drajnauth/Phoenix612/Phoenix612 Complete/Version 1.1/Phoenix612 Complete v1.1.jpg

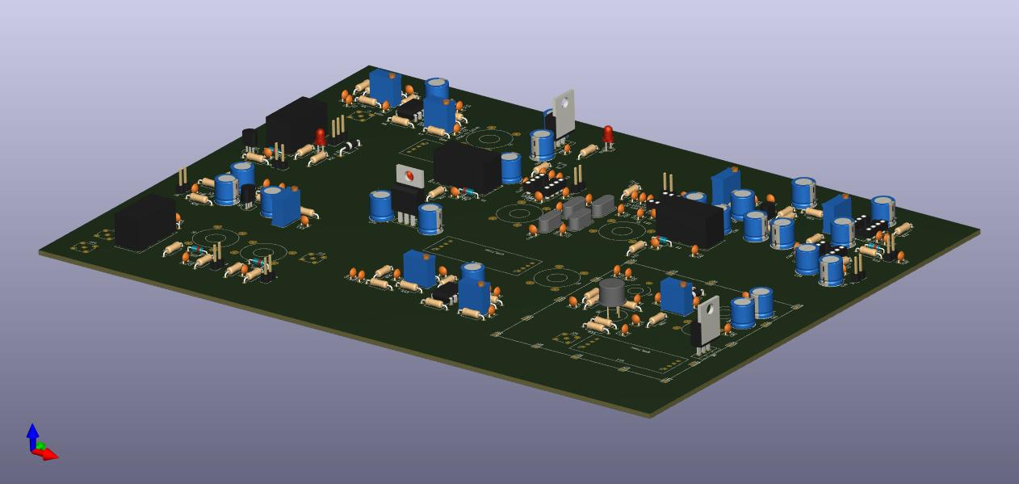
Phoenix612 Complete/Version 1.1/Phoenix612 Complete v1.1.jpg
