drajnauth/Phoenix612/README.md

# Phoenix612
Phoenix612 Transceiver Board

This is the updated `Dueling 612 Tranceiver`.  It contains the KiCad schematic and pcb files as well as other design artifacts.

The project has been renamed to `Phoenix612`
