drajnauth/Phoenix612/Custom KiCad for Phoenix612.docx

Custom Symbols for Phoenix612: Open “Manage Symbol Libraries” and add a library as below.

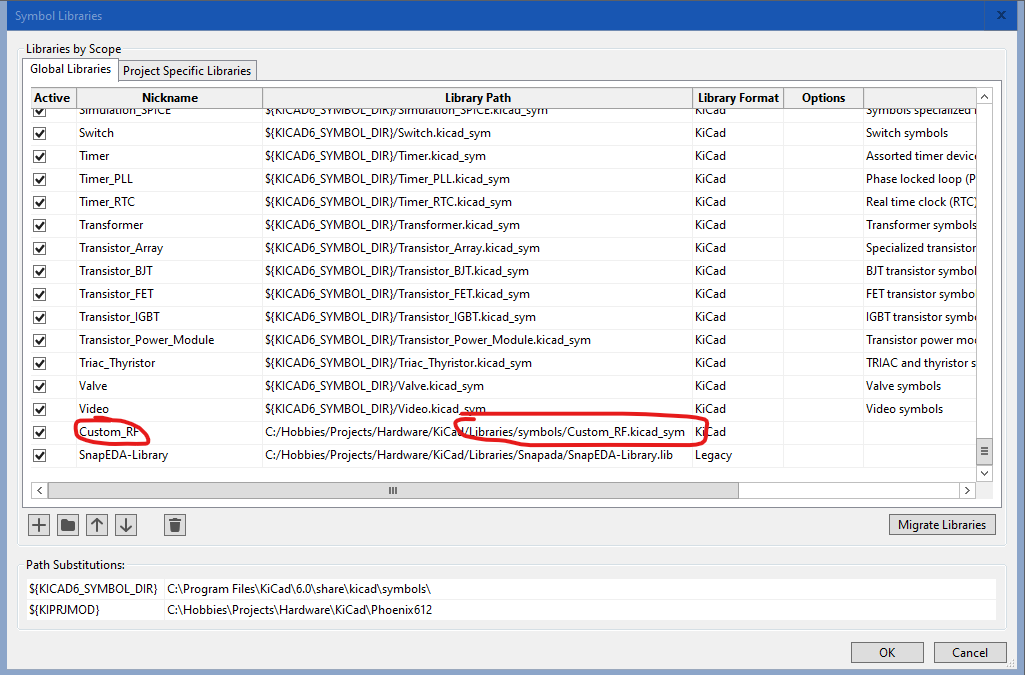
[picture p2: figure]

Custom Footprints for Phoenix 612: Open “Manage Footprint Libraries” and add a library as below.

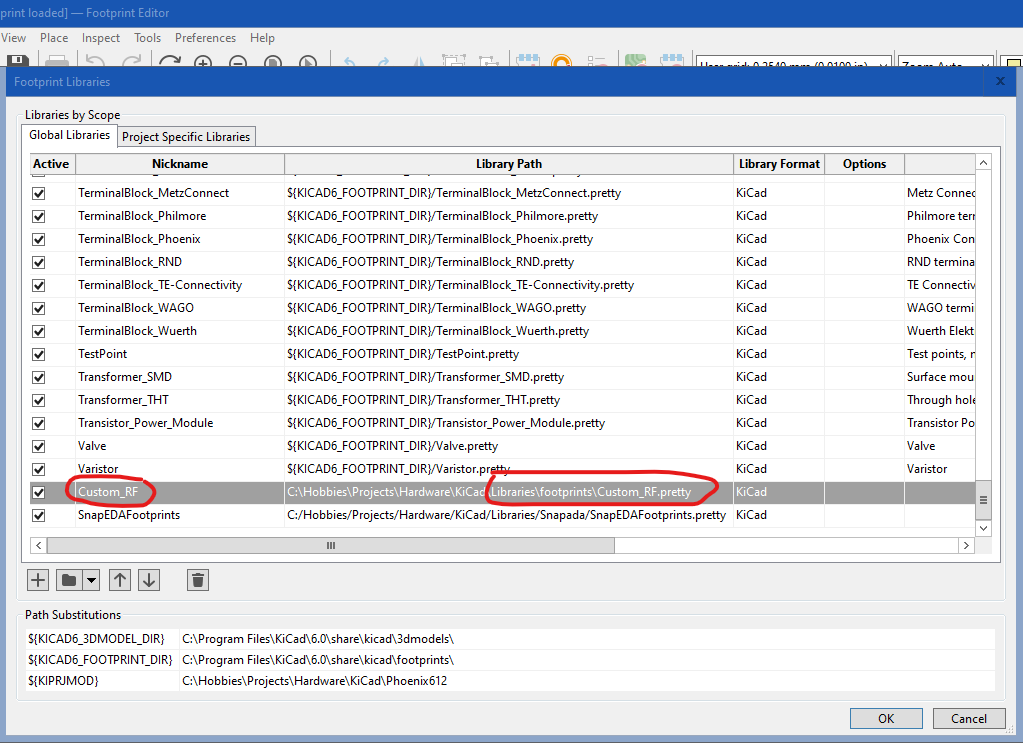
[picture p3: figure]

In symbol editor/browser you should have a new symbol library with custom symbols

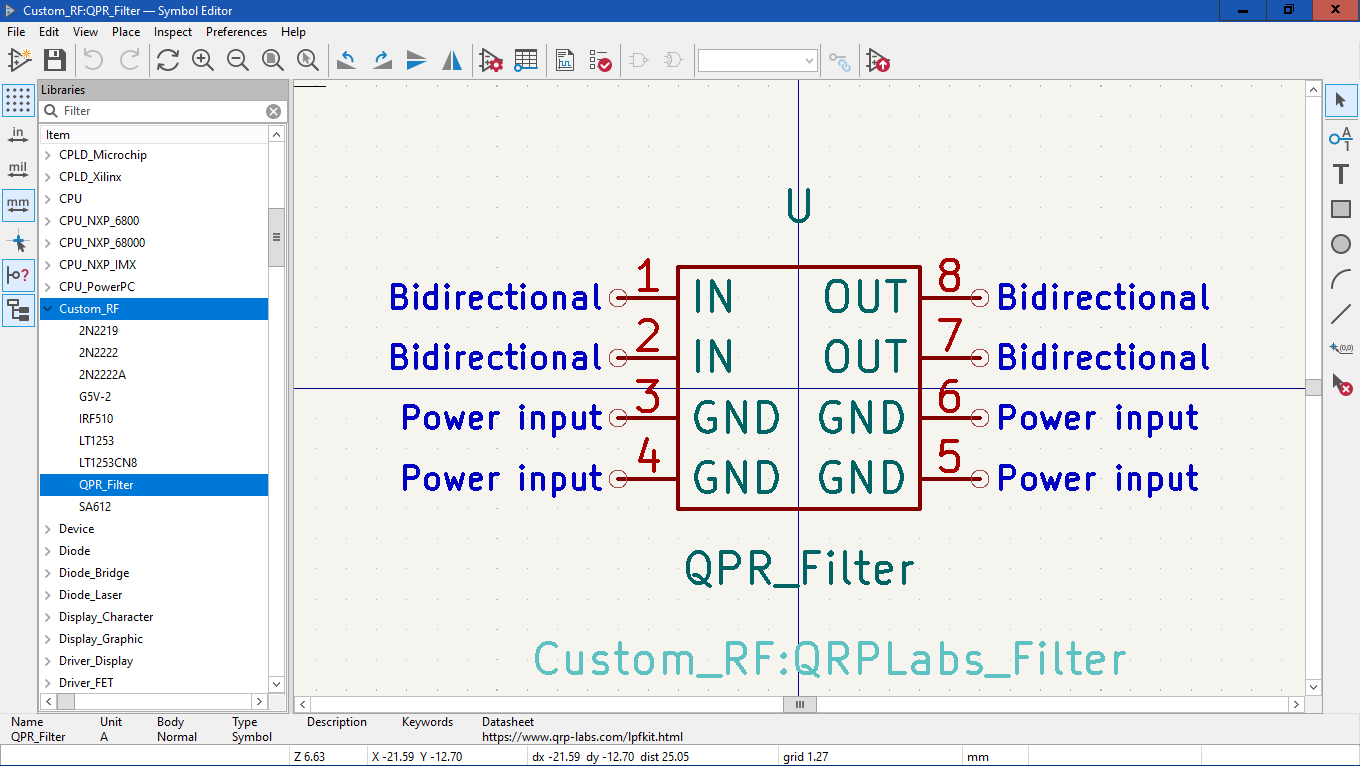
[picture p4: figure]

In footprints editor/browser you should have a new footprint library with custom footprints

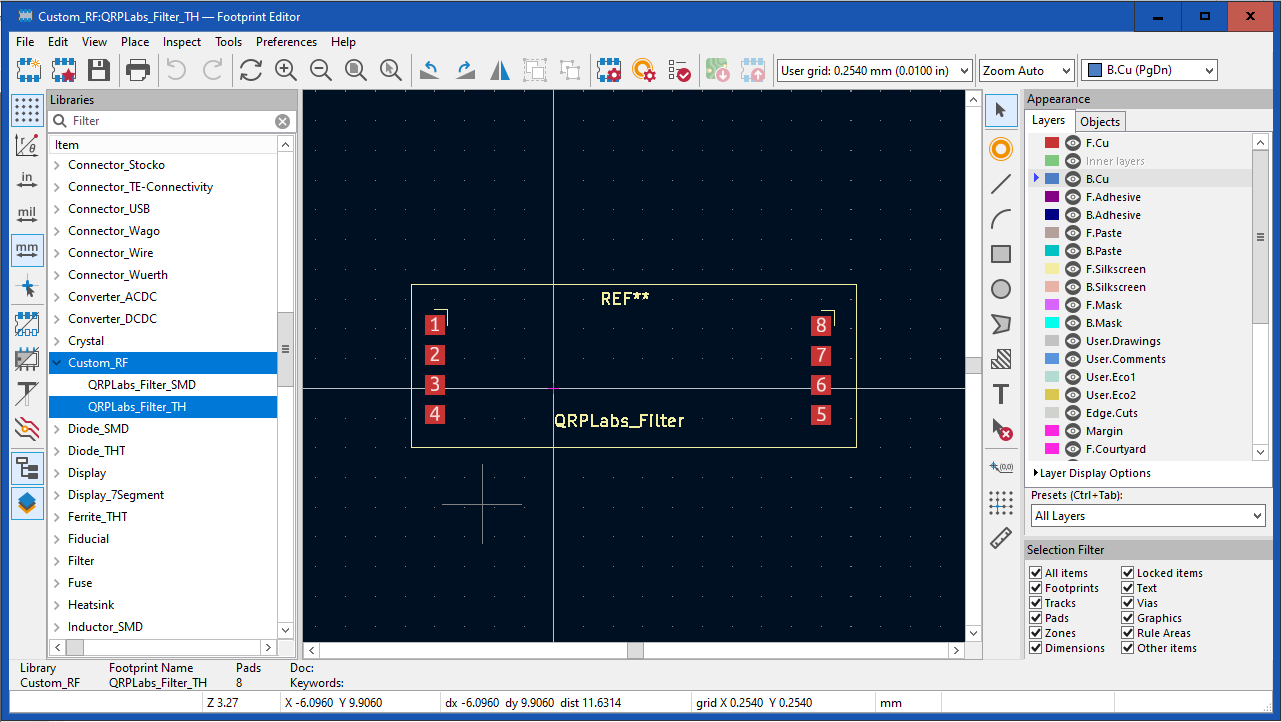
[picture p5: figure]
