drajnauth/Phoenix612/Analysis/Calculations/Power Amp Ideas.docx

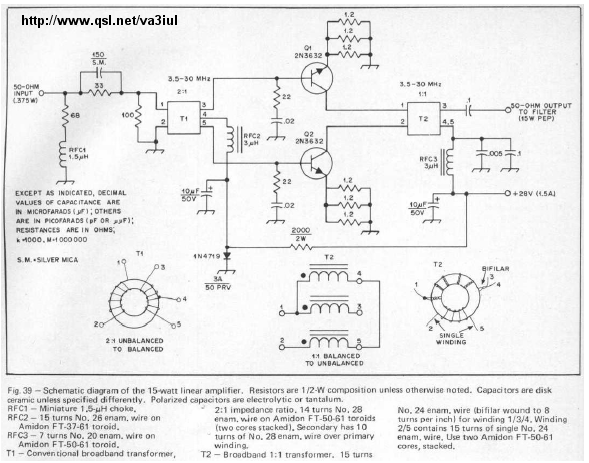
[picture p15: figure]
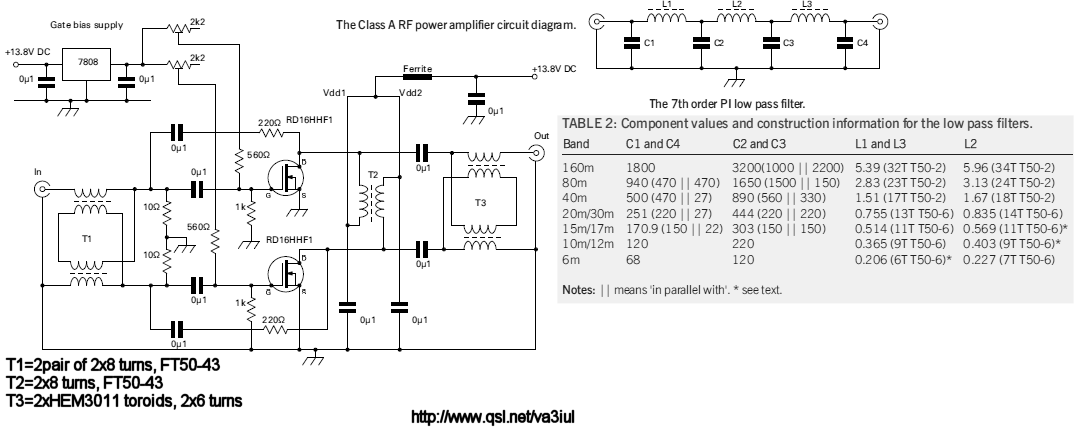
[picture p16: figure]
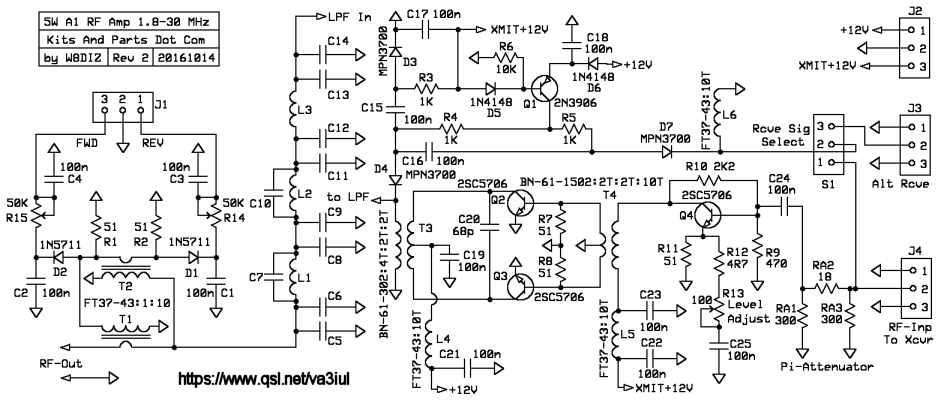
[picture p17: figure]
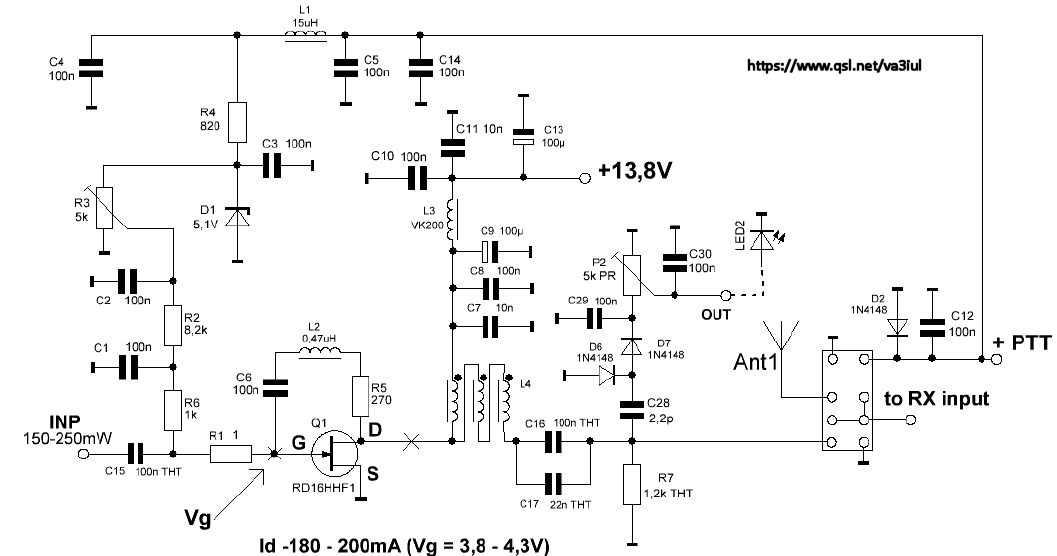
[picture p18: figure]
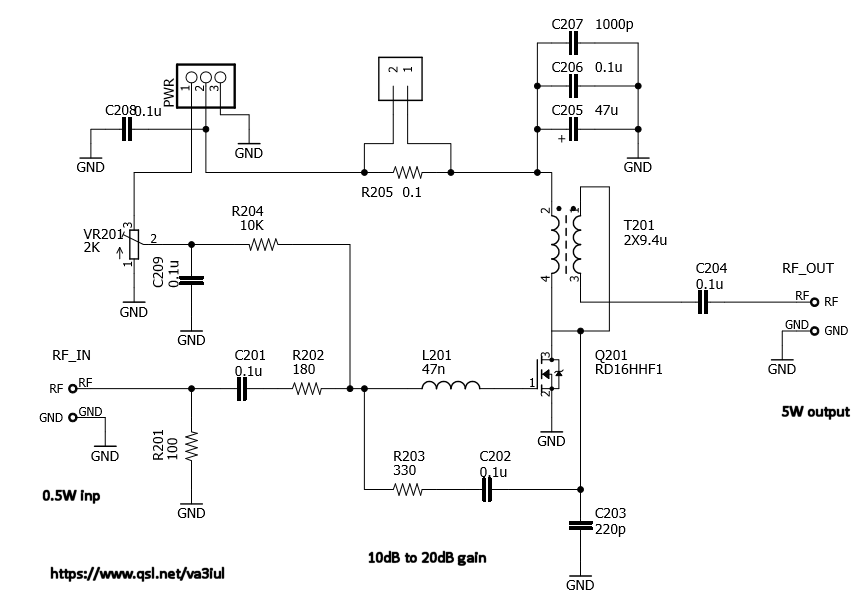
[picture p19: figure]
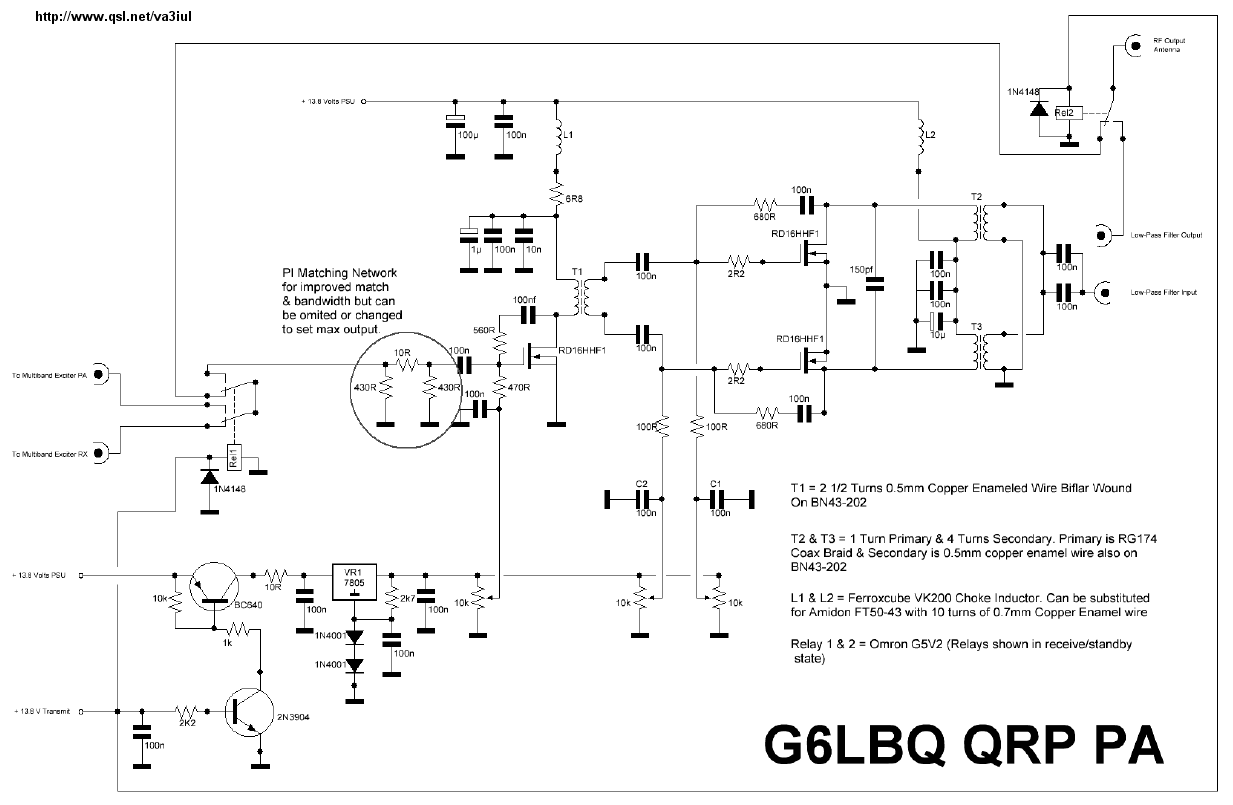
[picture p20: figure]

https://yo4hhp.wordpress.com/2012/10/22/20w-hf-amplifier-with-rd16hhf1-k5bcq-ki/

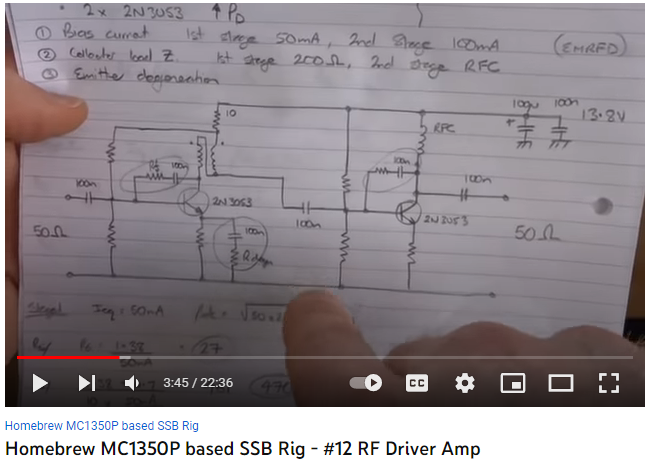
[picture p21: figure]
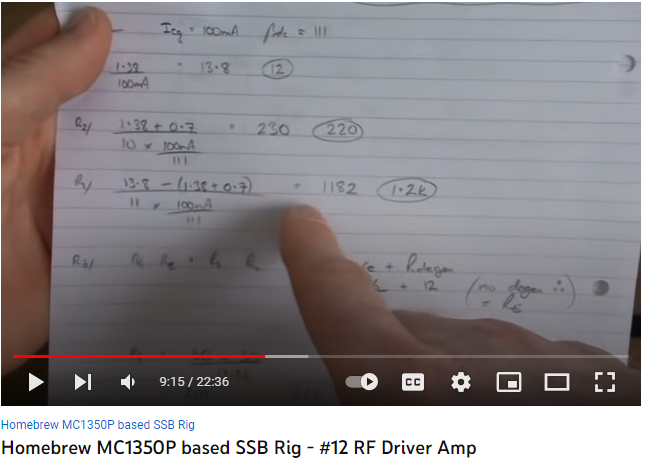
[picture p22: figure]

https://www.youtube.com/watch?v=yEmUkqqU_vA
