drajnauth/Phoenix612/Analysis/Calculations/PoC PA Measurements v2.xlsx

Sheet: Stage Characterization
BPFOutput |  |  |  |  |  |  |  |  | Input to SA612 |  |  |  |  | LT1253 Output |  |  |  | 2N3904 Output |  |  |  | 2N2219 Output
RF(Freq) | LO(Freq) | RF(in) (No Att) | LO(in) | Band | Freq | LO (No Att) | RF (No Att) | Out (No Att) | RF(Freq) | LO(Freq) | Freq | RF(in) (No Att) | LO(in) | LO (No Att) | RF (No Att) | Out (No Att) | Harmonic (No Att) | LO (No Att) | RF (No Att) | Out (No Att) | Harmonic (No Att) | LO (No Att) | RF (No Att) | Out (No Att) | Harmonic (No Att) |  |  | Observations 1) Output of 3904 is too hot for 2219 Stage. Harmonics result 2) 40m Output of LT1253 is marginal for 3904. At the brink of being too hot 3) Gain of 2219 drops off above 20m
12 | 15.75 | -60 | -10 | 80 | 3.75 |  |  | -64 | 12 | 15.75 | 3.75 | -60 | -10 |  |  | -28 |  |  |  | -8 |  |  |  | 6
12 | 15.75 | -40 | -10 | 80 | 3.75 |  |  | -44 | 12 | 15.75 | 3.75 | -40 | -10 | -63 | -55 | -8 |  |  |  | 12 | -27 |  |  | 23 | +2, +9 | Max Rfin is -56 dBm (No atten)
12 | 19.12 | -60 | -10 | 40 | 7.12 |  |  | -62 | 12 | 19.12 | 7.12 | -60 | -10 | -61 | -64 | -27 |  |  |  | -8 |  | 30 | 30 | 15 | -19, -26
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
