drajnauth/Phoenix612/Analysis/Calculations/PoC PA Measurements.xlsx

Sheet: Stage Characterization
SA612 Output |  |  |  |  |  |  |  |  | LT1253 Output |  |  |  | 2N3904 Output |  |  |  | 2N2219 Output
RF(Freq) | LO(Freq) | RF(in) (No Att) | LO(in) | Band | Freq | LO (No Att) | RF (No Att) | Out (No Att) | LO (No Att) | RF (No Att) | Out (No Att) | Harmonic (No Att) | LO (No Att) | RF (No Att) | Out (No Att) | Harmonic (No Att) | LO (No Att) | RF (No Att) | Out (No Att) | Harmonic (No Att)
12 | 15.75 | -60 | -10 | 80 | 3.75 | -55 | -77 | -61 |  |  | -26 |  |  |  | -8 |  |  |  | 8
12 | 15.75 | -40 | -10 | 80 | 3.75 | -33 | -63 | -58 |  |  | -6 | -53 |  |  | 12 | -27 |  |  | 24 | 12
12 | 19.12 | -60 | -10 | 40 | 7.12 | -55 | -74 | -62 |  |  | -26 |  |  |  | -8 |  | -32 | -35 | 16 | -27
12 | 19.12 | -40 | -10 | 40 | 7.12 | -33 | -64 | -59 |  | -48 | -6 | -49 |  | -30 | 12 | -27 |  | -30 | 25 | 12
12 | 26.12 | -60 | -10 | 20 | 14.12 | -55 | -76 | -64 |  |  | -28 |  |  |  | -11 |  | -36 | -27 | 0
12 | 26.12 | -40 | -10 | 20 | 14.12 | -33 | -64 | -61 | -51 | -39 | -8 |  |  | -22 | 9 |  | -26 | -9 | 20 | -4
12 | 33.2 | -60 | -10 | 10 | 21.2 | -56 | -76 | -67 |  |  | -34 |  |  |  | -17 |  |  |  | -10
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
