drajnauth/Phoenix612/Dueling 612 Diptrace/Dueling 612s - Complete.pdf

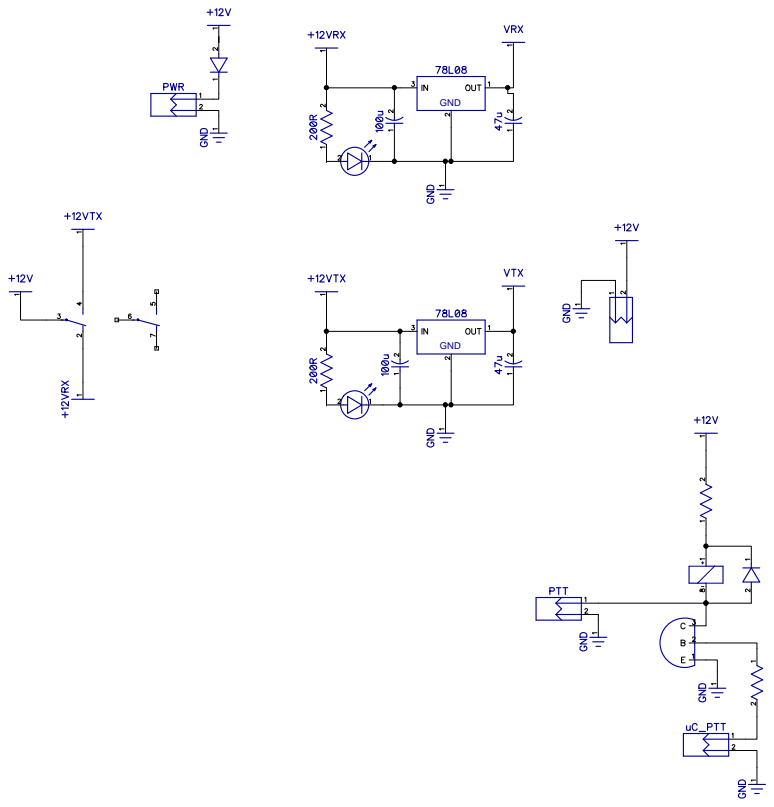
[picture p32: page 1]
GND
