drajnauth/Phoenix612/Dueling 612 Diptrace/Dueling 612s - Development Platform 5.pdf

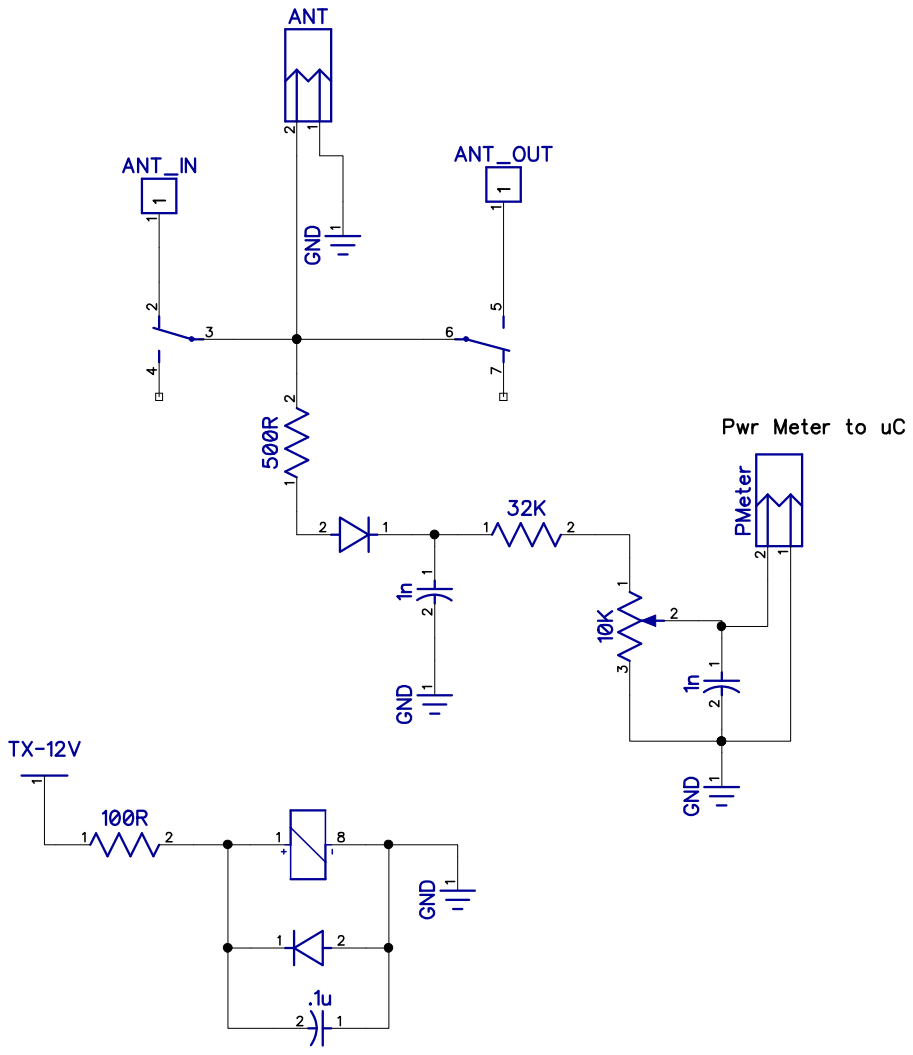
[picture p33: page 1]

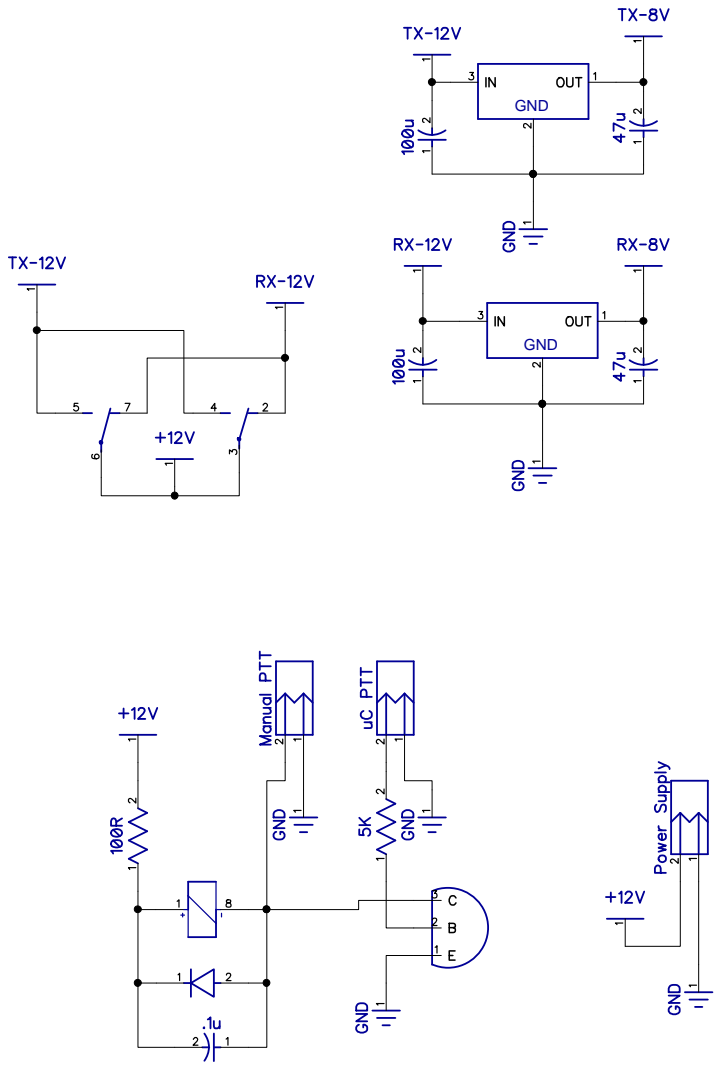
[picture p34: page 2]
GND
