drajnauth/Phoenix612/Dueling 612 Diptrace/Dueling 612s RxTx V2 Test - Silk.pdf

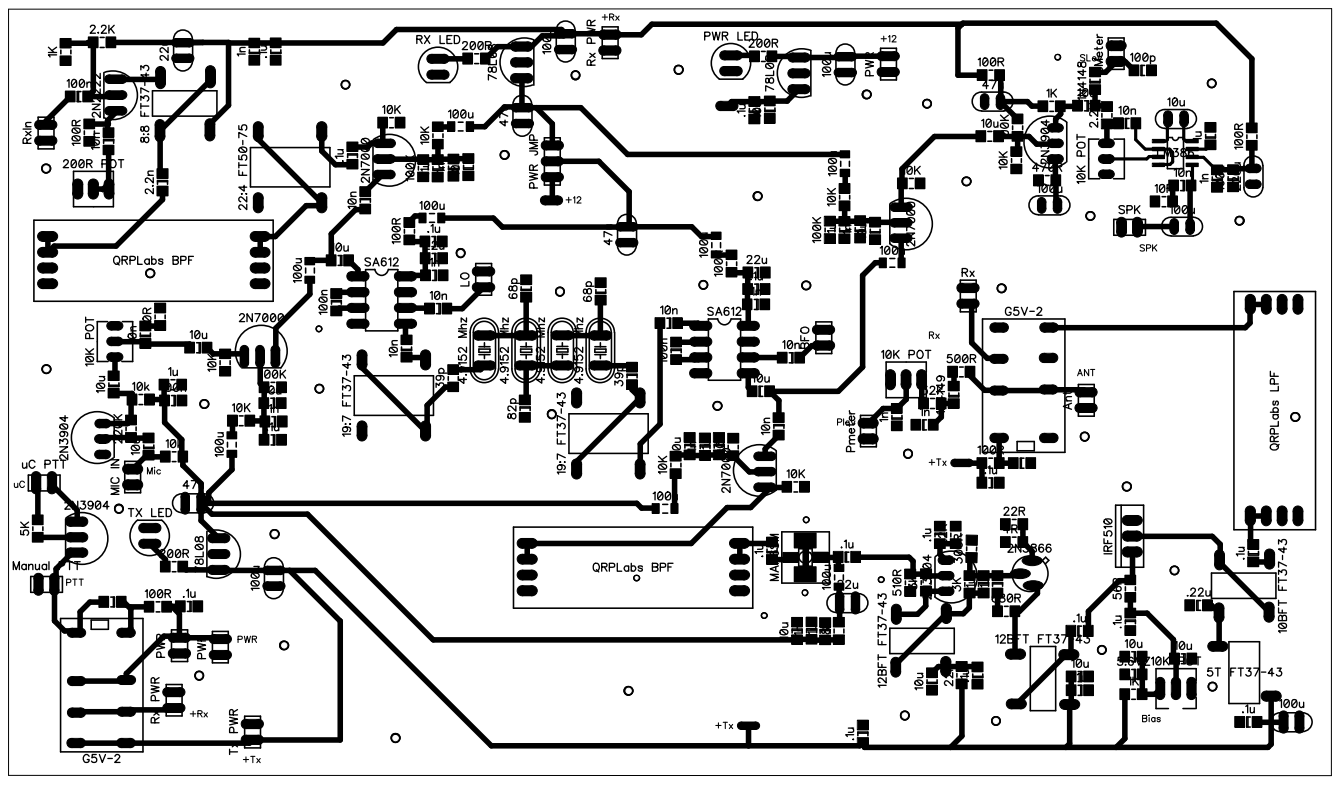
[picture p35: page 1]
