drajnauth/Phoenix612/Dueling 612 Diptrace/Dueling 612s RxTx V2 Test - Top.pdf

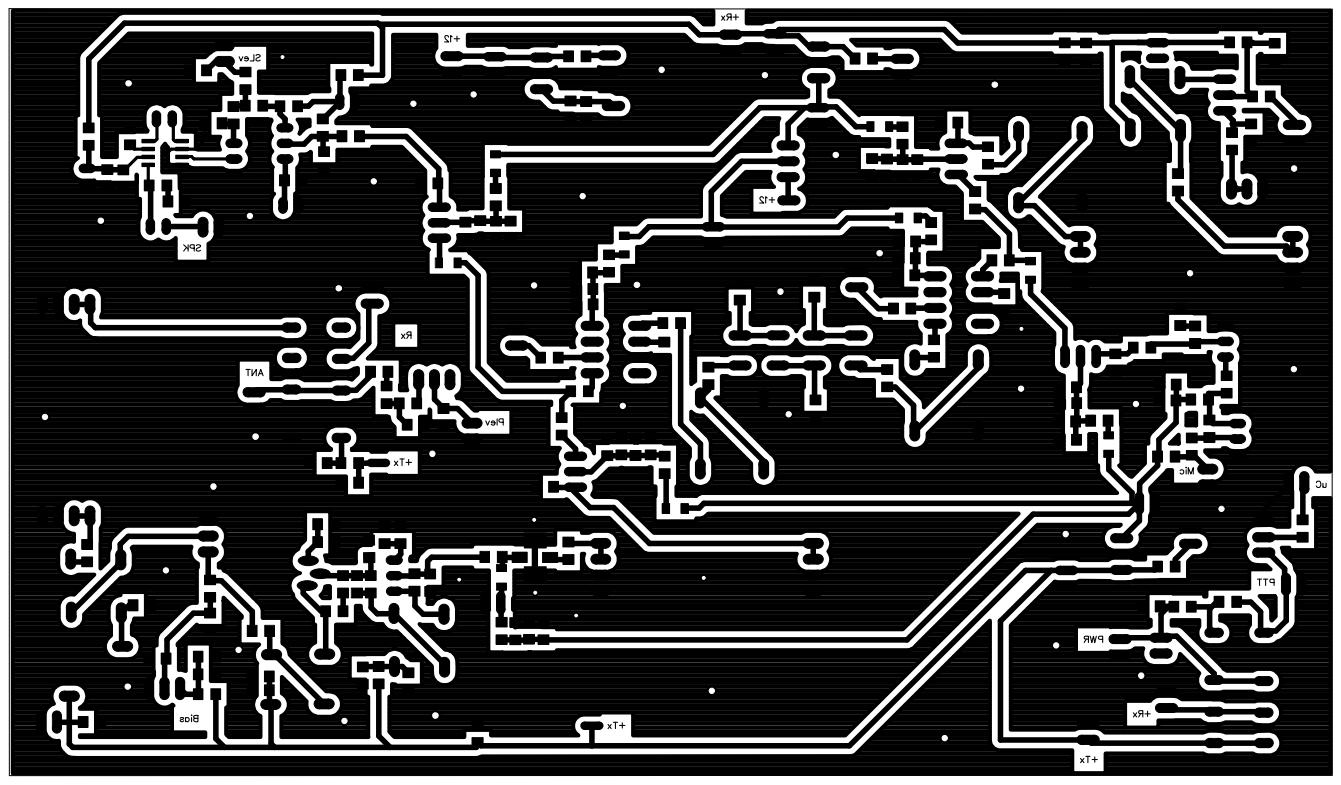
[picture p36: page 1]
