drajnauth/Phoenix612/sMeter Daughter Board v1/sMeter Daughter Board v1.kicad_sch.pdf

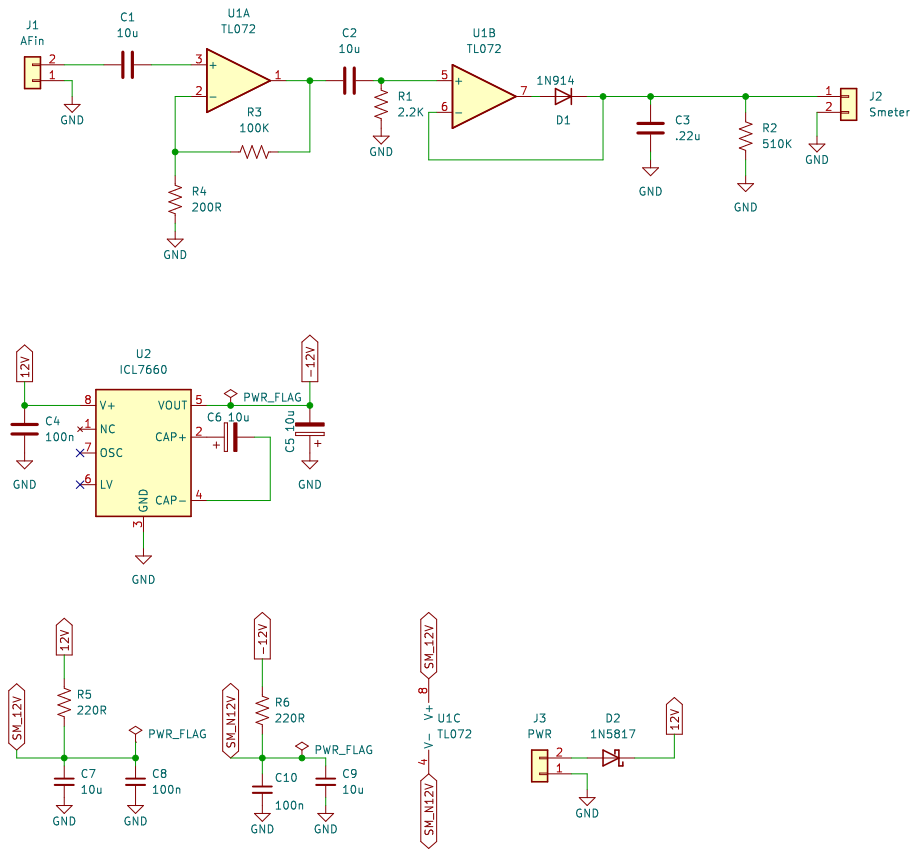
[picture p37: page 1]
