drajnauth/Phoenix612/Dueling 612 Diptrace/Dueling 612s - Complete 2.pdf

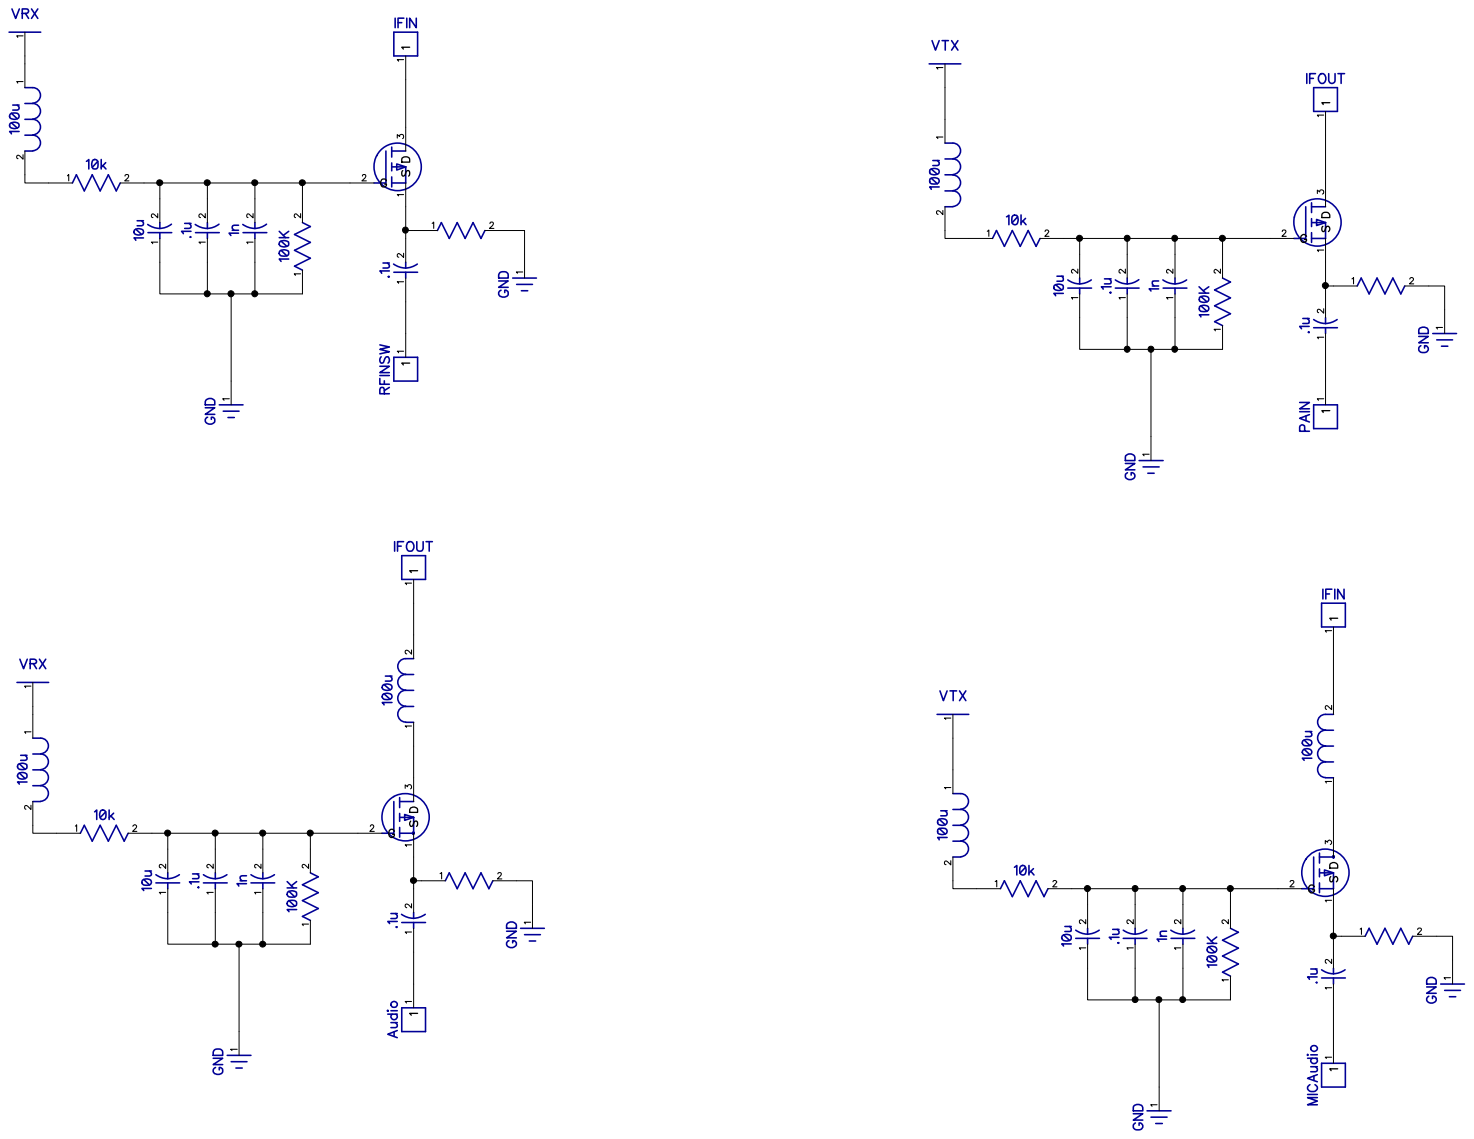
[picture p38: page 1]

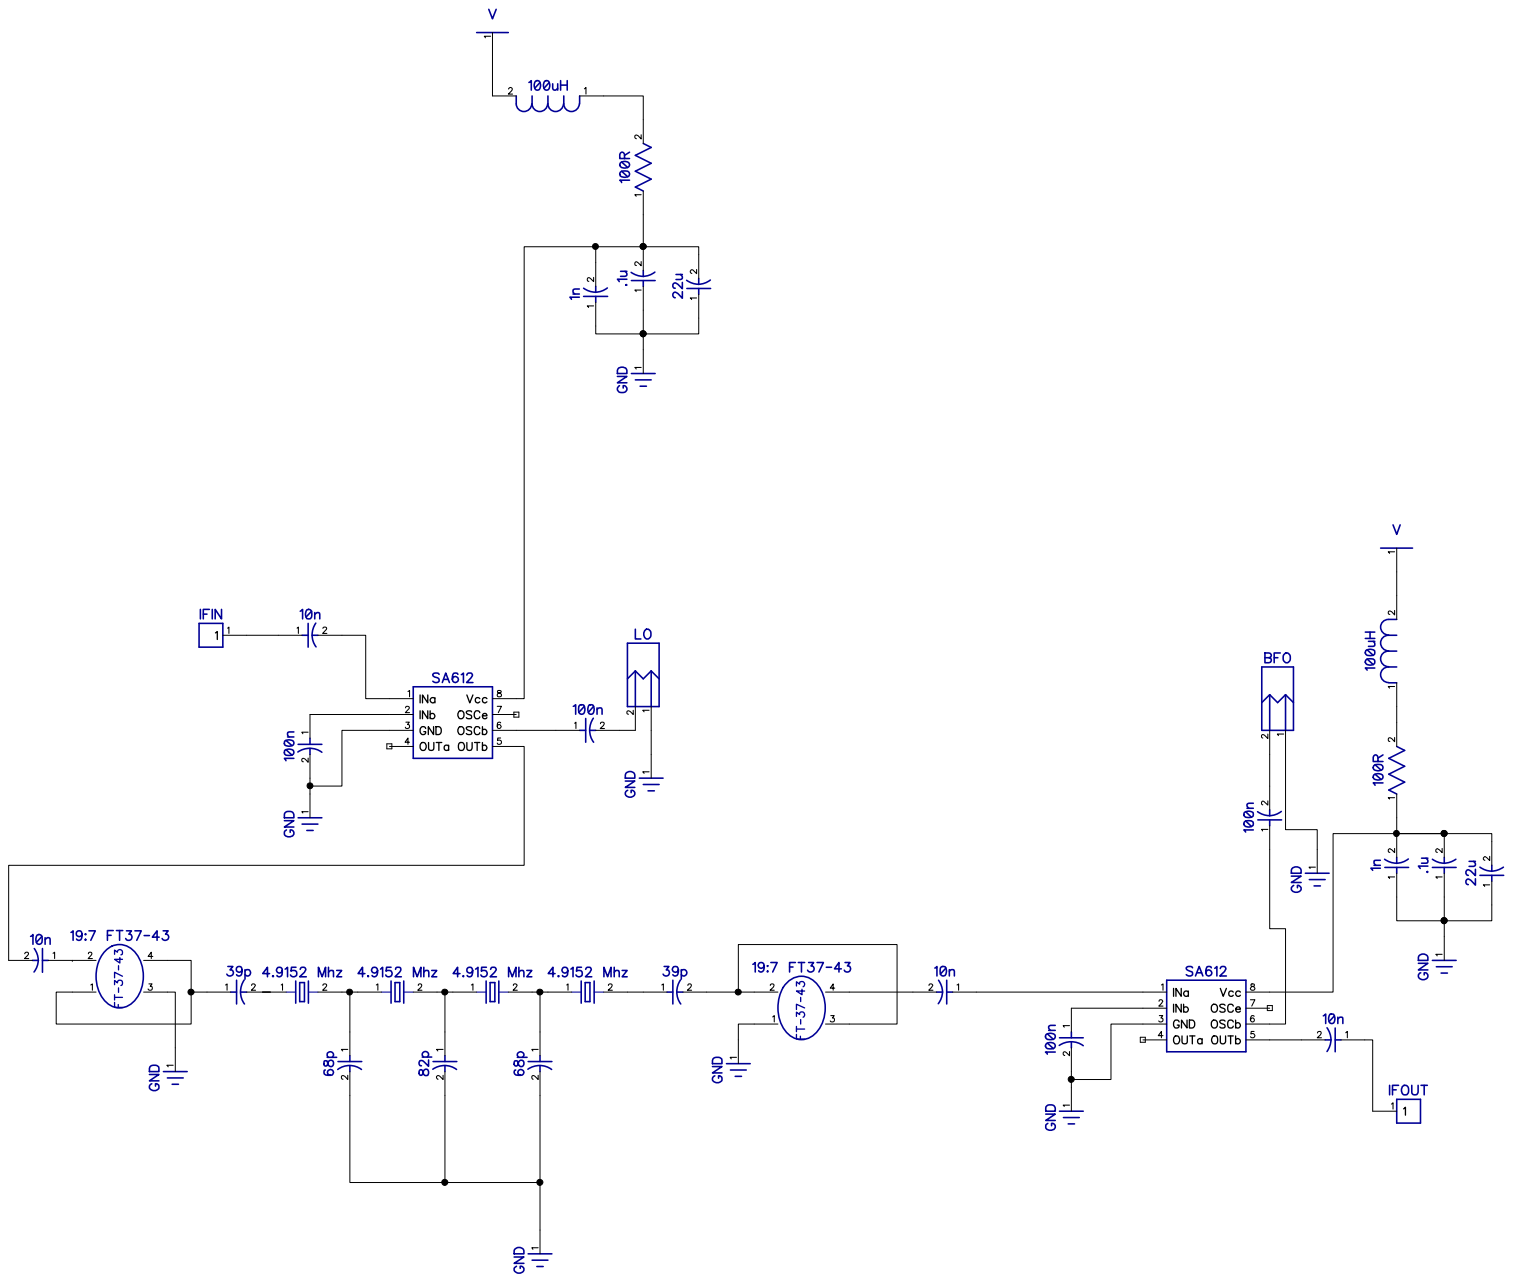
[picture p39: page 2]

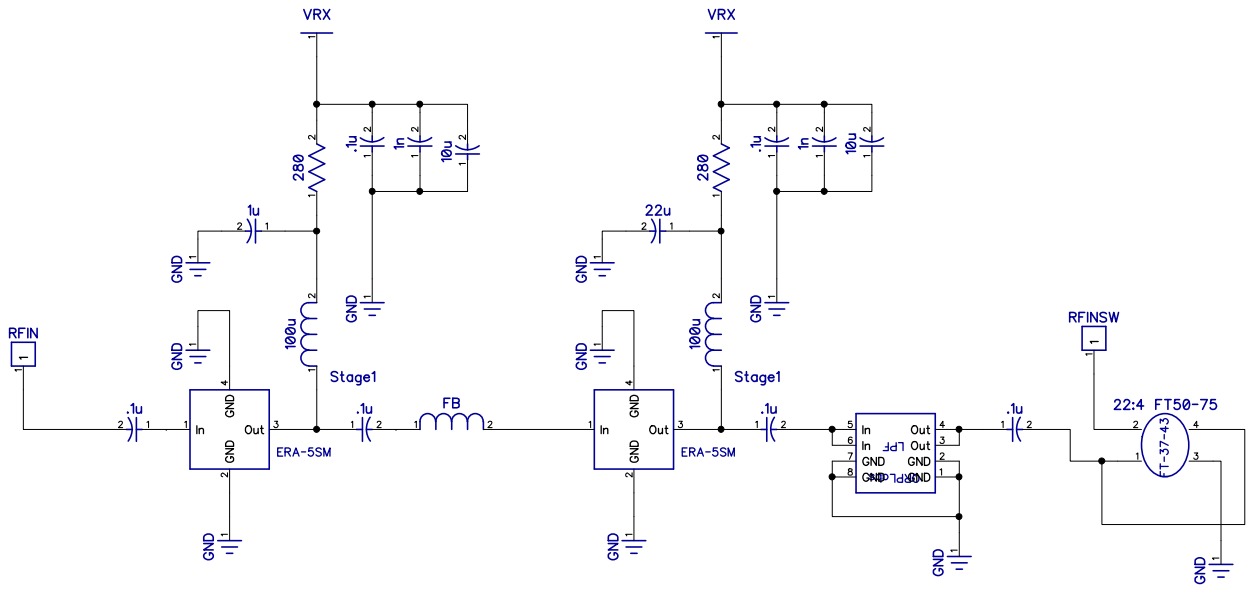
[picture p40: page 3]

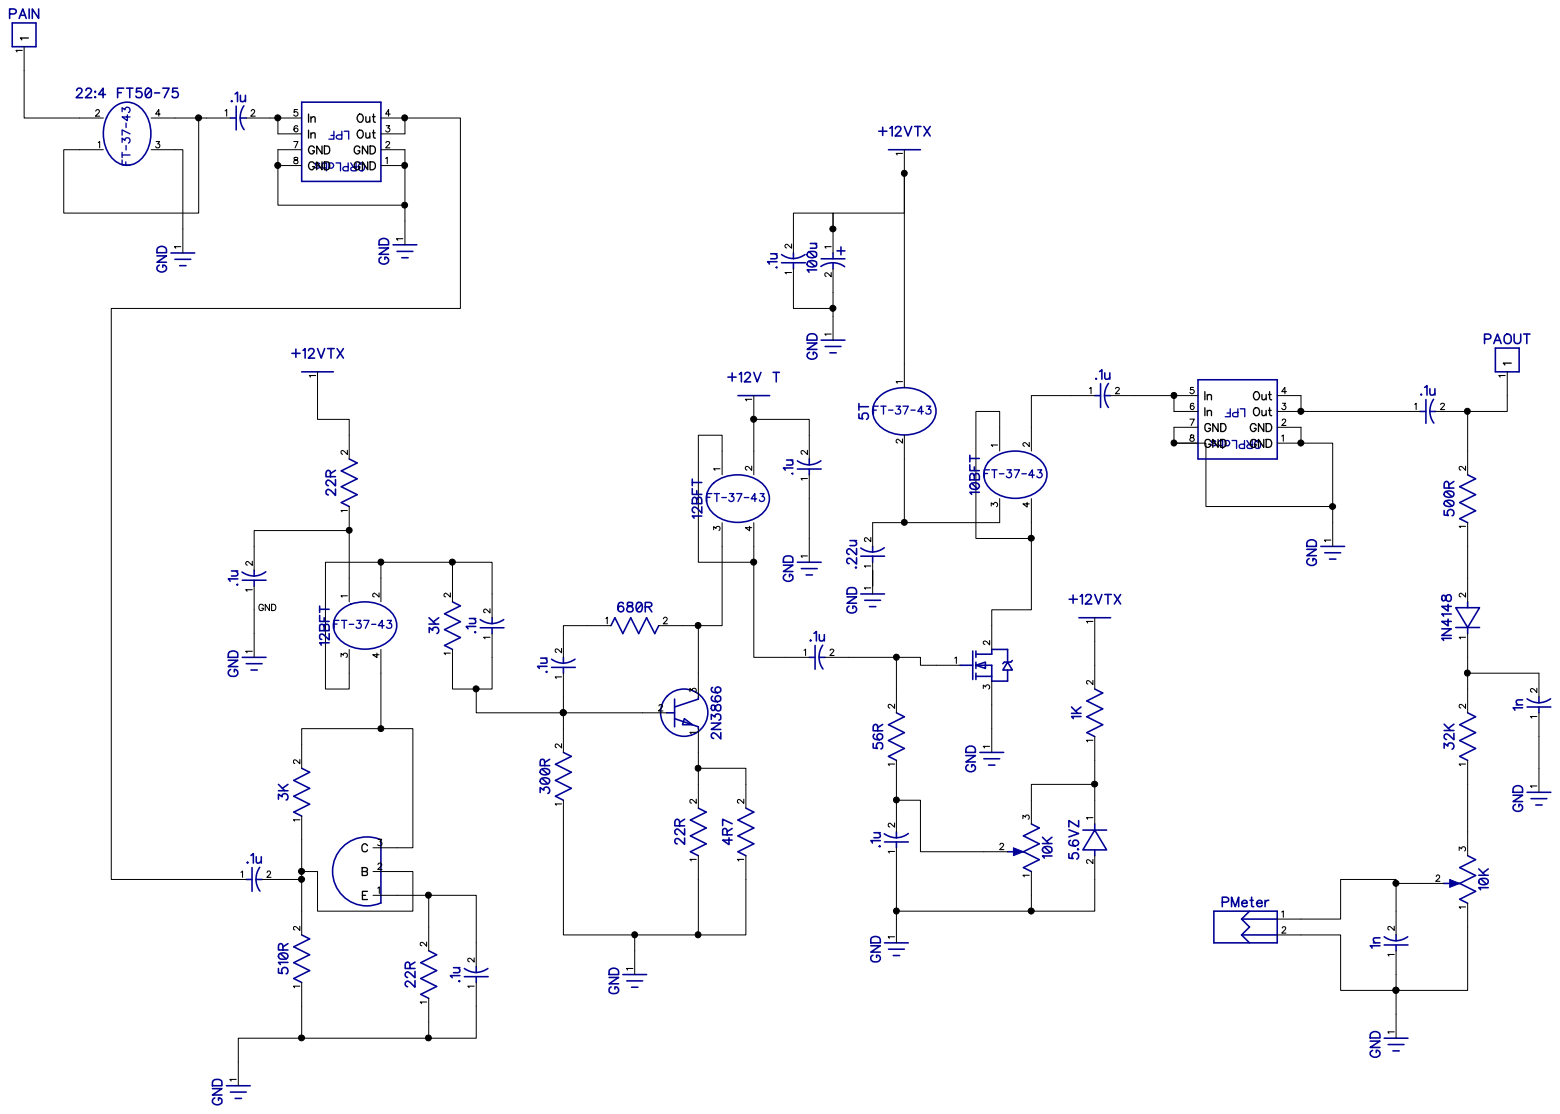
[picture p41: page 4]

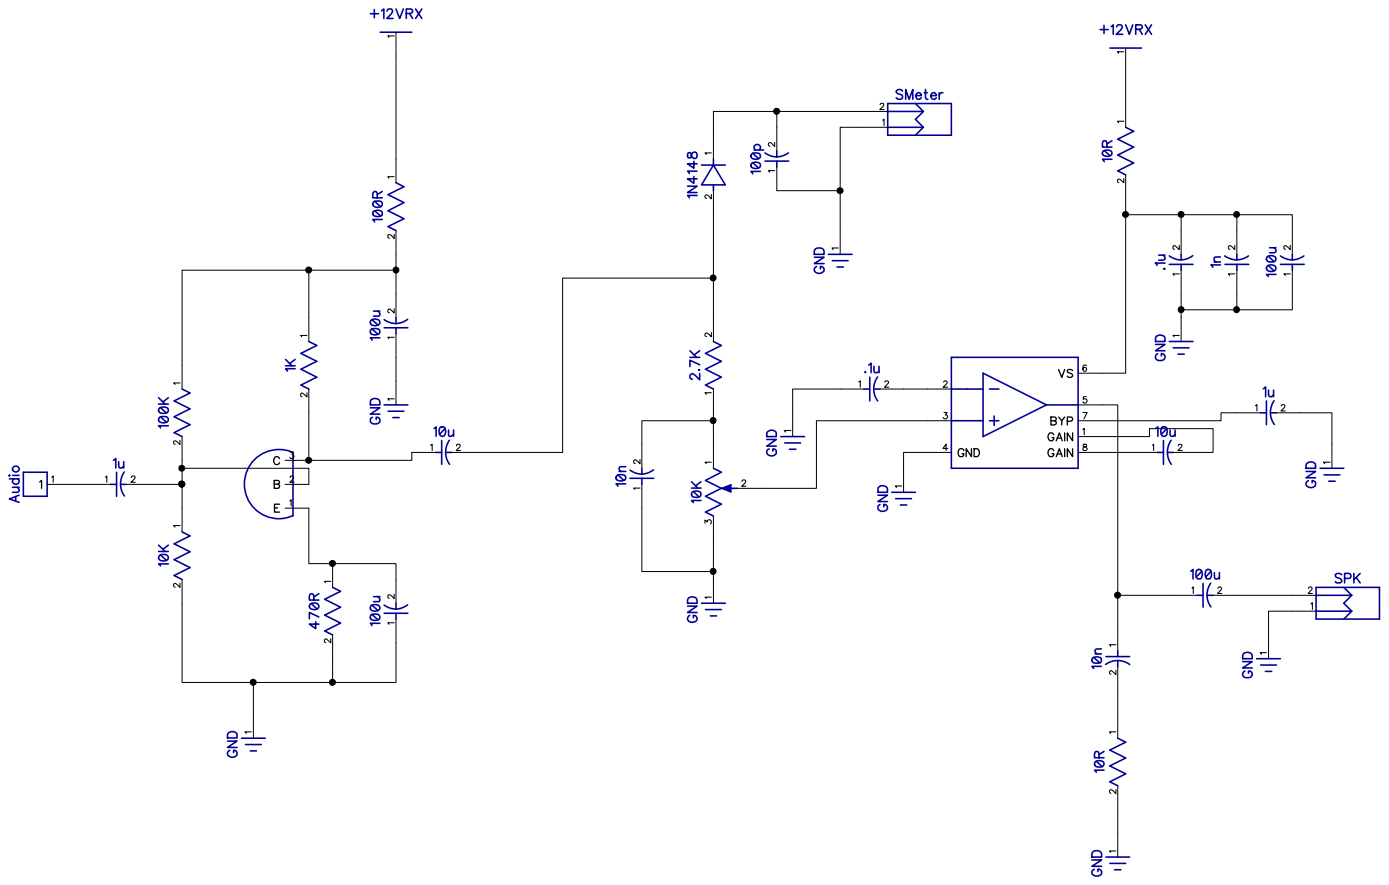
[picture p42: page 5]

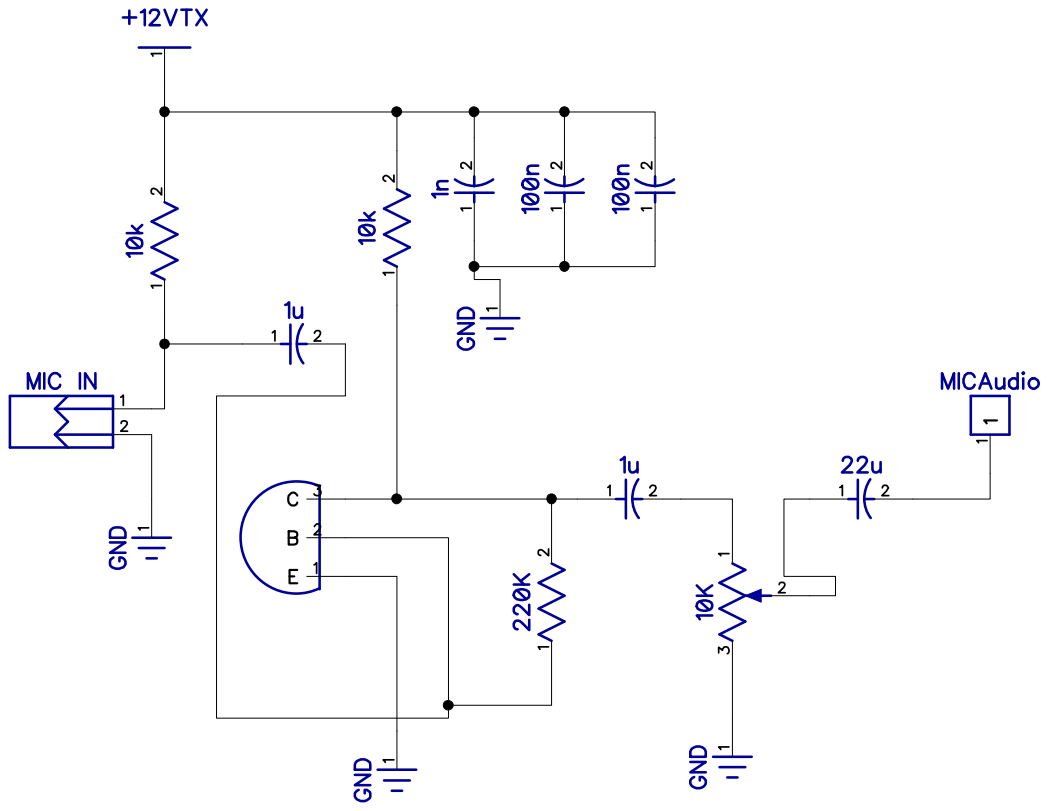
[picture p43: page 6]
