drajnauth/Phoenix612/Dueling 612 Diptrace/Dueling 612s - Development Platform 1.pdf

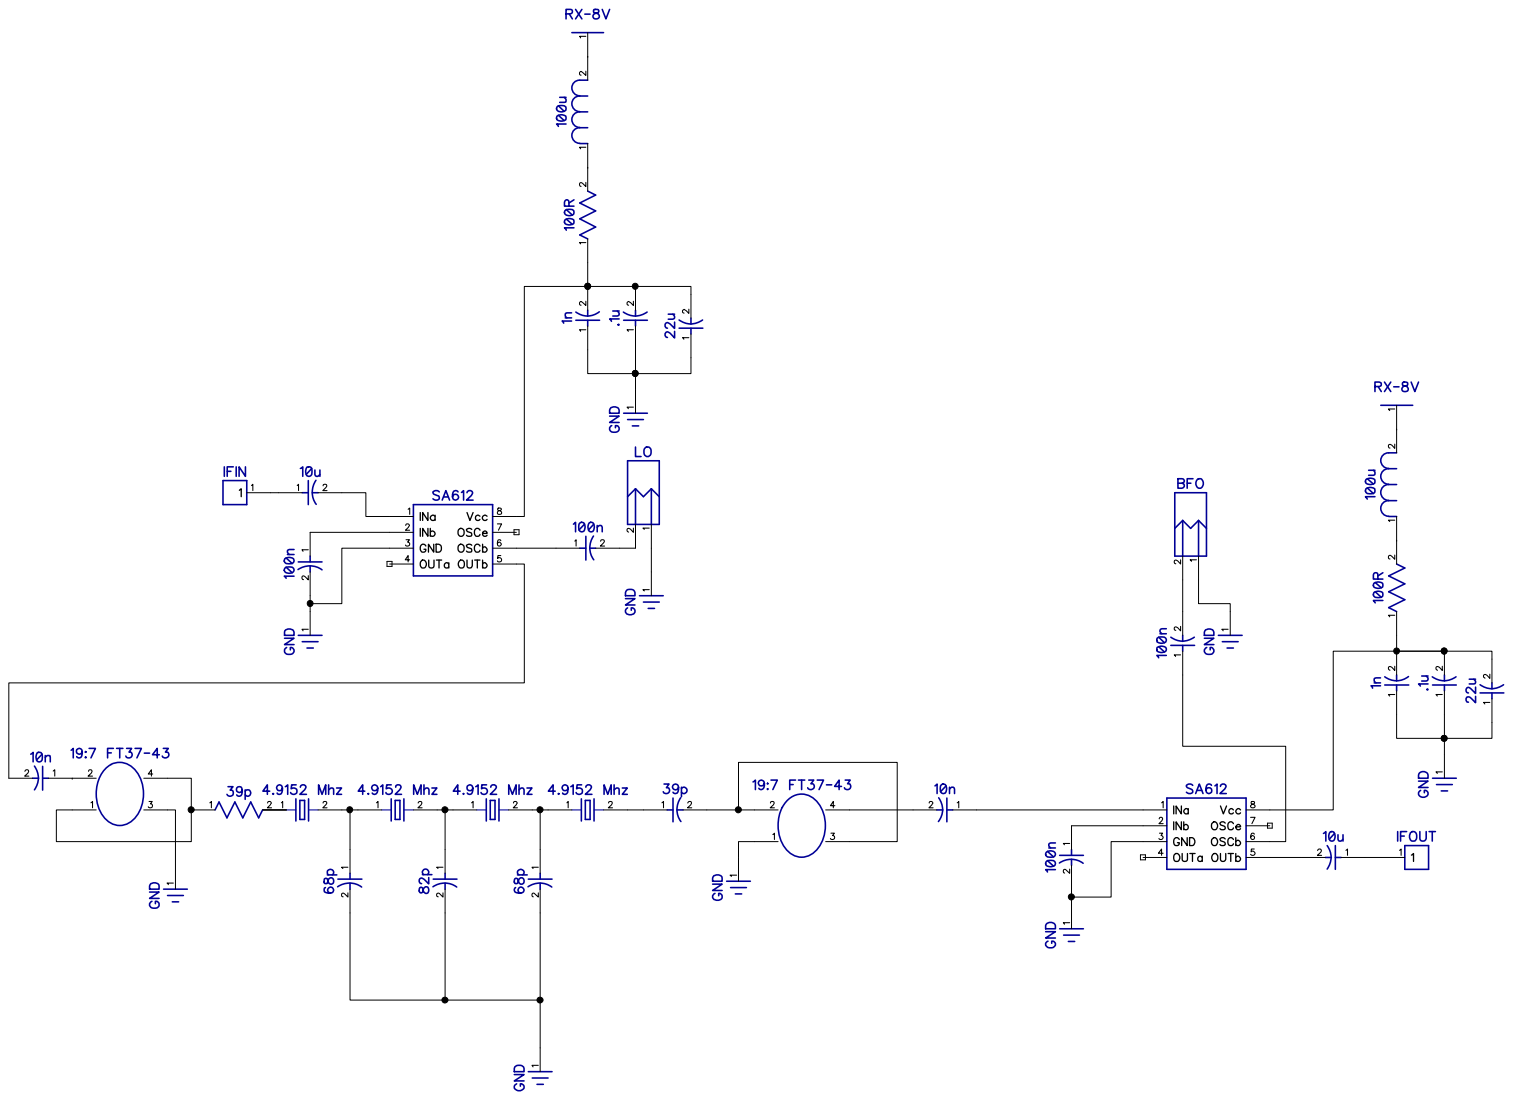
[picture p44: page 1]

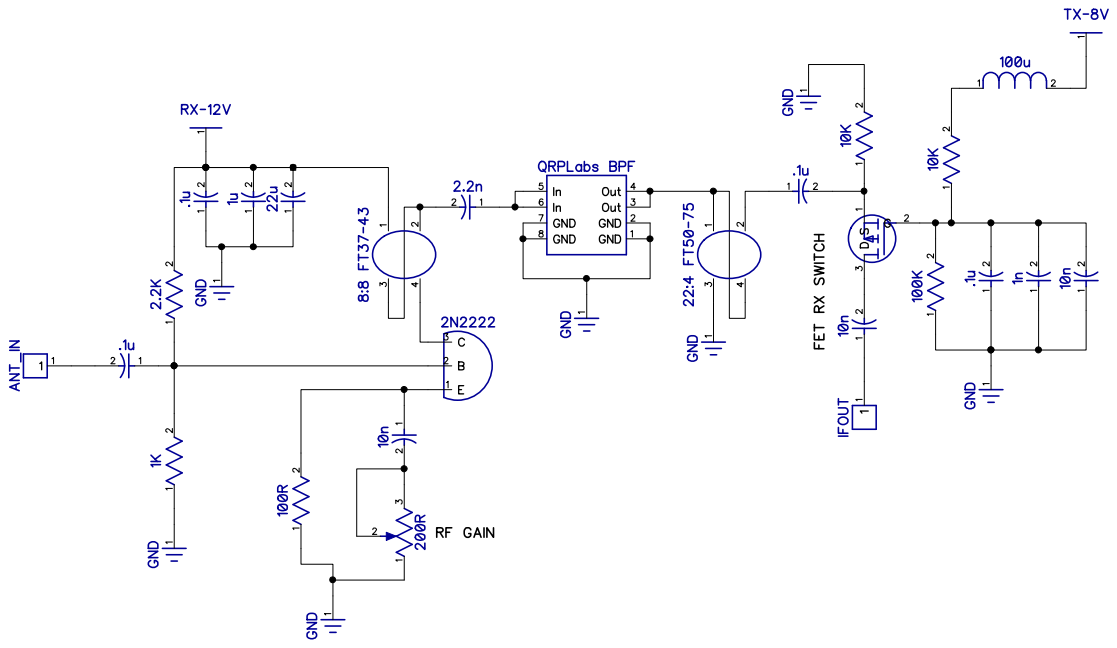
[picture p45: page 2]
