drajnauth/Phoenix612/Dueling 612 Diptrace/Dueling 612s - Development Platform 2.pdf

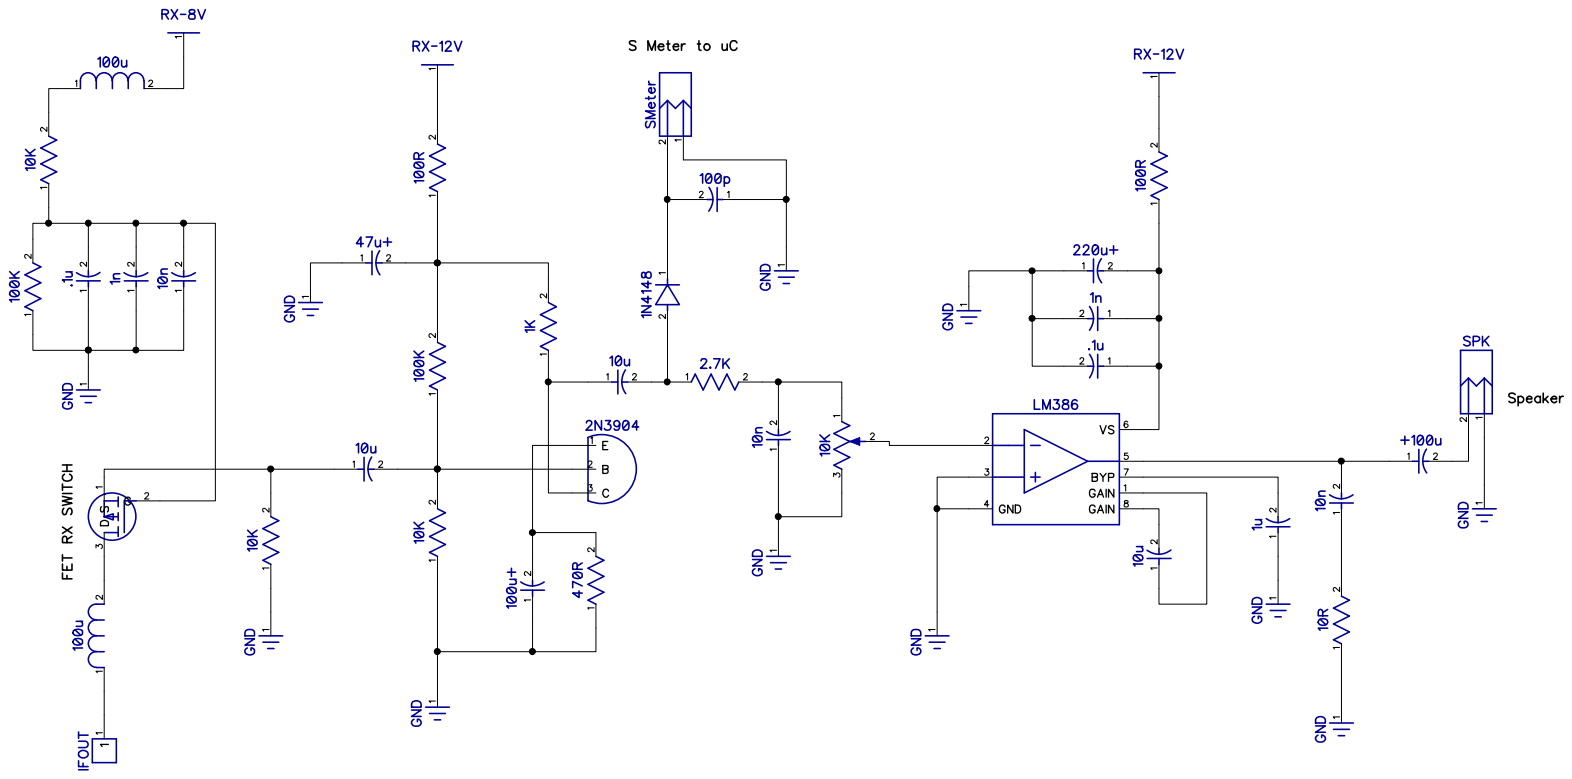
[picture p46: page 1]
