drajnauth/Phoenix612/Dueling 612 Diptrace/Dueling 612s - Development Platform 3.pdf

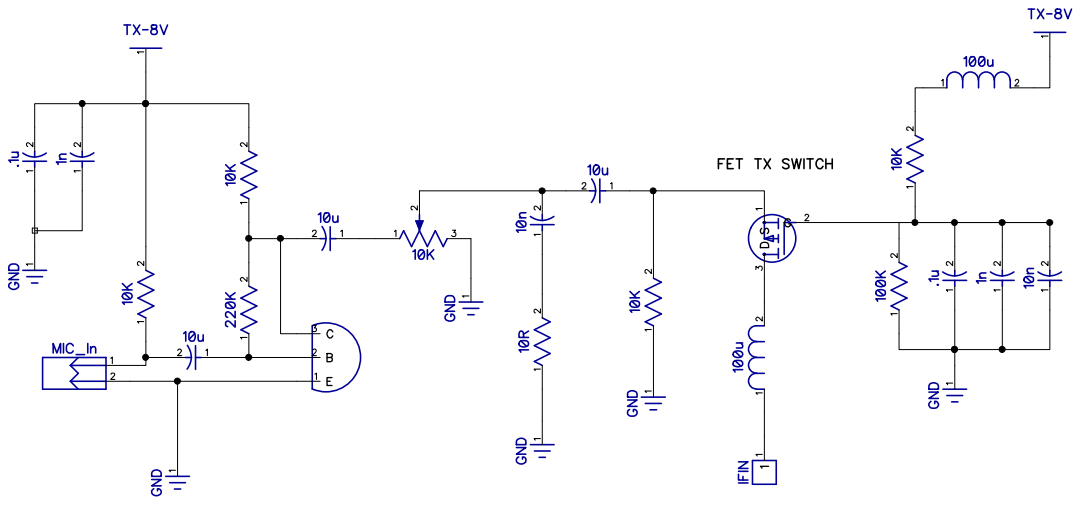
[picture p47: page 1]

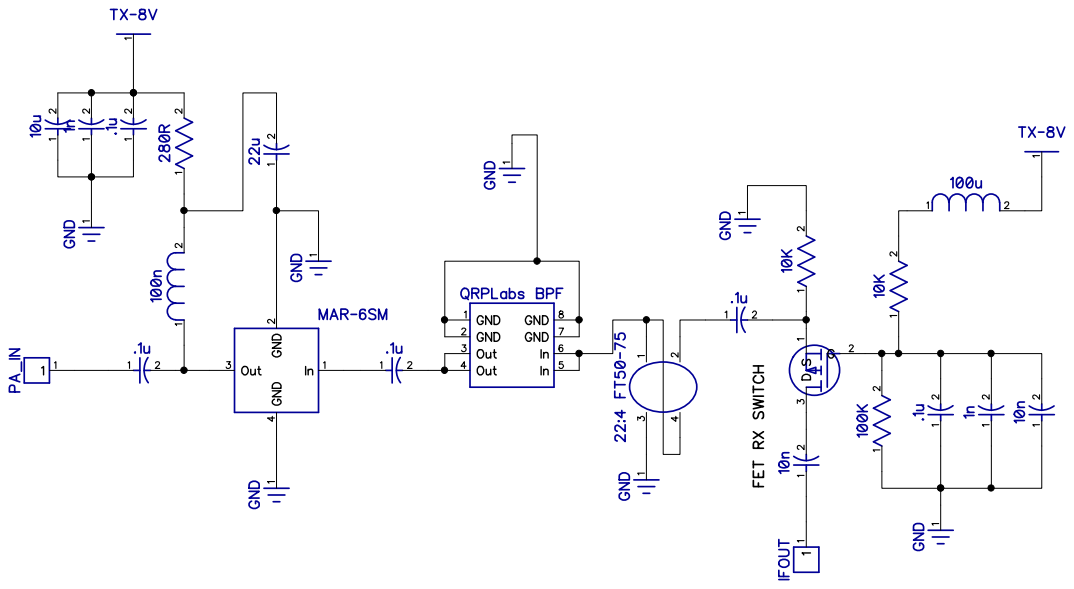
[picture p48: page 2]
