drajnauth/Phoenix612/Dueling 612 Diptrace/Dueling 612s - Development Platform 4.pdf

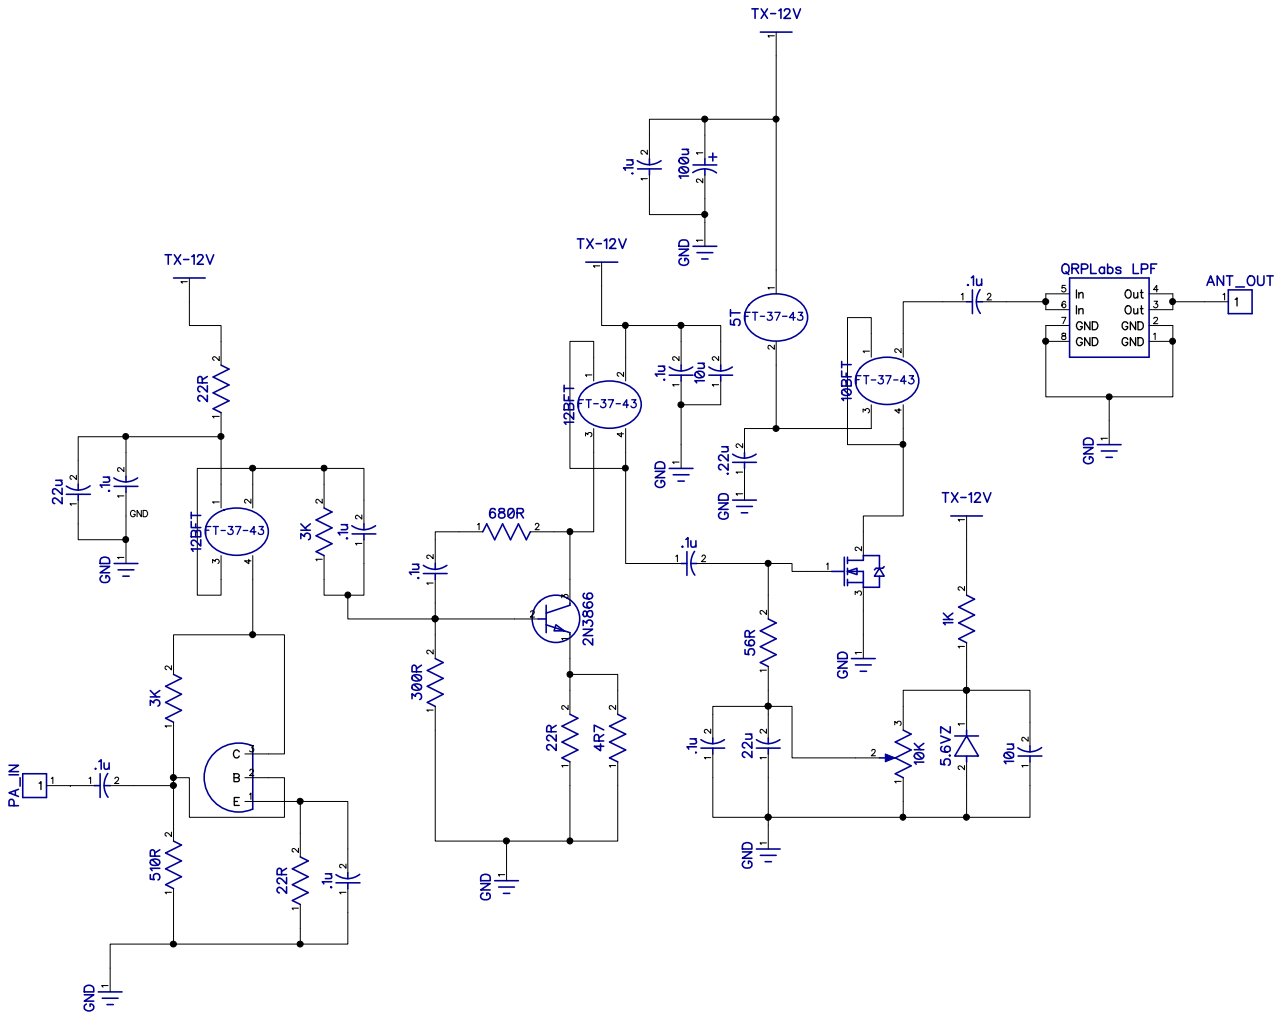
[picture p49: page 1]
