drajnauth/Phoenix612/Phoenix612 Complete/Version 1.1/Phoenix612 Complete v1.1.kicad_sch.pdf

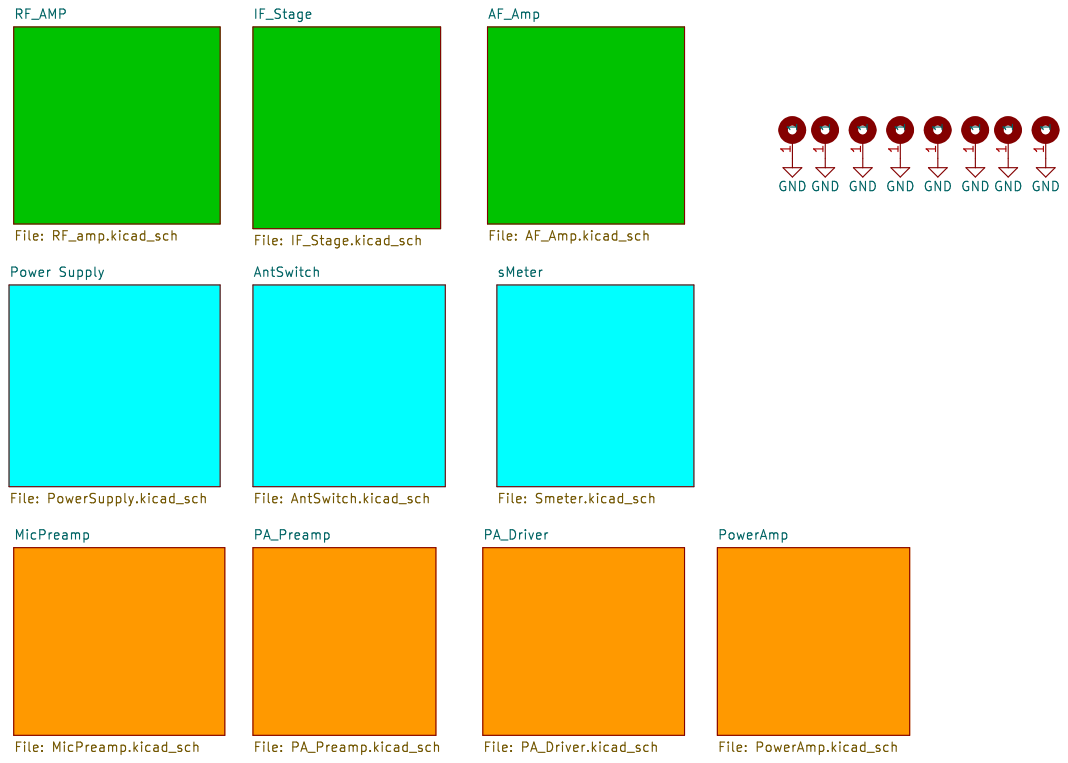
[picture p50: page 1]

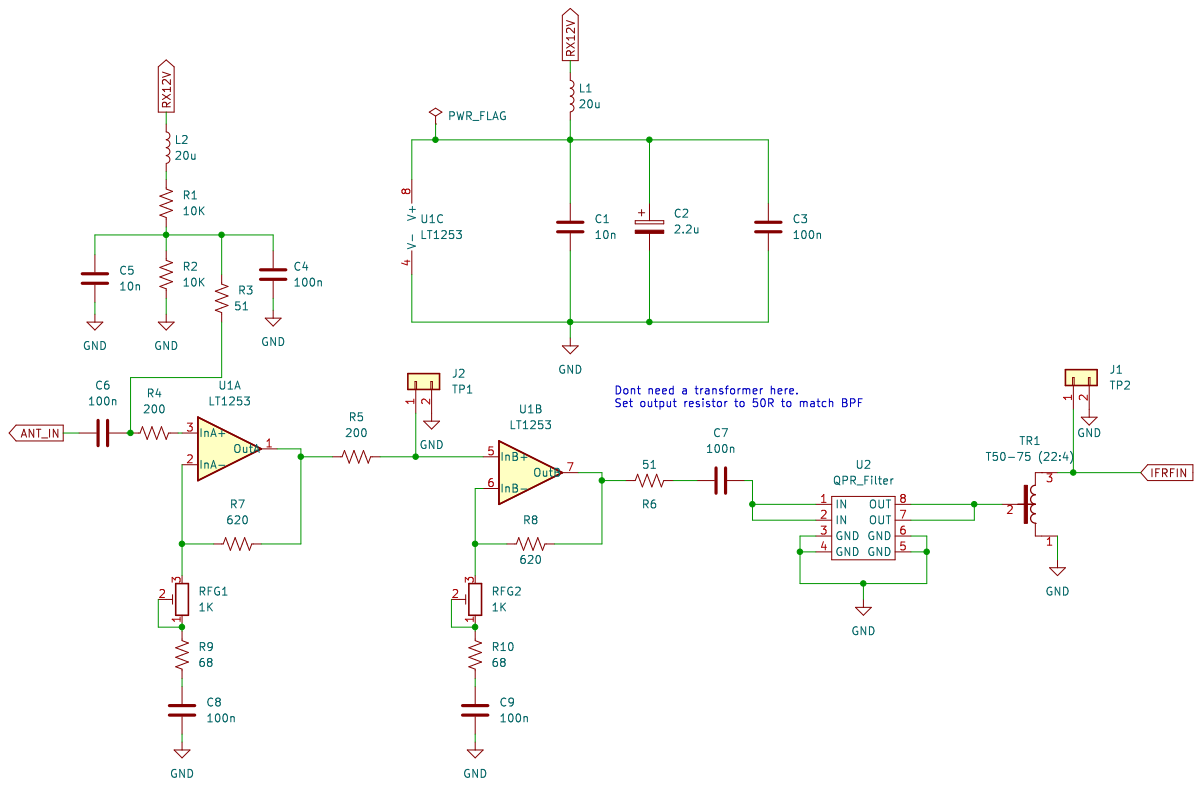
[picture p51: page 2]

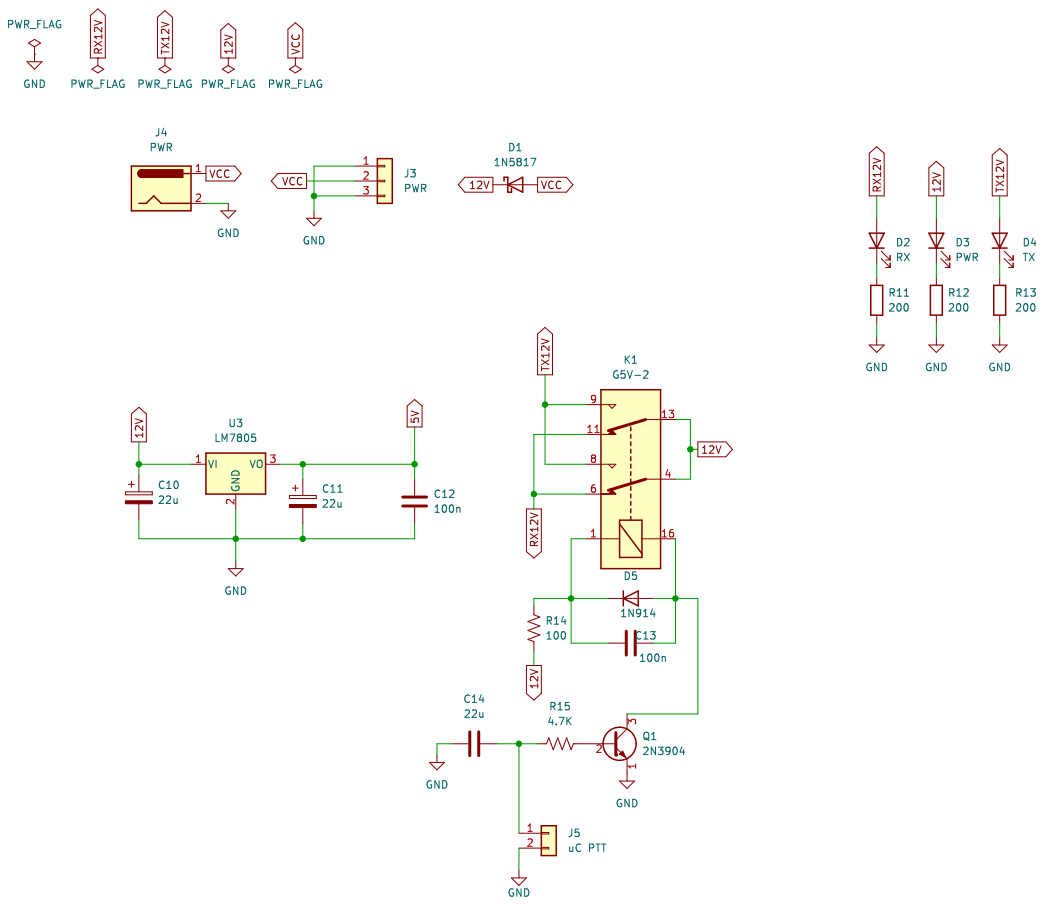
[picture p52: page 3]

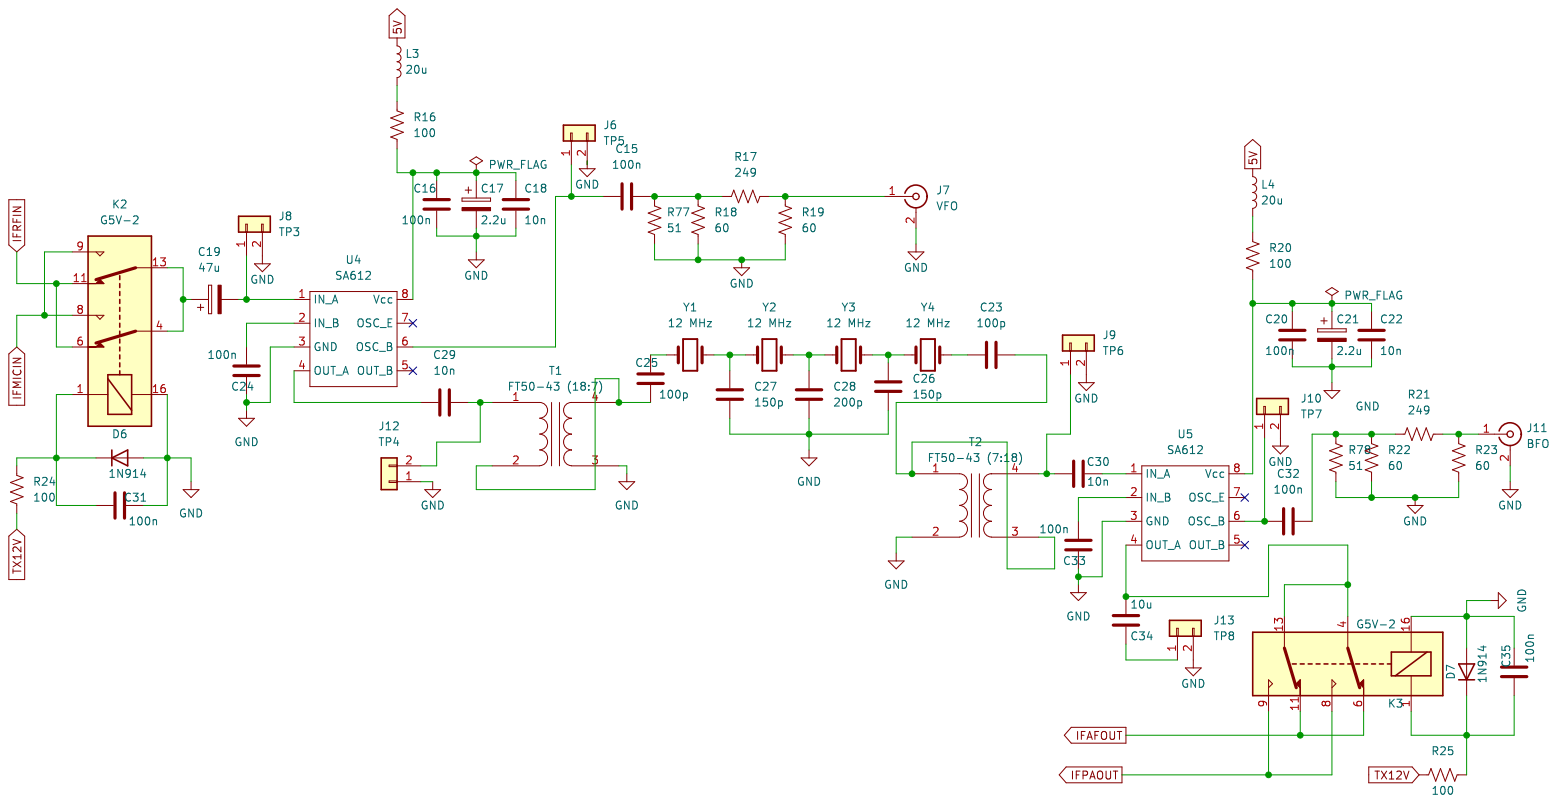
[picture p53: page 4]

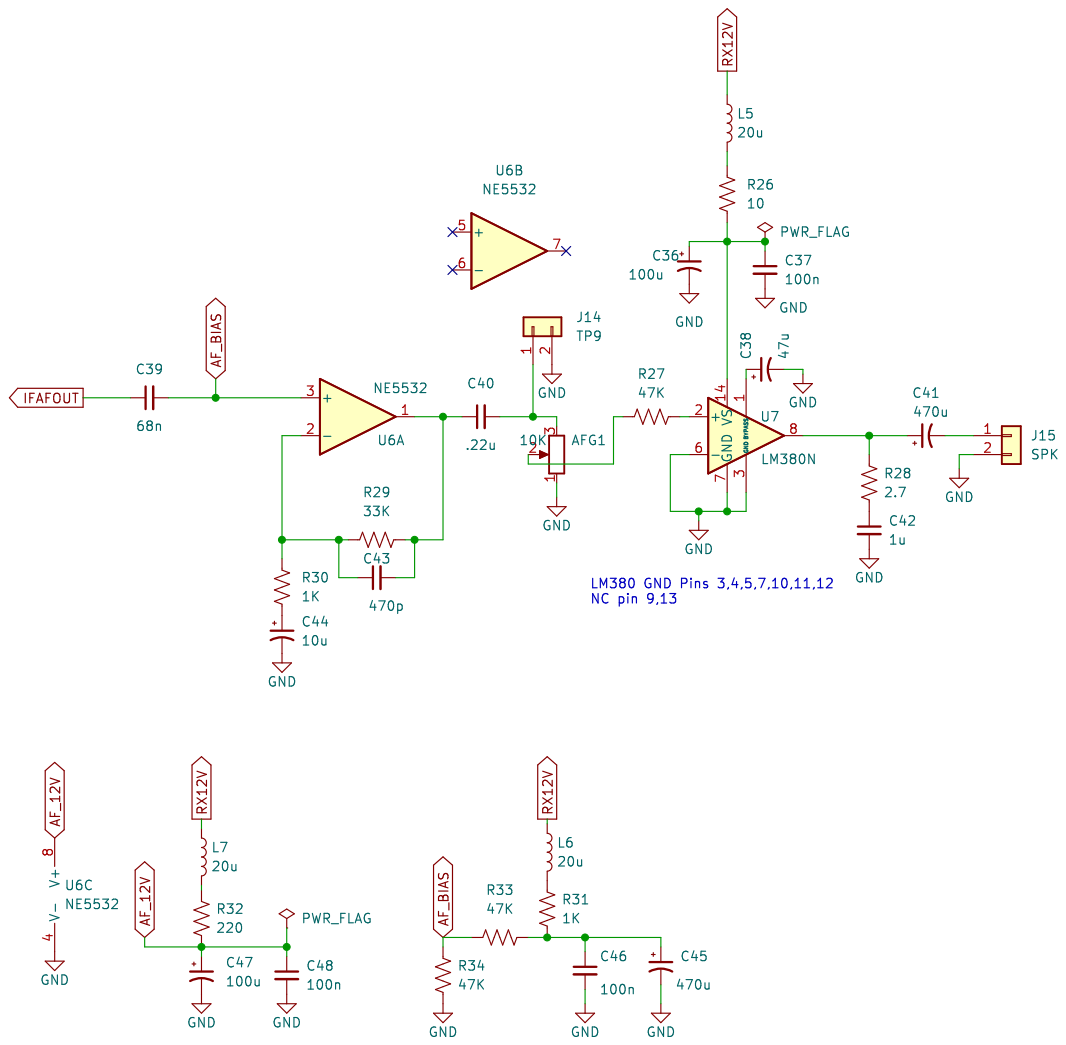
[picture p54: page 5]

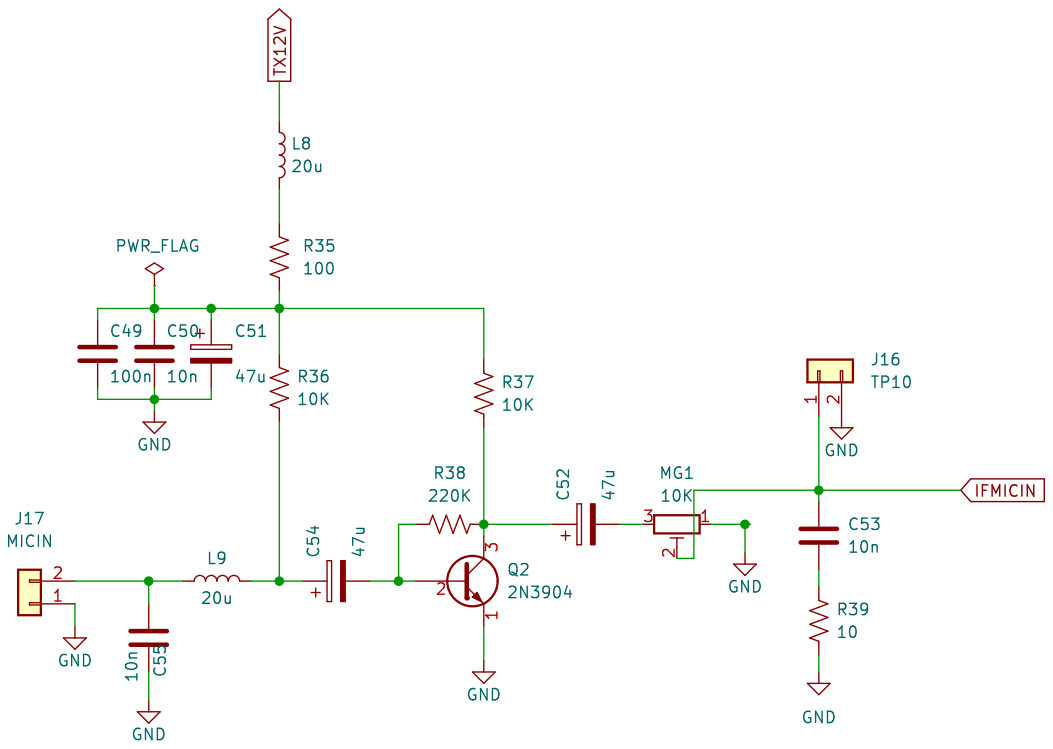
[picture p55: page 6]

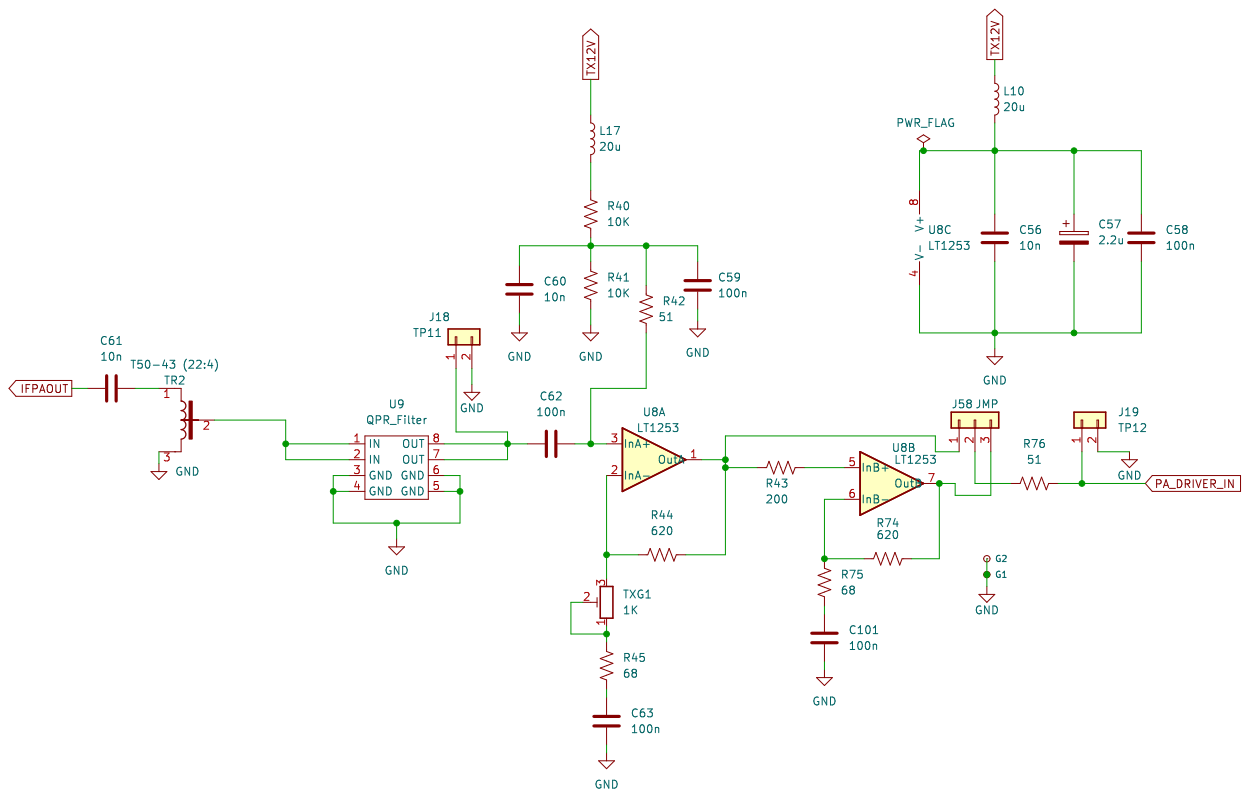
[picture p56: page 7]

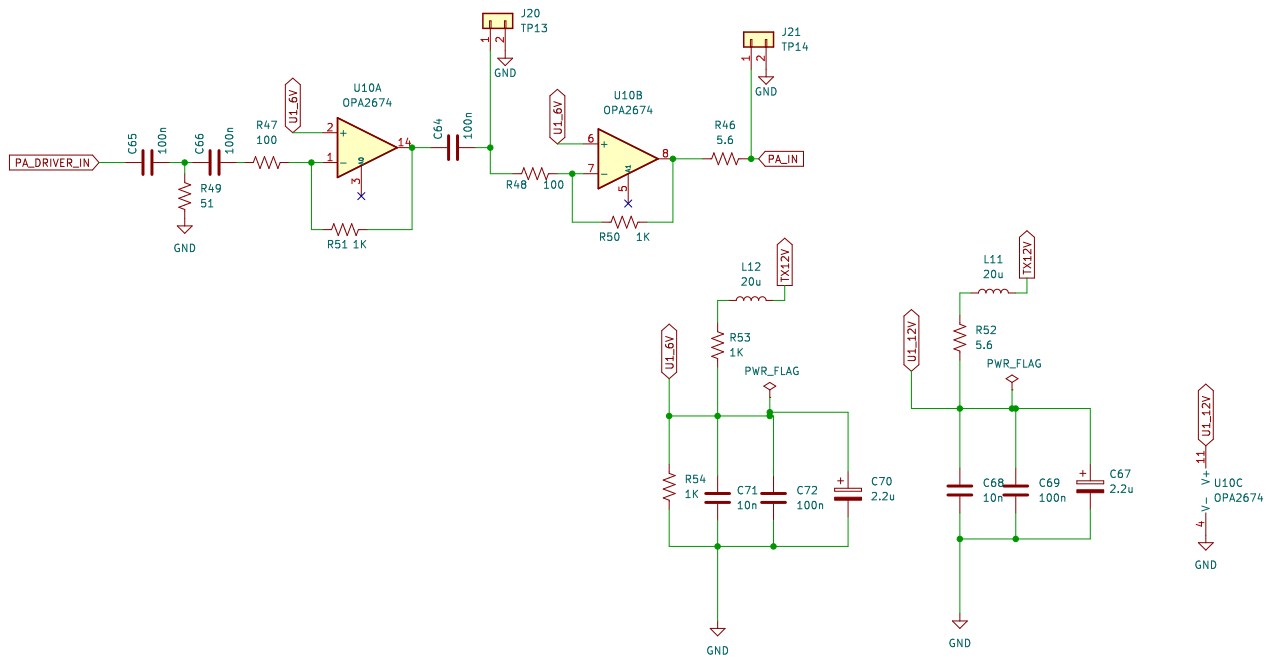
[picture p57: page 8]

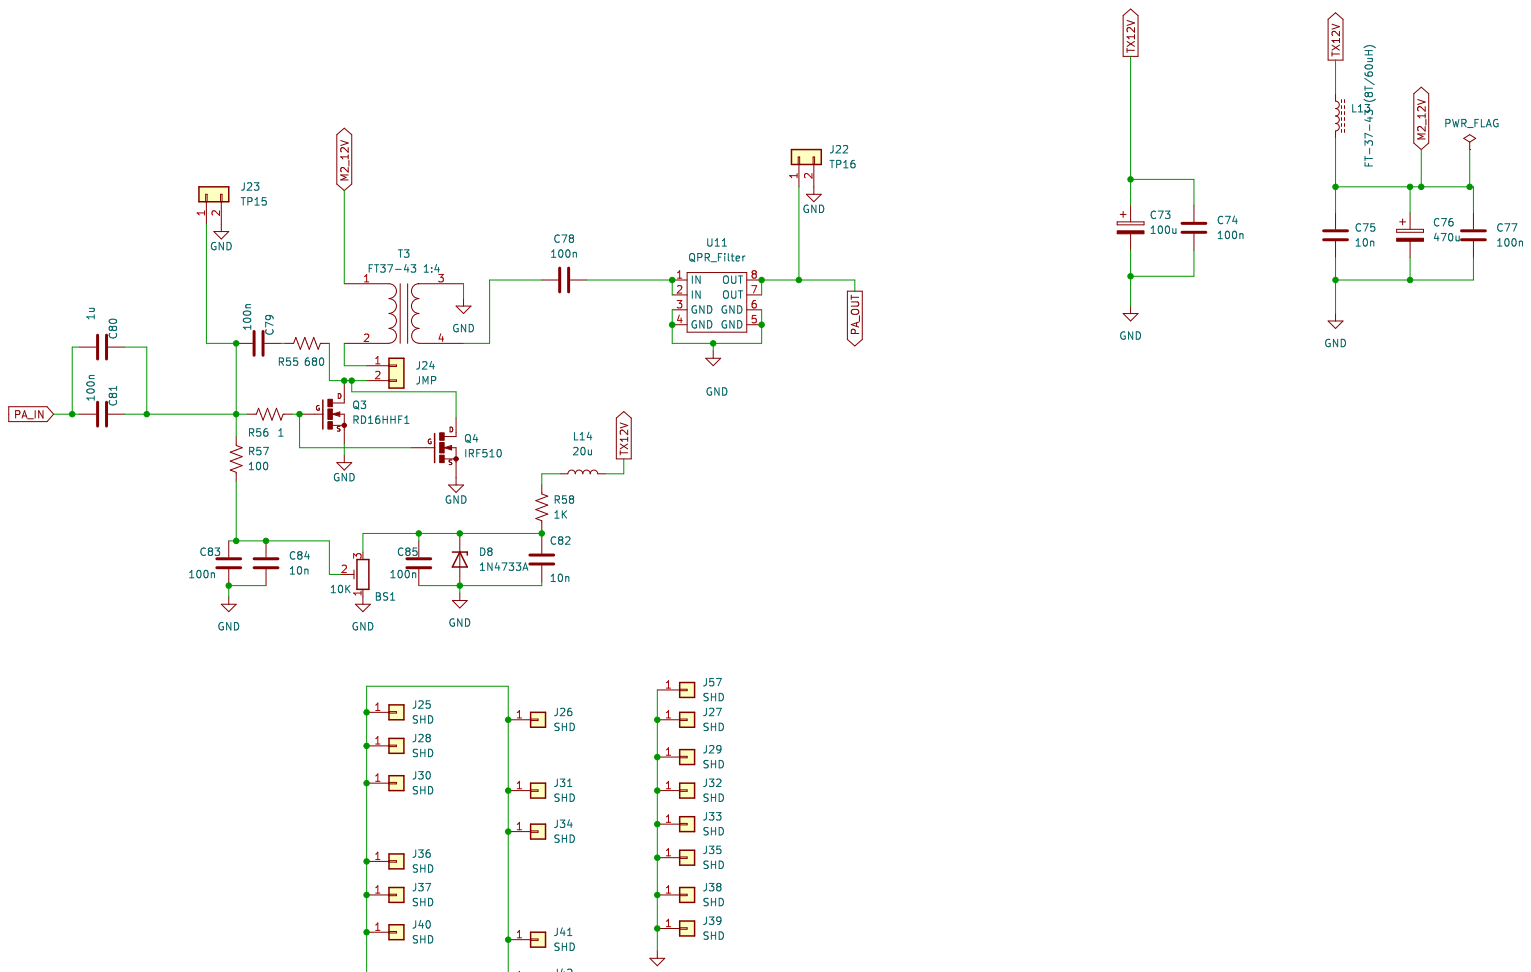
[picture p58: page 9]

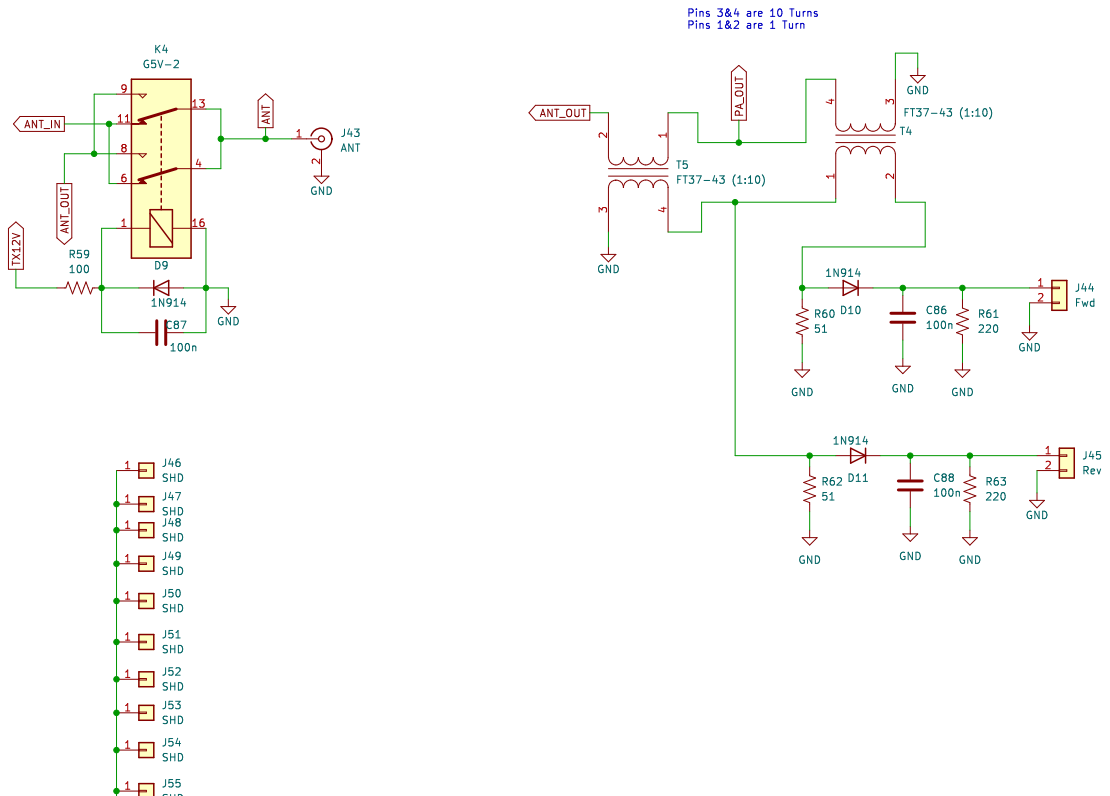
[picture p59: page 10]

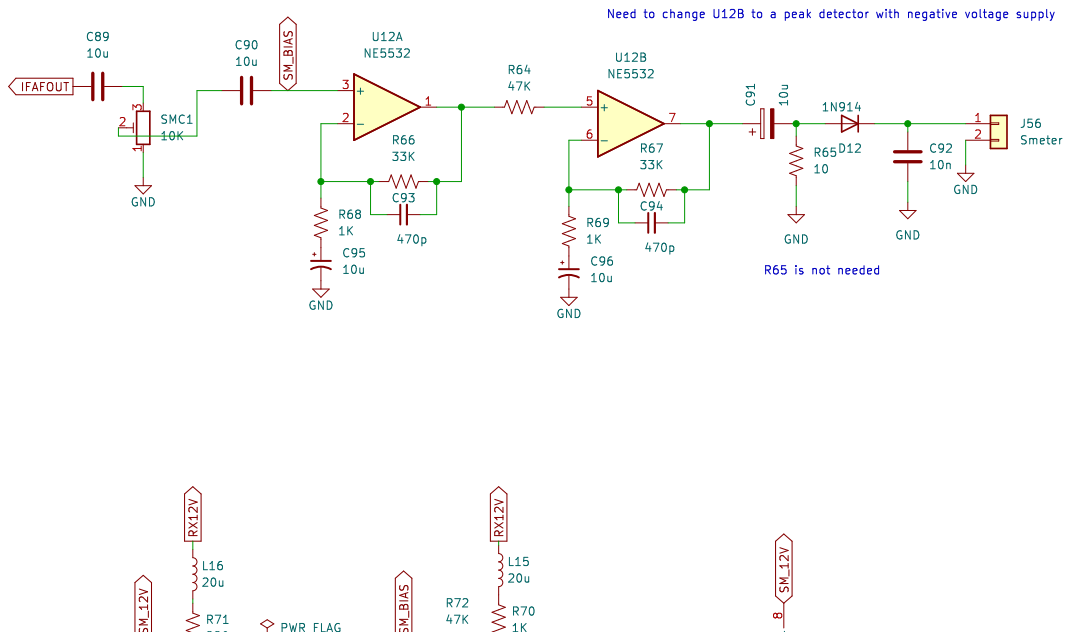
[picture p60: page 11]
