drajnauth/Phoenix612/Analysis/Simulations/Cobra-200_gtl_schema.pdf

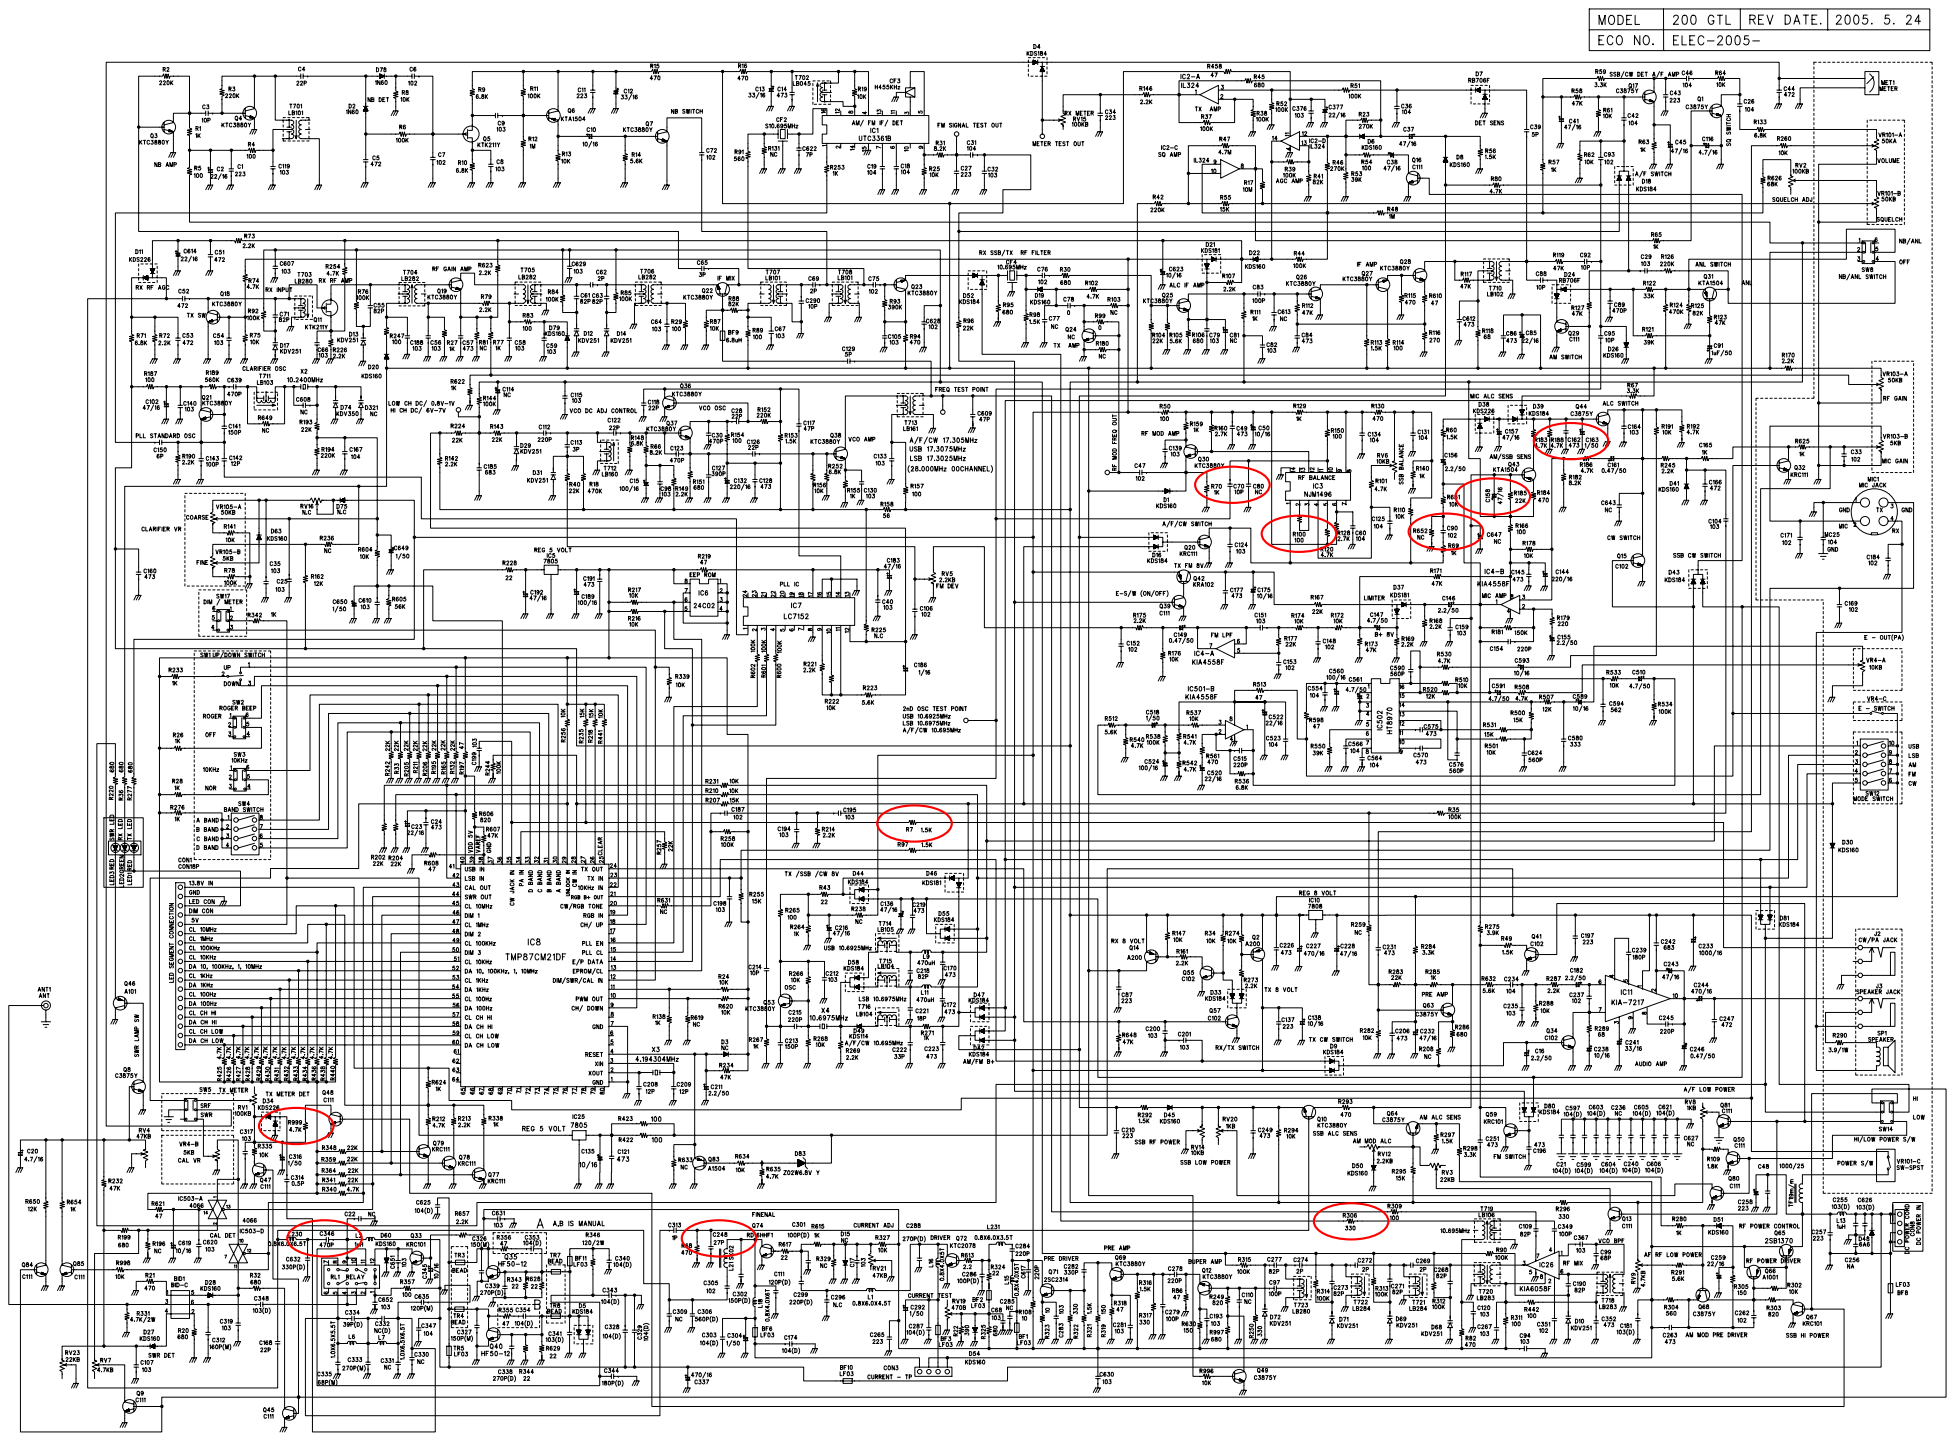
[picture p61: page 1]
