drajnauth/Phoenix612/Analysis/Simulations/Transistor Biasing/2N2219 + BS170 x2 Pre Amp Testing.asc

C1: cap; .1µ
C2: cap; .1µ
C3: cap; .1µ
C4: cap; .1µ
C5: cap; .1µ
C6: cap; .1µ
C7: cap; 100µ
C8: cap; .1µ
C9: cap; .1µ
C10: cap; .1µ
C11: cap; .1µ
C12: cap; .1µ
C13: cap; .1µ
C14: cap; .1µ
C15: cap; .1µ
C16: cap; .1µ
C17: cap; .1µ
M1: nmos; BS170
M2: nmos; BS170
Q1: npn; 2N2219A
R1: res; 4K
R2: res; 5813
R3: res; 4K
R4: res; 800
R5: res; 1215
R6: res; 35
R7: res; 3
R8: res; 800
RFC1: ind2; 10µ
RFC2: ind2; 10µ
RFC3: ind2; 66µ
RFC4: ind2; 66µ
RFC5: ind2; 66µ
Rin: res; {Z}
Rout: res; 100
Rsense1: res; .0001
Rsense2: res; .0001
V1: voltage; {BM2}
V2: voltage; 12
V5: voltage; SINE(0 {S} {F}); AC 1
Named nets: 0, Vout, Vin, Vg1, Vd1, Vbias2, Vg2, Vd2, Vs2, Vb, Ve, Vc, Vs1
.options plotwinsize=0
.options numdgt = 8
 
.meas TRAN Vinr RMS V(Vin)
.meas TRAN Voutr RMS V(Vout)
.meas TRAN Iinr RMS I(Rin)
.meas TRAN Ioutr RMS I(Rout)
;;;;;;;;;;;;;;;;;;;;;;;;;;;
.meas TRAN Vgr1 RMS V(Vg1)
.meas TRAN Vdr1 RMS V(Vd1)
.meas TRAN Idr1 RMS Ix(M1:D)
.meas TRAN Igr1 RMS Ix(M1:G)
.meas TRAN Vgavg1 AVG V(Vg1)
.meas TRAN Vgmax1 MAX V(Vg1)
.meas TRAN Vgmin1 MIN V(Vg1)
.meas TRAN Vbiasr1 RMS V(Vbias2)
.meas TRAN Vppr1 PARAM Vgmax1-Vgmin1
.meas TRAN Vpr1 PARAM Vgmax1-Vgs2
.meas TRAN Cd1 PARAM Vpr1/Vppr1
;;;;;;;;;;;;;;;;;;;;;;;;;;;
.meas TRAN Vgr2 RMS V(Vg2)
.meas TRAN Vdr2 RMS V(Vd2)
.meas TRAN Idr2 RMS Ix(M2:D)
.meas TRAN Igr2 RMS Ix(M2:G)
.meas TRAN Vgavg2 AVG V(Vg2)
.meas TRAN Vgmax2 MAX V(Vg2)
.meas TRAN Vgmin2 MIN V(Vg2)
.meas TRAN Vbiasr2 RMS V(Vbias2)
.meas TRAN Vppr2 PARAM Vgmax2-Vgmin2
.meas TRAN Vpr2 PARAM Vgmax2-Vgs2
.meas TRAN Cd2 PARAM Vpr2/Vppr2
;;;;;;;;;;;;;;;;;;;;;;;;;;;
.meas TRAN Vbr RMS V(Vb)
.meas TRAN Vcr RMS V(Vc)
.meas TRAN Ver RMS V(Ve)
.meas TRAN Ibr RMS Ib(Q1)
.meas TRAN Icr RMS Ic(Q1)
.meas TRAN Ier RMS Ie(Q1)
.meas TRAN Vbavg AVG V(Vb)
.meas TRAN Vbmax MAX V(Vb)
.meas TRAN Vbmin MIN V(Vb)
.meas TRAN Vppr PARAM Vbmax-Vbmin
.meas TRAN Vpr PARAM Vbmax-Vbe
.meas TRAN CdQ1 PARAM Vpr/Vppr
;;;;;;;;;;;;;;;;;;;;;;;;;;;
.meas TRAN Pdis1 AVG (V(vd1)*Ix(M1:D) + V(vg1)*Ix(M1:G))
.meas TRAN Pdis2 AVG (V(vd2)*Ix(M2:D) + V(vg2)*Ix(M2:G))
.meas TRAN Pdis3 AVG (V(Vc,Ve)*Ic(Q1) + V(Vb,Ve)*Ib(Q1))
;;;;;;;;;;;;;;;;;;;;;;;;;;;
.meas TRAN Isr2 RMS I(Rsense2)
.meas TRAN Vsr2 RMS V(Vs2)
.meas TRAN Isr1 RMS I(Rsense1)
.meas TRAN Vsr1 RMS V(Vs1)
.meas TRAN Zin PARAM Vinr/Iinr
.meas TRAN Zout PARAM Vdr2/Idr2
.meas TRAN ZinM1 PARAM Vsr1/Isr1
.meas TRAN ZinM2 PARAM Vsr2/Isr2
.meas TRAN ZoutQ1 PARAM Vcr/Icr
.meas TRAN ZoutM1 PARAM Vdr1/Idr1
.meas TRAN ZoutM2 PARAM Vdr2/Idr2
.meas TRAN CdAngleQ1 PARAM CdQ1*360
.meas TRAN CdAngleM1 PARAM Cd1*360
.meas TRAN CdAngleM2 PARAM Cd2*360
.meas TRAN Pin RMS (V(Vin)*I(Rin))
.meas TRAN Pout AVG (V(Vout)*I(Rout))
.meas TRAN Pdis PARAM Pdis2+Pdis1+Pdis3
.meas TRAN Pmar PARAM Pout-Pdis
 ;;;;;;;;;;;;;;;;;;;;;;;;;;;
.meas TRAN GQ1 PARAM (Vsr1/Vinr)
.meas TRAN GM1 PARAM (Vsr2/Vsr1)
.meas TRAN GM2 PARAM (Voutr/Vsr2)
.meas TRAN Gpr PARAM (Pout/Pin)
.meas TRAN Gvr PARAM (Voutr/Vinr)
.meas TRAN Gp PARAM 10*log10(Gpr)
.meas TRAN Gv PARAM 20*log10(Gvr)
.meas TRAN Gi PARAM 20*log10(Ioutr/Iinr)
 
.four {F} 4 -1 V(Vout)
;.step param F list 1.5Meg 3.7Meg 5.37Meg 7.1Meg 10.1Meg 14.1Meg 21.1Meg 28.7Meg
.step param F list  3.7Meg 14.1Meg 28.7Meg
;.param F 28.7Meg
.param S .009
.param BM2 2.8
;.step param BM2 2.2 4 .2
;.step param R 50 500 50
.param Z 1
.param Vgs1 3.6
.param Vgs2 2.1
.param Vbe 0.65
.include bs170.lib
Need 4.5Vp Output at 100R
.tran 0 20u 18u
