drajnauth/Phoenix612/Analysis/Simulations/Transistor Biasing/2N2219 Bias Testing.asc

C1: cap; 100µ
C2: cap; .1µ
C3: cap; .1µ
C4: cap; 1µ
C5: cap; .1µ
C6: cap; .1µ
C8: cap; 1µ
C12: cap; .1µ
I1: current; {Ibias}
L1: ind2; {L}
L2: ind2; 35µ
L3: ind2; 60µ
Q1: npn; 2N2219A
R1: res; {Rb1}
R2: res; {Rb2}
R3: res; {Re}
R4: res; 1K
R5: res; {Rec}
Rcouple1: res; .001
Rout: res; 50
V1: voltage; SINE(0 {S} {F}); AC 1; Rser={Z}
V2: voltage; 12
Named nets: 0, Vout, Vb, Ve, Vin, Vc, Vcc, Vcc1
.tran 0 10u 9.5u
.options plotwinsize=0
.options numdgt = 8
 
;;;;;;;;;;;;;;;;;;;;;;;;;;;;
.meas TRAN Vccr RMS V(Vcc)
.meas TRAN Vccr1 RMS V(Vcc1)
.meas TRAN Vinr RMS V(Vin)
.meas TRAN Vbr RMS V(Vb)
.meas TRAN Vcr RMS V(Vc)
.meas TRAN Ver RMS V(Ve)
.meas TRAN Voutr RMS V(Vout)
.meas TRAN Iinr RMS I(V1)
.meas TRAN Ibr RMS Ib(Q1)
.meas TRAN Icr RMS Ic(Q1)
.meas TRAN Ier RMS Ie(Q1)
.meas TRAN Ioutr RMS I(Rout)
.meas TRAN Pout AVG (V(Vout)*I(Rout))
.meas TRAN PL1 AVG (V(Vcc1,Vc)*I(L1))
.meas TRAN PL2 AVG (V(Vout)*I(L2))
.meas TRAN Pdis AVG (V(Vc,Ve)*Ic(Q1) + V(Vb,Ve)*Ib(Q1))
.meas TRAN ZL1 PARAM VL1/IL1
.meas TRAN ZL2 PARAM Voutr/Ioutr
.meas TRAN Ze PARAM Ver/Ier
.meas TRAN Re PARAM .026/Icr
.meas TRAN Beta PARAM Icr/Ibr
.meas TRAN Gv PARAM (Voutr/Vinr)
.meas TRAN Gb PARAM (ZL1/Ze)
.meas TRAN IL1 RMS(I(L1))
.meas TRAN IL2 RMS(I(L2))
.meas TRAN VL1 RMS (V(Vcc1,Vc))
.meas TRAN R1 PARAM IL1/IL2
.meas TRAN R2 PARAM VL1/Voutr
;;;;;;;;;;;;;;;;;;;;;;;;;;;
.meas TRAN Zin PARAM Vinr/Iinr
.meas TRAN Zout PARAM Vcr/Icr
;;;;;;;;;;;;;;;;;;;;;;;;;;;
.meas TRAN Pmar PARAM Pout-Pdis
.meas TRAN Iina AVG (I(V1)*I(V1))
.meas TRAN Pin PARAM Iina*Zin
.meas TRAN Vg PARAM 20*log10(Voutr/Vinr)
.meas TRAN Pg PARAM 10*log10(Pout/Pin)
 ;;;;;;;;;;;;;;;;;;;;;;;;;;;
 
 
 
.four {F} 4 -1 V(Vout)
;.step param F list 1.5Meg 3.7Meg 5.37Meg 7.1Meg 10.1Meg 14.1Meg 21.1Meg 28.7Meg
;.step param F list 3.7Meg 14.1Meg 28.7Meg
.param F 30Meg
.param S=0.159
.param Z 50
;.step param Rec 0.5 3.5 0.5
;.step param Re 1 11 2
;.step param Rb 500 4500 667
;.step param L 55u 65u 1u
;.step param Ibias 100u 1000u 100u
.param Ibias 400u
.param Rec 2
.param L 58u
.param Re 22
.param Rb1 2400
.param Rb2 680
.param Vbe 0.68
K1 L1 L2 1
.ac dec 1000 1Meg 30Meg
Rb1 was 4000, Rb2 888
Original settings Re 3.5, Rec 1, L 11u, Rb1 1040, Rb2 177, Vb 1.97, Ibias 284u, Ic 55m
Icmax 800mA, Pmax 3W (heatsink)
Need 677mVrms output,
