drajnauth/Phoenix612/Analysis/Simulations/Transistor Biasing/2N2219 CC 2N7000 RD16HHF Power Amp Testing.asc

C1: cap; .1µ
C2: cap; .1µ
C3: cap; .1µ
C4: cap; .1µ
C5: cap; .1µ
C6: cap; .1µ
C7: cap; .1µ
C8: cap; .1µ
C9: cap; 220µ
C10: cap; .1µ
C11: cap; .1µ
C12: cap; 470µ
C13: cap; .1µ
C14: cap; .1µ
C15: cap; .1µ
C16: cap; .1µ
C17: cap; .1µ
C18: cap; 100n
C19: cap; 100n
C20: cap; 100n
C21: cap; 100n
C22: cap; 100n
C23: cap; 100n
C24: cap; 100n
C25: cap; 100n
C26: cap; 100n
C27: cap; 100n
C28: cap; 10p
C29: cap; .1µ
C30: cap; .1µ
C31: cap; 370p
C36: cap; 470µ
L1: ind2; 10µ
L2: ind2; 10µ
L3: ind2; 12.5µ
L4: ind2; 50µ
M1: nmos; BS170
M2: nmos; RD16HHF1
Q1: npn; 2N2219A
R1: res; 56
R2: res; 10K
R3: res; 4.7K
R4: res; 50
R5: res; 1K
R6: res; 1K
R7: res; {R}
R8: res; 620
R9: res; 620
R10: res; 68
R11: res; 68
R12: res; 620
R13: res; 620
R14: res; 68
R15: res; 68
R16: res; {R}
R17: res; {R}
R18: res; {R}
R19: res; {R}
R20: res; 240
Rb1: res; 2389
Rb2: res; 1049
Re1: res; 50
RFC1: ind2; 10µ
RFC2: ind2; 10µ
RFC3: ind2; 1m
RFC4: ind2; 10µ
Rout: res; 50
RSense1: res; .001
RSense2: res; .001
RSense3: res; 113
U1: LT1253
U2: LT1253
U3: LT1253
U4: LT1253
V1: voltage; SINE(0 {S} {F}); AC 1; Rser={Z}
V2: voltage; 12
V3: voltage; {BM2}
V4: voltage; {BM1}
Named nets: 0, Vout, Vin, Vg1, Vd1, Vbias1, Vg2, Vd2, Vs1, Vbias2, Vs2, Vb, Ve, Vc, Vu1, Vs3, Vt1, Vt2, Vt3, Vt5, Vt4, Vu3
.tran 10u
.options plotwinsize=0
.options numdgt = 8
 
.meas TRAN Vinr RMS V(Vin)
.meas TRAN Iinr RMS I(V1)
.meas TRAN Voutr RMS V(Vout)
.meas TRAN Ioutr RMS I(Rout)
;;;;;;;;;;;;;;;;;;;;;;;;;;;
.meas TRAN Vbr RMS V(Vb)
.meas TRAN Vcr RMS V(Vc)
.meas TRAN Ver RMS V(Ve)
.meas TRAN Ibr RMS Ib(Q1)
.meas TRAN Icr RMS Ic(Q1)
.meas TRAN Ier RMS Ie(Q1)
.meas TRAN Vbavg AVG V(Vb)
.meas TRAN Vbmax MAX V(Vb)
.meas TRAN Vbmin MIN V(Vb)
.meas TRAN Vppr3 PARAM Vbmax-Vbmin
.meas TRAN Vpr3 PARAM Vbmax-Vbe
.meas TRAN CdQ1 PARAM Vpr3/Vppr3
;;;;;;;;;;;;;;;;;;;;;;;;;;;
.meas TRAN Vgr1 RMS V(Vg1)
.meas TRAN Vdr1 RMS V(Vd1)
.meas TRAN Idr1 RMS Ix(M1:D)
.meas TRAN Igr1 RMS Ix(M1:G)
.meas TRAN Vgavg1 AVG V(Vg1)
.meas TRAN Vgmax1 MAX V(Vg1)
.meas TRAN Vgmin1 MIN V(Vg1)
.meas TRAN Vbiasr1 RMS V(Vbias1)
.meas TRAN Vppr1 PARAM Vgmax1-Vgmin1
.meas TRAN Vpr1 PARAM Vgmax1-Vgs1
.meas TRAN CdM1 PARAM Vpr1/Vppr1
;;;;;;;;;;;;;;;;;;;;;;;;;;;
.meas TRAN Vgr2 RMS V(Vg2)
.meas TRAN Vdr2 RMS V(Vd2)
.meas TRAN Idr2 RMS Id(M2)
.meas TRAN Igr2 RMS Ig(M2)
.meas TRAN Vgavg2 AVG V(Vg2)
.meas TRAN Vgmax2 MAX V(Vg2)
.meas TRAN Vgmin2 MIN V(Vg2)
.meas TRAN Vbiasr2 RMS V(Vbias2)
.meas TRAN Vppr2 PARAM Vgmax2-Vgmin2
.meas TRAN Vpr2 PARAM Vgmax2-Vgs2
.meas TRAN CdM2 PARAM Vpr2/Vppr2
;;;;;;;;;;;;;;;;;;;;;;;;;;;
.meas TRAN PdisM1 AVG (V(vd1)*Ix(M1:D) + V(vg1)*Ix(M1:G))
.meas TRAN PdisM2 AVG (V(vd2)*Id(m2) + V(vg2)*Ig(m2))
.meas TRAN PdisQ1 AVG (V(Vc,Ve)*Ic(Q1) + V(Vb,Ve)*Ib(Q1))
;;;;;;;;;;;;;;;;;;;;;;;;;;;
.meas TRAN Vsr1 RMS V(Vs1)
.meas TRAN Is1 RMS I(Rsense1)
.meas TRAN Vsr2 RMS V(Vs2)
.meas TRAN Is2 RMS I(Rsense2)
.meas TRAN Vsr3 RMS V(Vs3)
.meas TRAN Is3 RMS I(Rsense3)
.meas TRAN Zin PARAM Vinr/Iinr
.meas TRAN ZinM2 PARAM Vsr1/Is1
.meas TRAN ZinM1 PARAM Vsr2/Is2
.meas TRAN ZinQ1 PARAM Vsr3/Is3
.meas TRAN ZoutM2 PARAM Vdr1/Idr1
.meas TRAN ZoutM1 PARAM Vdr2/Idr2
.meas TRAN CdAngleM1 PARAM CdM1*360
.meas TRAN CdAngleM2 PARAM CdM2*360
.meas TRAN CdAngleQ1 PARAM CdQ1*360
.meas TRAN Pin PARAM Zin*Iinr*Iinr
.meas TRAN Pout AVG (V(Vout)*I(Rout))
.meas TRAN Pdis PARAM PdisM1+PdisM2+PdisQ1
.meas TRAN Pmar PARAM Pout-Pdis
 ;;;;;;;;;;;;;;;;;;;;;;;;;;;
.meas TRAN Glt PARAM Vsr3/Vinr
.meas TRAN GQ1 PARAM Vsr2/Vsr3
.meas TRAN GM1 PARAM Vdr1/Vsr2
.meas TRAN GM2 PARAM Vdr2/Vsr1
 
.meas TRAN Gp PARAM 10*log10(Pout/Pin)
.meas TRAN Gv PARAM 20*log10(Voutr/Vinr)
.meas TRAN Gi PARAM 20*log10(Ioutr/Iinr)
.meas TRAN BetaQ1 PARAM Icr/Ibr
 
.four {F} 4 -1 V(Vt1)
.four {F} 4 -1 V(Vt2)
.four {F} 4 -1 V(Vt3)
.four {F} 4 -1 V(Vt4)
.four {F} 4 -1 V(Vt5)
.four {F} 4 -1 V(Vs3)
.four {F} 4 -1 V(Vout)
;.step param F list 1.5Meg 3.7Meg 5.37Meg 7.1Meg 10.1Meg 14.1Meg 21.1Meg 28.7Meg
;.step param F list  3.7Meg 14.1Meg 28.7Meg
.param F 30Meg
.param S 1
.param BM2 4.5
.param BM1 3.0
.param R 9K
.param Z 100
.param Vgs2 3.6
.param Vgs1 2.1
.param Vbe 0.7
K1 L1 L2 1
K2 L3 L4 1
Need 4.4Vp Input for 9W output at 100R
.include BS170.lib
1K pot +68R  
Up to 20dB of gain here.
Need 0.7Vp Input at 443 R at 30 MHz
Need 0.7Vp Input at 50R
