drajnauth/Phoenix612/Analysis/Simulations/Transistor Biasing/2N2219 CC Amp Testing.asc

C1: cap; 100µ
C2: cap; .1µ
C3: cap; .1µ
C4: cap; .1µ
C6: cap; .1µ
Q1: npn; 2N2219A
R3: res; 100
R10: res; 10R
Rb1: res; 4788
Rb2: res; 2099
RFC1: ind2; 10µ
Rload: res; 100
Vcc: voltage; 12
Vi: voltage; SINE(0 {S} {F}); Rser={Z}
Named nets: 0, Vin, Vb1, Vc1, Ve1, Vout
.options plotwinsize=0
.options numdgt = 8
 
 
 
.meas TRAN Vinr RMS V(Vin)
.meas TRAN Voutr RMS V(Vout)
.meas TRAN Ioutr RMS I(Rload)
.meas TRAN Iinr RMS I(Vi)
;;;;;;;;;;;;;;;;;;;;;;;;;;;;
.meas TRAN Vb1r RMS V(Vb1)
.meas TRAN Vc1r RMS V(Vc1)
.meas TRAN Ve1r RMS V(Ve1)
.meas TRAN Ic1r RMS Ic(Q1)
.meas TRAN Ib1r RMS Ib(Q1)
.meas TRAN Ie1r RMS Ie(Q1)
.meas TRAN Vb1avg AVG V(Vb1)
.meas TRAN Vb1max MAX V(Vb1)
.meas TRAN Vb1min MIN V(Vb1)
.meas TRAN Vpp1r PARAM Vb1max-Vb1min
.meas TRAN Vp1r PARAM Vb1max-Vbe
.meas TRAN Cd1 PARAM Vp1r/Vpp1r
;;;;;;;;;;;;;;;;;;;;;;;;;;;;
.meas TRAN PQ1dis AVG (V(Vc1,Ve1)*Ic(Q1) + V(Vb1,Ve1)*Ib(Q1))
;;;;;;;;;;;;;;;;;;;;;;;;;;;
.meas TRAN Zin PARAM Vinr/Iinr
.meas TRAN Zout PARAM Voutr/Ioutr 
.meas TRAN ZQ1in PARAM Vb1r/Ib1r 
.meas TRAN ZQ1out PARAM Ve1r/Ie1r
;;;;;;;;;;;;;;;;;;;;;;;;;;;
.meas TRAN Q1Angle PARAM Cd1*360
;;;;;;;;;;;;;;;;;;;;;;;;;;;
.meas TRAN Pin PARAM Zin*Iinr*Iinr
.meas TRAN Pout AVG (V(Vout)*I(Rload))
.meas TRAN Pmar PARAM Pout-PQ1dis
 ;;;;;;;;;;;;;;;;;;;;;;;;;;;
.meas TRAN Gpr PARAM (Pout/Pin)
.meas TRAN Gvr PARAM (Voutr/Vinr)
.meas TRAN Gir PARAM (Ioutr/Iinr)
.meas TRAN Gp PARAM 10*log10(Gpr)
.meas TRAN Gv PARAM 20*log10(Gvr)
.meas TRAN Gi PARAM 20*log10(Gir)
.meas TRAN Beta PARAM Ic1r/Ib1r
 
.four {F} 4 -1 V(Vout)
.tran 0 10u
;.step param F list 1.5Meg 3.7Meg 5.37Meg 7.1Meg 10.1Meg 14.1Meg 21.1Meg 28.7Meg
;.step param F list 3.7Meg 14.1Meg 28.7Meg
.param F 28.7Meg
.param S 1
.param Z 1
.param Vbe 0.68
.ac dec 100 1Meg 40Meg
