drajnauth/Phoenix612/Analysis/Simulations/Transistor Biasing/2N2219 Darlington testing.asc

C1: cap; .1µ
C2: cap; .1µ
C3: cap; .1µ
C7: cap; .1µ
L1: ind; 100µ
L2: ind2; 50µ
L3: ind2; 50µ
Q1: npn; 2N2219A
Q2: npn; 2N2219A
R1: res; 3K
R2: res; 3K
R3: res; 4
R4: res; 100
Rout: res; 50
V1: voltage; SINE(0 {S} {F}); Rser={Z}
V2: voltage; 12
Named nets: 0, Vout, Vb1, Ve1, Vin, Vc1, Ve2
.tran 0 10u 4u
.options plotwinsize=0
.options numdgt = 8
 
 
.meas TRAN Vinr RMS V(Vin)
.meas TRAN Voutr RMS V(Vout)
.meas TRAN Iinr RMS I(V1)
.meas TRAN Ioutr RMS I(Rout)
;;;;;;;;;;;;;;;;;;;;;;;;;;;
.meas TRAN Zin PARAM Vinr/Iinr
.meas TRAN Pin AVG (Zin*I(V1)*I(V1))
.meas TRAN Pout AVG (V(Vout)*I(Rout))
 ;;;;;;;;;;;;;;;;;;;;;;;;;;;
.meas TRAN Gp PARAM 10*log10(Pout/Pin)
.meas TRAN G PARAM Voutr/Vinr
.meas TRAN Gv PARAM 20*log10(Voutr/Vinr)
.meas TRAN Gi PARAM 20*log10(Iinr/Ioutr)
 
.four {F} 4 -1 V(Vout)
;.step param F list 1.5Meg 3.7Meg 5.37Meg 7.1Meg 10.1Meg 14.1Meg 21.1Meg 28.7Meg
.step param F list 3.7Meg 14.1Meg 28.7Meg
;.param F 28.7Meg
;.step param S .01 .11 0.01
;.step param L 1u 11u 1u
;.step param R 5 100 5
;.param R 65 ; for 5V
.param R 35 ; for 12V
.param S .06
.param Z 50
.param Vbe 0.68
.ac dec 1000 1Meg 30Meg
K1 L2 L3 1
