drajnauth/Phoenix612/Analysis/Simulations/Transistor Biasing/2n2219 Input Characteristic Curve.asc

Q1: npn; 2N2219A
R1: res; .0001
R2: res; 0.001
R3: res; .0001
Vb: voltage; 0; AC 1
Vcc: voltage; 12
Named nets: 0, Vce, Ve, Vb
.dc Vb 0.5 1 .01
https://www.youtube.com/watch?v=7WWJ2kfJ3oc
.ac dec 100 1Meg 1Gig
