drajnauth/Phoenix612/Analysis/Simulations/Transistor Biasing/2n2219 Preamp testing.asc

C1: cap; 1µ
C2: cap; .1µ
C3: cap; .1µ
C4: cap; 1µ
C5: cap; .1µ
C6: cap; .1µ
C7: cap; .1µ
L3: ind; 60µ
Q1: npn; 2N2219A
R1: res; 5813
R2: res; 1215
R3: res; 6
R4: res; 35
R5: res; 200
Rin: res; {Z}
Rout: res; 20000
V1: voltage; SINE(0 {S} {F}); AC 1
V2: voltage; 12
Named nets: 0, Vout, Vb, Ve, Vin, Vc
.tran 0 10u 8u
.options plotwinsize=0
.options numdgt = 8
 
 
.meas TRAN Vinr RMS V(Vin)
 
.meas TRAN Voutr RMS V(Vout)
.meas TRAN Ioutr RMS I(Rout)
.meas TRAN Iinr RMS I(Rin)
;;;;;;;;;;;;;;;;;;;;;;;;;;;;
.meas TRAN Vbr RMS V(Vb)
.meas TRAN Vbavg AVG V(Vb)
.meas TRAN Vbmax MAX V(Vb)
.meas TRAN Vbmin MIN V(Vb)
.meas TRAN Vppr PARAM Vbmax-Vbmin
.meas TRAN Vpr PARAM Vbmax-Vbe
.meas TRAN Cd PARAM Vpr/Vppr
;;;;;;;;;;;;;;;;;;;;;;;;;;;
.meas TRAN Pdis AVG (V(Vc,Ve)*Ic(Q1) + V(Vb,Ve)*Ib(Q1))
;;;;;;;;;;;;;;;;;;;;;;;;;;;
.meas TRAN Zin PARAM Vinr/Iinr
.meas TRAN CdAngle PARAM Cd*360
.meas TRAN Pin PARAM Zin*Iinr*Iinr
 
.meas TRAN Pout AVG (V(Vout)*I(Rout))
.meas TRAN Pmar PARAM Pout-Pdis
 ;;;;;;;;;;;;;;;;;;;;;;;;;;;
.meas TRAN Gpr PARAM (Pout/Pin)
.meas TRAN Gvr PARAM (Voutr/Vinr)
.meas TRAN Gp PARAM 10*log10(Pout/Pin)
.meas TRAN Gv PARAM 20*log10(Voutr/Vinr)
 
.four {F} 4 -1 V(Vout)
;.step param F list 1.5Meg 3.7Meg 5.37Meg 7.1Meg 10.1Meg 14.1Meg 21.1Meg 28.7Meg
.param F 30Meg
.param S 0.01
.param Z 1
.param Vbe 0.65
.ac dec 1000 1Meg 30Meg
