drajnauth/Phoenix612/Analysis/Simulations/Transistor Biasing/2n2219 testing.asc

C1: cap; 100µ
C2: cap; 100µ
C3: cap; .1µ
C4: cap; .1µ
C7: cap; 100µ
L3: ind; 10µ
Q1: npn; 2SC5706
R1: res; .5
Rb1: res; 1308
Rb2: res; 273
Rc: res; 15
Re: res; 3
Rout: res; 15
V1: voltage; SINE(0 {S} {F}); AC 1; Rser={Z}
V3: voltage; 12
Named nets: 0, Vout, Vb, Ve, Vin, Vc
.tran 0 20u
.options plotwinsize=0
.options numdgt = 8
 
 
.meas TRAN Vinr RMS V(Vin)
.meas TRAN Voutr RMS V(Vout)
.meas TRAN Iinr RMS I(V1)
;;;;;;;;;;;;;;;;;;;;;;;;;;;;
.meas TRAN Vbr RMS V(Vb)
.meas TRAN Vcr RMS V(Vc)
.meas TRAN Ver RMS V(Ve)
.meas TRAN Ibr RMS Ib(Q1)
.meas TRAN Icr RMS Ic(Q1)
.meas TRAN Ier RMS Ie(Q1)
.meas TRAN Vbavg AVG V(Vb)
.meas TRAN Vbmax MAX V(Vb)
.meas TRAN Vbmin MIN V(Vb)
.meas TRAN Vppr PARAM Vbmax-Vbmin
.meas TRAN Vpr PARAM Vbmax-Vbe
.meas TRAN Cd PARAM Vpr/Vppr
;;;;;;;;;;;;;;;;;;;;;;;;;;;
.meas TRAN Pdis AVG (V(Vc,Ve)*Ic(Q1) + V(Vb,Ve)*Ib(Q1))
 
;;;;;;;;;;;;;;;;;;;;;;;;;;;
.meas TRAN Zin PARAM Vinr/Iinr
.meas TRAN Zout PARAM Vcr/Icr
.meas TRAN CdAngle PARAM Cd*360
.meas TRAN Pin AVG (Zin*I(V1)*I(V1))
.meas TRAN Re PARAM .026/Icr
 
.meas TRAN Pout AVG (V(Vout)*I(Rout))
.meas TRAN Pmar PARAM Pout-Pdis
 ;;;;;;;;;;;;;;;;;;;;;;;;;;;
.meas TRAN Gpr PARAM (Pout/Pin)
.meas TRAN Gvr PARAM (Voutr/Vinr)
.meas TRAN Gp PARAM 10*log10(Gpr)
.meas TRAN Gv PARAM 20*log10(Gvr)
.meas TRAN Beta PARAM (Icr/Ibr)
 
.four {F} 4 -1 V(Vout)
;.step param F list 1.5Meg 3.7Meg 5.37Meg 7.1Meg 10.1Meg 14.1Meg 21.1Meg 28.7Meg
.step param F list 3.7Meg  7.1Meg 14.1Meg  28.7Meg
;.step param F list 0.01Meg 0.1Meg 0.5Meg 1Meg 2Meg 3Meg
;.param F 30Meg
.param S 0.0015
;.step param R 10 100 10
.param Z 1
.param Vbe 0.65
.ac dec 1000 1Meg 30Meg
Rb1 687, Rb2 74, Re 2, Rc 50, 
S 0.45, G 18, Zin 16, Zout 28
.op
