drajnauth/Phoenix612/Analysis/Simulations/Transistor Biasing/2N2222 2N2219 RD16HHF1 Testing.asc

C1: cap; .1µ
C2: cap; .1µ
C3: cap; .1µ
C4: cap; 1µ
C5: cap; .1µ
C6: cap; .1µ
C8: cap; 1µ
C9: cap; .1µ
C10: cap; .1µ
C11: cap; 4n
C12: cap; .1µ
C13: cap; .1µ
C15: cap; .1µ
C16: cap; .1µ
C17: cap; .1µ
C19: cap; .1µ
C20: cap; .1µ
L1: ind2; 88µ
L2: ind2; 11µ
L3: ind2; 22µ
L4: ind2; 88µ
L5: ind2; 11µ
L6: ind; 2.2µ
L7: ind; 1n
L8: ind2; 66µ
M1: nmos; RD16HHF1
Q1: npn; 2N2222A
Q2: npn; 2N2219A
R1: res; 15
R2: res; 10K
R3: res; 56
R4: res; 560
R5: res; 17.4K
R6: res; 3.4K
R7: res; 165
R8: res; 2
Rb1: res; 1.3K
Rb2: res; 326
Re: res; 20
RFC1: ind2; 10µ
RFC2: ind; 10µ
RFC3: ind2; 10µ
RFC4: ind2; 10µ
Rout: res; 50
Rsense1: res; 0.001
Rsense2: res; 0.001
V1: voltage; SINE(0 {S} {F}); AC 1; Rser={Z}
V2: voltage; 12
V3: voltage; {B}
Named nets: 0, Vout, Vb2, Ve2, Vin, Vc2, Vcc, Vg1, Vd1, Vbias, Vs2, Vb1, Ve1, Vc1, Vs1
.tran 0 20u
.options plotwinsize=0
.options numdgt = 8
 
 
.meas TRAN Vinr RMS V(Vin)
.meas TRAN Voutr RMS V(Vout)
.meas TRAN Iinr RMS I(V1)
.meas TRAN Ioutr RMS I(Rout)
;;;;;;;;;;;;;;;;;;;;;;;;;;;;
.meas TRAN Vbr1 RMS V(Vb1)
.meas TRAN Vcr1 RMS V(Vc1)
.meas TRAN Ibr1 RMS Ib(Q1)
.meas TRAN Icr1 RMS Ic(Q1)
.meas TRAN Vbavg1 AVG V(Vb1)
.meas TRAN Vbmax1 MAX V(Vb1)
.meas TRAN Vbmin1 MIN V(Vb1)
.meas TRAN Vppr1 PARAM Vbmax1-Vbmin1
.meas TRAN Vpr1 PARAM Vbmax1-Vbe
.meas TRAN CdQ1 PARAM Vpr1/Vppr1
;;;;;;;;;;;;;;;;;;;;;;;;;;;;
.meas TRAN Vbr2 RMS V(Vb2)
.meas TRAN Vcr2 RMS V(Vc2)
.meas TRAN Ibr2 RMS Ib(Q2)
.meas TRAN Icr2 RMS Ic(Q2)
.meas TRAN Vbavg2 AVG V(Vb2)
.meas TRAN Vbmax2 MAX V(Vb2)
.meas TRAN Vbmin2 MIN V(Vb2)
.meas TRAN Vppr2 PARAM Vbmax2-Vbmin2
.meas TRAN Vpr2 PARAM Vbmax2-Vbe
.meas TRAN CdQ2 PARAM Vpr2/Vppr2
;;;;;;;;;;;;;;;;;;;;;;;;;;;;
.meas TRAN Vgr1 RMS V(Vg1)
.meas TRAN Vdr1 RMS V(Vd1)
.meas TRAN Idr1 RMS Id(M1)
.meas TRAN Igr1 RMS Ig(m1)
.meas TRAN Vgavg1 AVG V(Vg1)
.meas TRAN Vgmax1 MAX V(Vg1)
.meas TRAN Vgmin1 MIN V(Vg1)
.meas TRAN Vbiasr RMS V(Vbias)
.meas TRAN Vgppr1 PARAM Vgmax1-Vgmin1
.meas TRAN Vgpr1 PARAM Vgmax1-Vgs
.meas TRAN CdM1 PARAM Vgpr1/Vgppr1
;;;;;;;;;;;;;;;;;;;;;;;;;;;
.meas TRAN PdisQ1 AVG (V(Vc1,Ve1)*Ic(Q1) + V(Vb1,Ve1)*Ib(Q1))
.meas TRAN PdisQ2 AVG (V(Vc2,Ve2)*Ic(Q2) + V(Vb2,Ve2)*Ib(Q2))
.meas TRAN PdisM1 AVG (V(vd1)*Id(m1) + V(vg1)*Ig(m1))
.meas TRAN Pdis PARAM PdisQ1+PdisM1
;;;;;;;;;;;;;;;;;;;;;;;;;;;
.meas TRAN Vsr1 RMS V(Vs1)
.meas TRAN Isr1 RMS I(Rsense1)
.meas TRAN Vsr2 RMS V(Vs2)
.meas TRAN Isr2 RMS I(Rsense2)
.meas TRAN Zin PARAM Vinr/Iinr
.meas TRAN ZinQ2 PARAM Vsr2/Isr2 
.meas TRAN ZinM1 PARAM Vsr1/Isr1 
.meas TRAN ZoutQ1 PARAM Vcr1/Icr1
.meas TRAN ZoutQ2 PARAM Vcr2/Icr2
.meas TRAN ZoutM1 PARAM Vdr1/Idr1
.meas TRAN CdQ1Angle PARAM CdQ1*360
.meas TRAN CdQ2Angle PARAM CdQ2*360
.meas TRAN Cd1MAngle PARAM CdM1*360
.meas TRAN Pin AVG (Zin*I(V1)*I(V1))
.meas TRAN Pout AVG (V(Vout)*I(Rout))
.meas TRAN Pmar PARAM Pout-Pdis
 ;;;;;;;;;;;;;;;;;;;;;;;;;;;
.meas TRAN Gp PARAM 10*log10(Pout/Pin)
.meas TRAN G PARAM Voutr/Vinr
.meas TRAN Gv PARAM 20*log10(Voutr/Vinr)
.meas TRAN Gi PARAM 20*log10(Iinr/Ioutr)
.meas TRAN BetaQ1 PARAM Icr1/Ibr1
.meas TRAN BetaQ2 PARAM Icr2/Ibr2
 
.four {F} 4 -1 V(Vout)
;.step param F list 1.5Meg 3.7Meg 5.37Meg 7.1Meg 10.1Meg 14.1Meg 21.1Meg 28.7Meg
.step param F list 3.7Meg 14.1Meg 28.7Meg
;.param F 30Meg
;.step param S .01 0.2 0.04
;.step param L 11u 110u 11u
;.step param R 200 425 25
.param S .018
.param B 5.7
.param Z 1
.param Vbe 0.68
.param Vgs 3.6
.ac dec 1000 1Meg 30Meg
K1 L1 L2 1
K2 L3 L4 1
K3 L5 L8 1
