drajnauth/Phoenix612/Analysis/Simulations/Transistor Biasing/2N2222 Beta Measurement Testing.asc

Q1: npn; 2N2222
Rb: res; .001
Rc: res; .001
Re: res; .001
Vb: voltage; 0
Vcc: voltage; 0
Named nets: 0, Vc, Vb, Ve, Vcc
.dc Vcc 0 12 .5 Vb .5 5 .02
https://www.youtube.com/watch?v=7WWJ2kfJ3oc
.meas Vccr MAX V(Vcc)
.meas Vbr  MAX V(Vb)
.meas Ibr  MAX I(Vb)
.meas Icr  MAX Ic(Q1)
.meas Vcr  MAX V(Vc)
.meas Ver  MAX V(Ve)
.meas Vcer PARAM Vcr-Ver
.meas Beta PARAM Icr/Ibr
