drajnauth/Phoenix612/Analysis/Simulations/Transistor Biasing/2N2222A Input Characteristic Curve.asc

Q1: npn; 2N2222
Rc: res; .0001
Re: res; .0001
Vb: voltage; 0
Vcc: voltage; 12
Named nets: 0, Vc
.dc Vb .6 5
https://www.youtube.com/watch?v=7WWJ2kfJ3oc
