drajnauth/Phoenix612/Analysis/Simulations/Transistor Biasing/2N3866 W1FB testing.asc

C1: cap; .1µ
C2: cap; .1µ
C3: cap; 12p
C4: cap; .1µ
C5: cap; .1µ
C6: cap; 12p
C7: cap; .1µ
C9: cap; 47µ
C13: cap; 1µ
L1: ind2; 35µ
L2: ind2; 35µ
L3: ind2; 50µ
L4: ind2; 20µ
Q1: npn; 2N3866
R1: res; 560
R2: res; 1K
R3: res; 4.7
R4: res; 39
R5: res; 3.3K
R6: res; 10
Rin: res; {Z}
Rout: res; 50R
V1: voltage; SINE(0 {S} {F}); AC 1
V2: voltage; 12
Named nets: 0, Vout, Vb, Ve, Vin, Vc
.tran 0 20u
.options plotwinsize=0
.options numdgt = 8
 
 
.meas TRAN Vinr RMS V(Vin)
.meas TRAN Voutr RMS V(Vout)
.meas TRAN Iinr RMS I(V1)
.meas TRAN Ioutr RMS I(Rout)
;;;;;;;;;;;;;;;;;;;;;;;;;;;;
.meas TRAN Vbr RMS V(Vb)
.meas TRAN Vcr RMS V(Vc)
.meas TRAN Ver RMS V(Ve)
.meas TRAN Ibr RMS Ib(Q1)
.meas TRAN Icr RMS Ic(Q1)
.meas TRAN Ier RMS Ie(Q1)
.meas TRAN Vbavg AVG V(Vb)
.meas TRAN Vbmax MAX V(Vb)
.meas TRAN Vbmin MIN V(Vb)
.meas TRAN Vppr PARAM Vbmax-Vbmin
.meas TRAN Vpr PARAM Vbmax-Vbe
.meas TRAN Cd PARAM Vpr/Vppr
;;;;;;;;;;;;;;;;;;;;;;;;;;;
.meas TRAN Pdis AVG (V(Vc,Ve)*Ic(Q1) + V(Vb,Ve)*Ib(Q1))
 
;;;;;;;;;;;;;;;;;;;;;;;;;;;
.meas TRAN Zin PARAM Vinr/Iinr
.meas TRAN Zout PARAM Vcr/Icr
.meas TRAN CdAngle PARAM Cd*360
.meas TRAN Pin PARAM Iinr*Vinr
.meas TRAN Re PARAM .026/Icr
 
.meas TRAN Pout AVG (V(Vout)*I(Rout))
.meas TRAN Pmar PARAM Pout-Pdis
 ;;;;;;;;;;;;;;;;;;;;;;;;;;;
.meas TRAN Gvr PARAM (Voutr/Vinr)
.meas TRAN Gir PARAM (Ioutr/Iinr)
.meas TRAN Gpr PARAM (Pout/Pin)
.meas TRAN Gv PARAM 20*log10(Gvr)
.meas TRAN Gi PARAM 20*log10(Gir)
.meas TRAN Gp PARAM 10*log10(Gpr)
.meas TRAN BetaAC PARAM (Icr/Ibr)
 
.four {F} 4 -1 V(Vout)
;.step param F list 1.5Meg 3.7Meg 5.37Meg 7.1Meg 10.1Meg 14.1Meg 21.1Meg 28.7Meg
.step param F list 3.7Meg 7.1Meg 14.1Meg 28.7Meg
;.param F 28.7Meg
.param S 0.001
.param Z 19
.param Vbe 0.65
.ac dec 1000 1Meg 30Meg
K1 L1 L2 1
K2 L3 L4 1
