drajnauth/Phoenix612/Analysis/Simulations/Transistor Biasing/2N3866 x2 EMRFD BS170 RD16HHF1 Testing.asc

C1: cap; .1µ
C2: cap; .1µ
C3: cap; 12p
C4: cap; .1µ
C5: cap; .1µ
C6: cap; 12p
C7: cap; .1µ
C8: cap; .1µ
C9: cap; 47µ
C10: cap; .1µ
C11: cap; 12p
C12: cap; 12p
C13: cap; 1µ
C14: cap; .1µ
C15: cap; .1µ
C16: cap; .1µ
C17: cap; .1µ
C18: cap; .1µ
C19: cap; .1µ
C20: cap; .1µ
C22: cap; .1µ
C23: cap; .1µ
C24: cap; .1µ
C25: cap; .1µ
C26: cap; .1µ
C28: cap; 220µ
C29: cap; 470µ
C30: cap; .1µ
C31: cap; 470µ
L1: ind2; 35µ
L2: ind2; 35µ
L3: ind2; 35µ
L4: ind2; 35µ
L5: ind2; 70µ
L6: ind2; 30µ
L7: ind2; 12.5µ
L8: ind2; 50µ
M1: nmos; BS170
M2: nmos; RD16HHF1
Q1: npn; 2N3866
Q2: npn; 2N3866
R1: res; 1.3K
R2: res; 1K
R3: res; 6
R4: res; 68
R5: res; 3K
R6: res; 1.3K
R7: res; 1K
R8: res; 68
R9: res; 6
R10: res; 3K
R11: res; 1800
R12: res; 1800
R13: res; 3
R14: res; 4.7K
R15: res; 10K
R16: res; 56
R17: res; 1800
R18: res; 1800
R19: res; 3
RFC1: ind; 10µ
RFC2: ind; 10µ
RFC3: ind2; 10µ
RFC4: ind2; 1m
RFC5: ind2; 10µ
RFC6: ind2; 10µ
Rout: res; 50R
Rzs2: res; 0.001
Rzs3: res; .001
Rzs4: res; .001
V1: voltage; SINE(0 {S} {F}); AC 1; Rser={Z}
V2: voltage; 12
V4: voltage; {BM1}
V5: voltage; {BM2}
Named nets: 0, Vout, Vb1, Ve1, Vin, Vc1, Vb2, Ve2, Vc2, Vzs2, Vg1, Vd1, Vbias1, Vg2, Vd2, Vzs4, Vbias2, Vzs3
.tran 0 20u
.options plotwinsize=0
.options numdgt = 8
 
 
.meas TRAN Vinr RMS V(Vin)
.meas TRAN Voutr RMS V(Vout)
.meas TRAN Iinr RMS I(V1)
.meas TRAN Ioutr RMS I(Rout)
;;;;;;;;;;;;;;;;;;;;;;;;;;;;
.meas TRAN Vbr1 RMS V(Vb1)
.meas TRAN Vcr1 RMS V(Vc1)
.meas TRAN Ver1 RMS V(Ve1)
.meas TRAN Ibr1 RMS Ib(Q1)
.meas TRAN Icr1 RMS Ic(Q1)
.meas TRAN Ier1 RMS Ie(Q1)
.meas TRAN Vbavg1 AVG V(Vb1)
.meas TRAN Vbmax1 MAX V(Vb1)
.meas TRAN Vbmin1 MIN V(Vb1)
.meas TRAN Vppr1 PARAM Vbmax1-Vbmin1
.meas TRAN Vpr1 PARAM Vbmax1-Vbe
.meas TRAN CdQ1 PARAM Vpr1/Vppr1
;;;;;;;;;;;;;;;;;;;;;;;;;;;;
.meas TRAN Vbr2 RMS V(Vb2)
.meas TRAN Vcr2 RMS V(Vc2)
.meas TRAN Ver2 RMS V(Ve2)
.meas TRAN Ibr2 RMS Ib(Q2)
.meas TRAN Icr2 RMS Ic(Q2)
.meas TRAN Ier2 RMS Ie(Q2)
.meas TRAN Vbavg2 AVG V(Vb2)
.meas TRAN Vbmax2 MAX V(Vb2)
.meas TRAN Vbmin2 MIN V(Vb2)
.meas TRAN Vppr2 PARAM Vbmax2-Vbmin2
.meas TRAN Vpr2 PARAM Vbmax2-Vbe
.meas TRAN CdQ2 PARAM Vpr2/Vppr2
;;;;;;;;;;;;;;;;;;;;;;;;;;;
.meas TRAN Vgr1 RMS V(Vg1)
.meas TRAN Vdr1 RMS V(Vd1)
.meas TRAN Idr1 RMS Ix(M1:D)
.meas TRAN Igr1 RMS Ix(M1:G)
.meas TRAN Vgavg3 AVG V(Vg1)
.meas TRAN Vgmax3 MAX V(Vg1)
.meas TRAN Vgmin3 MIN V(Vg1)
.meas TRAN Vbiasr3 RMS V(Vbias1)
.meas TRAN Vppr3 PARAM Vgmax3-Vgmin3
.meas TRAN Vpr3 PARAM Vgmax3-Vgs1
.meas TRAN CdM1 PARAM Vpr3/Vppr3
;;;;;;;;;;;;;;;;;;;;;;;;;;;
.meas TRAN Vgr2 RMS V(Vg2)
.meas TRAN Vdr2 RMS V(Vd2)
.meas TRAN Idr2 RMS Id(M2)
.meas TRAN Igr2 RMS Ig(M2)
.meas TRAN Vgavg4 AVG V(Vg2)
.meas TRAN Vgmax4 MAX V(Vg2)
.meas TRAN Vgmin4 MIN V(Vg2)
.meas TRAN Vbiasr4 RMS V(Vbias2)
.meas TRAN Vppr4 PARAM Vgmax4-Vgmin4
.meas TRAN Vpr4 PARAM Vgmax4-Vgs2
.meas TRAN CdM2 PARAM Vpr4/Vppr4
;;;;;;;;;;;;;;;;;;;;;;;;;;;
.meas TRAN PdisQ1 AVG (V(Vc1,Ve1)*Ic(Q1) + V(Vb1,Ve1)*Ib(Q1))
.meas TRAN PdisQ2 AVG (V(Vc2,Ve2)*Ic(Q2) + V(Vb2,Ve2)*Ib(Q2))
.meas TRAN PdisM1 AVG (V(vd1)*Ix(M1:D) + V(vg1)*Ix(M1:G))
.meas TRAN PdisM2 AVG (V(vd2)*Id(m2) + V(vg2)*Ig(m2))
;;;;;;;;;;;;;;;;;;;;;;;;;;;
.meas TRAN Vzsr2 RMS V(Vzs2)
.meas TRAN Izsr2 RMS I(Rzs2)
.meas TRAN Vzsr3 RMS V(Vzs3)
.meas TRAN Izsr3 RMS I(Rzs3)
.meas TRAN Vzsr4 RMS V(Vzs4)
.meas TRAN Izsr4 RMS I(Rzs4)
.meas TRAN Zin PARAM Vinr/Iinr
.meas TRAN ZinQ2 PARAM Vzsr2/Izsr2
.meas TRAN ZinM1 PARAM Vzsr3/Izsr3
.meas TRAN ZinM2 PARAM Vzsr4/Izsr4
.meas TRAN ZoutQ1 PARAM Vcr1/Icr1
.meas TRAN ZoutQ2 PARAM Vcr2/Icr2
.meas TRAN ZoutM1 PARAM Vdr1/Idr1
.meas TRAN ZoutM2 PARAM Vdr2/Idr2
.meas TRAN CdAngleQ1 PARAM CdQ1*360
.meas TRAN CdAngleQ2 PARAM CdQ2*360
.meas TRAN CdAngleM1 PARAM CdM1*360
.meas TRAN CdAngleM2 PARAM CdM2*360
.meas TRAN Pin PARAM Iinr*Vinr
 ;;;;;;;;;;;;;;;
.meas TRAN Pout AVG (V(Vout)*I(Rout))
.meas TRAN Pdis PdisQ1+PdisQ2
.meas TRAN Pmar PARAM Pout-Pdis
 ;;;;;;;;;;;;;;;;;;;;;;;;;;;
.meas TRAN GQ1 PARAM (Vzsr2/Vinr)
.meas TRAN GQ2 PARAM (Vzsr3/Vzsr2)
.meas TRAN GM1 PARAM (Vzsr4/Vzsr3)
.meas TRAN GM2 PARAM (Voutr/Vzsr4)
.meas TRAN Gvr PARAM (Voutr/Vinr)
.meas TRAN Gir PARAM (Ioutr/Iinr)
.meas TRAN Gpr PARAM (Pout/Pin)
.meas TRAN Gv PARAM 20*log10(Gvr)
.meas TRAN Gi PARAM 20*log10(Gir)
.meas TRAN Gp PARAM 10*log10(Gpr)
;;;;;;;;;;;;;;;;;;;;;;;;;;;;
.meas TRAN ReQ1 PARAM .026/Icr1
.meas TRAN ReQ2 PARAM .026/Icr2
.meas TRAN BetaQ1AC PARAM (Icr1/Ibr1)
.meas TRAN BetaQ2AC PARAM (Icr2/Ibr2)
 
.four {F} 4 -1 V(Vzs2)
.four {F} 4 -1 V(Vzs3)
.four {F} 4 -1 V(Vzs4)
.four {F} 4 -1 V(Vout)
;.step param F list 1.5Meg 3.7Meg 5.37Meg 7.1Meg 10.1Meg 14.1Meg 21.1Meg 28.7Meg
;.step param F list 3.7Meg 7.1Meg 14.1Meg 28.7Meg
.param F 28.7Meg
.param S 0.012
.param BM2 4.5
.param BM1 3.0
;.step param S 0.05 0.1 0.01
.param Z 50
.param Vbe 0.65
.param Vgs2 3.6
.param Vgs1 2.1
.ac dec 1000 1Meg 30Meg
K1 L1 L2 1
K2 L3 L4 1
K3 L5 L6 1
K4 L7 L8 1
Need about 100R at Drain
.include BS170.lib
