drajnauth/Phoenix612/Analysis/Simulations/Transistor Biasing/2N3904 Bias testing.asc

C1: cap; .1µ
C2: cap; .1µ
C3: cap; .1µ
C4: cap; .1µ
C18: cap; .1µ
C24: cap; .1µ
C26: cap; .1µ
C28: cap; .1µ
L1: ind2; 35µ
L2: ind2; 35µ
L3: ind2; 35µ
L4: ind2; 35µ
Q1: npn; 2N2219A
Q4: npn; 2N2219A
R1: res; 100
R2: res; 10
R3: res; 1K
R4: res; 100
R5: res; 10
R6: res; 22R
R18: res; 470R
R28: res; 1K
R33: res; 10R
Rout: res; 50R
Rsense3: res; .001
Rsense4: res; .001
V1: voltage; SINE(0 {S} {F}); AC 1; Rser={Z}
V2: voltage; 12
Named nets: 0, Vout, Vin, Vb4, Vc4, Ve4, Vb1, Vc1, Ve1
;.step param F list 1.5Meg 3.7Meg 5.37Meg 7.1Meg 10.1Meg 14.1Meg 21.1Meg 28.7Meg
;.step param F list 3.7Meg 14.1Meg 28.7Meg
.param F 30Meg
.param S .003
.param B 0.7
.param Z 50
.param Vbe 0.68
K1 L3 L4 1
10 Bifilar FT37-43
.tran 10u
K2 L1 L2 1
