drajnauth/Phoenix612/Analysis/Simulations/Transistor Biasing/2N3904 Vin vs Ic testing.asc

C1: cap; 1µ
C2: cap; .1µ
C3: cap; .1µ
C4: cap; 1µ
C5: cap; .1µ
C6: cap; .1µ
C7: cap; .1µ
L1: ind2; 35µ
L2: ind2; 35µ
Q1: npn; 2N3904
R2: res; 94
R3: res; 1
R4: res; 3.3
R5: res; 665
Rout: res; 50R
V1: voltage; SINE(0 {S} {F}); AC 1; Rser={Z}
V2: voltage; 12
Named nets: 0, Vout, Vb, Ve, Vin, Vc, Vcc
.tran 0 10u 9.5u
.options plotwinsize=0
.options numdgt = 8
 
 
 
.meas TRAN Vinr RMS V(Vin)
.meas TRAN Voutr RMS V(Vout)
.meas TRAN Iinr RMS I(V1)
.meas TRAN Ioutr RMS I(Rout)
.meas TRAN Vccr RMS V(Vcc)
;;;;;;;;;;;;;;;;;;;;;;;;;;;;
.meas TRAN Vbr RMS V(Vb)
.meas TRAN Vcr RMS V(Vc)
.meas TRAN Ver RMS V(Ve)
.meas TRAN Ibr RMS Ib(Q1)
.meas TRAN Icr RMS Ic(Q1)
.meas TRAN Ier RMS Ie(Q1)
.meas TRAN Vbavg AVG V(Vb)
.meas TRAN Vbmax MAX V(Vb)
.meas TRAN Vbmin MIN V(Vb)
.meas TRAN Vppr PARAM Vbmax-Vbmin
.meas TRAN Vpr PARAM Vbmax-Vbe
.meas TRAN Cd PARAM Vpr/Vppr
;;;;;;;;;;;;;;;;;;;;;;;;;;;
.meas TRAN VL1 AVG V(Vcc,Vc)
.meas TRAN IL1 AVG I(L1)
.meas TRAN PQ1 AVG (V(Vc,Ve)*Ic(Q1) + V(Vb,Ve)*Ib(Q1))
.meas TRAN PRe AVG (V(Ve)*Ie(Q1))
.meas TRAN PL1 VL1*IL1
.meas TRAN Vce PARAM Vcr-Ver
.meas TRAN Vbe PARAM Vbr-Ver
.meas TRAN Vcb PARAM Vcr-Vbr
;;;;;;;;;;;;;;;;;;;;;;;;;;;
.meas TRAN Zin PARAM Vinr/Iinr
.meas TRAN ZQ1 PARAM Vcr/Icr
.meas TRAN CdAngle PARAM Cd*360
.meas TRAN Pin PARAM Vinr*Iinr
 .meas TRAN Pout AVG (V(Vout)*I(Rout))
.meas TRAN Pmar PARAM Pout-PQ1
 ;;;;;;;;;;;;;;;;;;;;;;;;;;;
.meas TRAN Gp PARAM 10*log10(Pout/Pin)
.meas TRAN Gv PARAM 20*log10(Voutr/Vinr)
.meas TRAN Beta PARAM Icr/Ibr
 
.four {F} 4 -1 V(Vout)
;.step param F list 1.5Meg 3.7Meg 5.37Meg 7.1Meg 10.1Meg 14.1Meg 21.1Meg 28.7Meg
.param F 30Meg
.param S 1 
;.step param S 0.25 3 0.25 
.param Z 18
.param Vbe 0.69
K1 L1 L2 1
.ac dec 1000 1Meg 30Meg
