drajnauth/Phoenix612/Analysis/Simulations/Transistor Biasing/2N7000 Darlington testing.asc

C1: cap; .1µ
C2: cap; .1µ
C3: cap; .1µ
C4: cap; 1µ
C5: cap; .1µ
C6: cap; .1µ
C7: cap; .1µ
C8: cap; 1µ
C9: cap; .1µ
L1: ind2; 60µ
L2: ind2; 5µ
L4: ind; 10µ
M1: nmos; 2N7000
M2: nmos; 2N7000
R1: res; 4.7K
R2: res; .001
R3: res; 0.001
R4: res; 4.7K
R5: res; 1K
RFC1: ind2; 10µ
RFC2: ind2; 10µ
Rout: res; 200
V1: voltage; SINE(0 {S} {F}); AC 1; Rser={Z}
V2: voltage; 12
V3: voltage; {BM2}
Named nets: 0, Vout, Vin, Vg2, Vd2, Vg1, Vd1, Vbias
.tran 0 10u 9u
;.step param F list 1.5Meg 3.7Meg 5.37Meg 7.1Meg 10.1Meg 14.1Meg 21.1Meg 28.7Meg
.param F 30Meg
;.step param S list .023 0.486
;.step param L 1u 11u 1u
;.step param R 200 425 25
.param BM2 2.3
.param S .5
.param Z 1
.param Vgs1 3.6
.param Vgs2 2.1
.param Vgs 1.9
K1 L1 L2 1
.ac dec 1000 1Meg 30Meg
.options plotwinsize=0
.options numdgt = 8
 
.meas TRAN Vinr RMS V(Vin)
.meas TRAN Voutr RMS V(Vout)
.meas TRAN Iinr RMS I(V1)
.meas TRAN Ioutr RMS I(Rout)
;;;;;;;;;;;;;;;;;;;;;;;;;;;;
.meas TRAN Vgr1 RMS V(Vg1)
.meas TRAN Vdr1 RMS V(Vd1)
.meas TRAN Idr1 RMS Id(M1)
.meas TRAN Igr1 RMS Ig(M1)
.meas TRAN Vgavg1 AVG V(Vg1)
.meas TRAN Vgmax1 MAX V(Vg1)
.meas TRAN Vgmin1 MIN V(Vg1)
.meas TRAN Vbiasr RMS V(Vbias)
.meas TRAN Vppr1 PARAM Vgmax1-Vgmin1
.meas TRAN Vpr1 PARAM Vgmax1-Vgs
.meas TRAN Cd1 PARAM Vpr1/Vppr1
;;;;;;;;;;;;;;;;;;;;;;;;;;;;
.meas TRAN Vgr 2RMS V(Vg2)
.meas TRAN Vdr2 RMS V(Vd2)
.meas TRAN Idr2 RMS Id(M2)
.meas TRAN Igr2 RMS Ig(M2)
.meas TRAN Vgavg2 AVG V(Vg2)
.meas TRAN Vgmax2 MAX V(Vg2)
.meas TRAN Vgmin2 MIN V(Vg2)
.meas TRAN Vppr2 PARAM Vgmax2-Vgmin2
.meas TRAN Vpr2 PARAM Vgmax2-Vgs
.meas TRAN Cd2 PARAM Vpr2/Vppr2
 
;;;;;;;;;;;;;;;;;;;;;;;;;;
.meas TRAN Pdis1 AVG (V(vd1)*Id(m1) + V(vg1)*Ig(m1))
.meas TRAN Pdis2 AVG (V(vd2)*Id(m2) + V(vg2)*Ig(m2))
.meas TRAN Pdis PARAM Pdis1+Pdis2
;;;;;;;;;;;;;;;;;;;;;;;;;;;
.meas TRAN Zin PARAM Vinr/Iinr
.meas TRAN Zout1 PARAM Vdr1/Idr1
.meas TRAN Zout2 PARAM Vdr2/Idr2
.meas TRAN CdAngle1 PARAM Cd1*360
.meas TRAN CdAngle2 PARAM Cd2*360
.meas TRAN Pin PARAM Zin*Iinr*Iinr
.meas TRAN Pout AVG (V(Vout)*I(Rout))
.meas TRAN Pmar PARAM Pout-Pdis
 ;;;;;;;;;;;;;;;;;;;;;;;;;;;
.meas TRAN Rv PARAM Voutr/Vinr
.meas TRAN Rp PARAM Pout/Pin
.meas TRAN Gp PARAM 10*log10(Rp)
.meas TRAN Gv PARAM 20*log10(Rv)
.meas TRAN Gi PARAM 20*log10(Ioutr/Iinr)
.meas TRAN Beta1 PARAM Idr1/Igr1
.meas TRAN Beta2 PARAM Idr2/Igr2
 
.four {F} 4 -1 V(Vout)
