drajnauth/Phoenix612/Analysis/Simulations/Transistor Biasing/2N7000 Input Characteristic Curve.asc

M1: nmos; 2N7000
Rc: res; 0.001
Vcc: voltage; 12
Vg: voltage; 0
Named nets: 0, Vds
.dc Vg 1.5 20 .01
https://www.youtube.com/watch?v=7WWJ2kfJ3oc
