drajnauth/Phoenix612/Analysis/Simulations/Transistor Biasing/2N7000 Parallel Pre Amp Testing.asc

C4: cap; .1µ
C6: cap; .1µ
C10: cap; .1µ
C11: cap; .1µ
C13: cap; .1µ
C14: cap; .1µ
L6: ind2; 22µ
L7: ind2; 218µ
M1: nmos; 2N7000
M2: nmos; 2N7000
M3: nmos; 2N7000
R2: res; .001
R3: res; 4.7K
R4: res; .001
R5: res; .001
R6: res; .001
R7: res; .001
R8: res; .001
RFC1: ind2; 10µ
RFC2: ind2; 10µ
Rout: res; {R}
V1: voltage; {BM2}
V2: voltage; 12
V5: voltage; SINE(0 {S} {F}); AC 1; Rser={Z}
Named nets: 0, Vout, Vin, Vg2, Vd2, Vbias, Vg1, Vd1, Vg3, Vd3
.tran 0 20u 19u
;.step param F list 1.5Meg 3.7Meg 5.37Meg 7.1Meg 10.1Meg 14.1Meg 21.1Meg 28.7Meg
;.step param F list  3.7Meg 14.1Meg 28.7Meg
.param F 30Meg
.param S 0.5
.param BM2 2.3
;.step param BM2 1.7 4 .2
;.step param R 50 150 10
.param R 100
.param Z 1
.param Vgs1 3.6
.param Vgs2 2.1
.param Vgs 1.9
K2 L7 L6 1
.options plotwinsize=0
.options numdgt = 8
 
.meas TRAN Vinr RMS V(Vin)
.meas TRAN Voutr RMS V(Vout)
.meas TRAN Iinr RMS I(V5)
.meas TRAN Ioutr RMS I(Rout)
;;;;;;;;;;;;;;;;;;;;;;;;;;;;
.meas TRAN Vgr1 RMS V(Vg1)
.meas TRAN Vdr1 RMS V(Vd1)
.meas TRAN Idr1 RMS Id(M1)
.meas TRAN Igr1 RMS Ig(M1)
.meas TRAN Vgavg1 AVG V(Vg1)
.meas TRAN Vgmax1 MAX V(Vg1)
.meas TRAN Vgmin1 MIN V(Vg1)
.meas TRAN Vbiasr RMS V(Vbias)
.meas TRAN Vppr1 PARAM Vgmax1-Vgmin1
.meas TRAN Vpr1 PARAM Vgmax1-Vgs
.meas TRAN Cd1 PARAM Vpr1/Vppr1
;;;;;;;;;;;;;;;;;;;;;;;;;;;;
.meas TRAN Vgr 2RMS V(Vg2)
.meas TRAN Vdr2 RMS V(Vd2)
.meas TRAN Idr2 RMS Id(M2)
.meas TRAN Igr2 RMS Ig(M2)
.meas TRAN Vgavg2 AVG V(Vg2)
.meas TRAN Vgmax2 MAX V(Vg2)
.meas TRAN Vgmin2 MIN V(Vg2)
.meas TRAN Vppr2 PARAM Vgmax2-Vgmin2
.meas TRAN Vpr2 PARAM Vgmax2-Vgs
.meas TRAN Cd2 PARAM Vpr2/Vppr2
;;;;;;;;;;;;;;;;;;;;;;;;;;;
.meas TRAN Vgr3 RMS V(Vg3)
.meas TRAN Vdr3 RMS V(Vd3)
.meas TRAN Idr3 RMS Id(M3)
.meas TRAN Igr3 RMS Ig(M3)
.meas TRAN Vgavg3 AVG V(Vg3)
.meas TRAN Vgmax3 MAX V(Vg3)
.meas TRAN Vgmin3 MIN V(Vg3)
.meas TRAN Vppr3 PARAM Vgmax3-Vgmin3
.meas TRAN Vpr3 PARAM Vgmax3-Vgs
.meas TRAN Cd3 PARAM Vpr3/Vppr3
;;;;;;;;;;;;;;;;;;;;;;;;;;
.meas TRAN Pdis1 AVG (V(vd1)*Id(m1) + V(vg1)*Ig(m1))
.meas TRAN Pdis2 AVG (V(vd2)*Id(m2) + V(vg2)*Ig(m2))
.meas TRAN Pdis3 AVG (V(vd3)*Id(m3) + V(vg3)*Ig(m3))
.meas TRAN Pdis PARAM Pdis1+Pdis2+Pdis3
;;;;;;;;;;;;;;;;;;;;;;;;;;;
.meas TRAN Zin PARAM Vinr/Iinr
.meas TRAN Zout1 PARAM Vdr1/Idr1
.meas TRAN Zout2 PARAM Vdr3/Idr2
.meas TRAN Zout3 PARAM Vdr3/Idr3
.meas TRAN CdAngle1 PARAM Cd1*360
.meas TRAN CdAngle2 PARAM Cd2*360
.meas TRAN CdAngle3 PARAM Cd3*360
.meas TRAN Pin PARAM Zin*Iinr*Iinr
.meas TRAN Pout AVG (V(Vout)*I(Rout))
.meas TRAN Pmar PARAM Pout-Pdis
 ;;;;;;;;;;;;;;;;;;;;;;;;;;;
.meas TRAN Rv PARAM Voutr/Vinr
.meas TRAN Rp PARAM Pout/Pin
.meas TRAN Gp PARAM 10*log10(Rp)
.meas TRAN Gv PARAM 20*log10(Rv)
.meas TRAN Gi PARAM 20*log10(Ioutr/Iinr)
.meas TRAN Beta1 PARAM Idr1/Igr1
.meas TRAN Beta2 PARAM Idr2/Igr2
.meas TRAN Beta3 PARAM Idr3/Igr3
 
.four {F} 4 -1 V(Vout)
