drajnauth/Phoenix612/Analysis/Simulations/Transistor Biasing/2N7000 Pre Amp Testing.asc

C1: cap; .1µ
C4: cap; .1µ
C10: cap; .1µ
C11: cap; .1µ
C13: cap; .1µ
C14: cap; .1µ
L6: ind2; 66µ
L7: ind2; 218µ
M2: nmos; BS170
R1: res; 1
R3: res; 4.7K
RFC2: ind2; 10µ
Rout: res; 100
V1: voltage; {BM2}
V2: voltage; 12
V5: voltage; SINE(0 {S} {F}); AC 1; Rser={Z}
Named nets: 0, Vout, Vin, Vg2, Vd2, Vbias2
.tran 0 20u 18u
.options plotwinsize=0
.options numdgt = 8
 
.meas TRAN Vinr RMS V(Vin)
.meas TRAN Voutr RMS V(Vout)
.meas TRAN Iinr RMS I(V5)
.meas TRAN Ioutr RMS I(Rout)
;;;;;;;;;;;;;;;;;;;;;;;;;;;
.meas TRAN Vgr2 RMS V(Vg2)
.meas TRAN Vdr2 RMS V(Vd2)
.meas TRAN Idr2 RMS Id(M2)
.meas TRAN Igr2 RMS Ig(M2)
.meas TRAN Vgavg2 AVG V(Vg2)
.meas TRAN Vgmax2 MAX V(Vg2)
.meas TRAN Vgmin2 MIN V(Vg2)
.meas TRAN Vbiasr2 RMS V(Vbias2)
.meas TRAN Vppr2 PARAM Vgmax2-Vgmin2
.meas TRAN Vpr2 PARAM Vgmax2-Vgs2
.meas TRAN Cd2 PARAM Vpr2/Vppr2
;;;;;;;;;;;;;;;;;;;;;;;;;;;
.meas TRAN Pdis2 AVG (V(vd2)*Id(m2) + V(vg2)*Ig(m2))
;;;;;;;;;;;;;;;;;;;;;;;;;;;
.meas TRAN Zin PARAM Vinr/Iinr
.meas TRAN Zout PARAM Vdr2/Idr2
.meas TRAN CdAngle2 PARAM Cd2*360
.meas TRAN Pin RMS (V(Vin)*I(V1))
.meas TRAN Pout AVG (V(Vout)*I(Rout))
.meas TRAN Pdis PARAM Pdis2
.meas TRAN Pmar PARAM Pout-Pdis
 ;;;;;;;;;;;;;;;;;;;;;;;;;;;
.meas TRAN Gpr PARAM (Pout/Pin)
.meas TRAN Gvr PARAM (Voutr/Vinr)
.meas TRAN Gp PARAM 10*log10(Gpr)
.meas TRAN Gv PARAM 20*log10(Gvr)
.meas TRAN Gi PARAM 20*log10(Ioutr/Iinr)
.meas TRAN Beta2 PARAM Idr2/Igr2
 
.four {F} 4 -1 V(Vout)
;.step param F list 1.5Meg 3.7Meg 5.37Meg 7.1Meg 10.1Meg 14.1Meg 21.1Meg 28.7Meg
;.step param F list  3.7Meg 14.1Meg 28.7Meg
.param F 28.7Meg
.param S 1
.param BM2 2.3
;.step param BM2 2.2 4 .2
;.step param R 50 500 50
.param Z 30
.param Vgs1 3.6
.param Vgs2 2.1
K2 L7 L6 1
include bs170.sub
