drajnauth/Phoenix612/Analysis/Simulations/Transistor Biasing/2N7000 x3 Pre Amp Testing.asc

C1: cap; .1µ
C2: cap; .1µ
C3: cap; .1µ
C4: cap; .1µ
C5: cap; .1µ
C6: cap; .1µ
C7: cap; 100µ
C8: cap; .1µ
C9: cap; .1µ
C10: cap; .1µ
C11: cap; .1µ
C12: cap; .1µ
C13: cap; .1µ
C14: cap; .1µ
C15: cap; .1µ
C16: cap; .1µ
C17: cap; .1µ
C18: cap; .1µ
L1: ind2; 66µ
L2: ind2; 66µ
L3: ind2; 66µ
M1: nmos; 2N7002
M2: nmos; 2N7002
M3: nmos; 2N7002
R1: res; 4K
R2: res; 4K
R3: res; 4K
R4: res; 2000
R5: res; 2000
RFC1: ind2; 10µ
RFC2: ind2; 10µ
RFC3: ind2; 10µ
Rin: res; {Z}
Rout: res; 100
Rsense2: res; .0001
Rsense3: res; .0001
V1: voltage; {BM2}
V2: voltage; 12
V5: voltage; SINE(0 {S} {F}); AC 1
Named nets: 0, Vout, Vin, Vg1, Vd1, Vbias2, Vg2, Vd2, Vs2, Vg3, Vd3, Vs3
.options plotwinsize=0
.options numdgt = 8
 
.meas TRAN Vinr RMS V(Vin)
.meas TRAN Voutr RMS V(Vout)
.meas TRAN Iinr RMS I(Rin)
.meas TRAN Ioutr RMS I(Rout)
;;;;;;;;;;;;;;;;;;;;;;;;;;;
.meas TRAN Vgr1 RMS V(Vg1)
.meas TRAN Vdr1 RMS V(Vd1)
.meas TRAN Idr1 RMS IdM1)
.meas TRAN Igr1 RMS Ig(M1)
.meas TRAN Vgavg1 AVG V(Vg1)
.meas TRAN Vgmax1 MAX V(Vg1)
.meas TRAN Vgmin1 MIN V(Vg1)
.meas TRAN Vbiasr1 RMS V(Vbias2)
.meas TRAN Vppr1 PARAM Vgmax1-Vgmin1
.meas TRAN Vpr1 PARAM Vgmax1-Vgs2
.meas TRAN Cd1 PARAM Vpr1/Vppr1
;;;;;;;;;;;;;;;;;;;;;;;;;;;
.meas TRAN Vgr2 RMS V(Vg2)
.meas TRAN Vdr2 RMS V(Vd2)
.meas TRAN Idr2 RMS Id(M2)
.meas TRAN Igr2 RMS Ig(M2)
.meas TRAN Vgavg2 AVG V(Vg2)
.meas TRAN Vgmax2 MAX V(Vg2)
.meas TRAN Vgmin2 MIN V(Vg2)
.meas TRAN Vbiasr2 RMS V(Vbias2)
.meas TRAN Vppr2 PARAM Vgmax2-Vgmin2
.meas TRAN Vpr2 PARAM Vgmax2-Vgs2
.meas TRAN Cd2 PARAM Vpr2/Vppr2
;;;;;;;;;;;;;;;;;;;;;;;;;;;
.meas TRAN Vgr3 RMS V(Vg3)
.meas TRAN Vdr3 RMS V(Vd3)
.meas TRAN Idr3 RMS Id(M3)
.meas TRAN Igr3 RMS Ig(M3)
.meas TRAN Vgavg3 AVG V(Vg3)
.meas TRAN Vgmax3 MAX V(Vg3)
.meas TRAN Vgmin3 MIN V(Vg3)
.meas TRAN Vbiasr3 RMS V(Vbias2)
.meas TRAN Vppr3 PARAM Vgmax3-Vgmin3
.meas TRAN Vpr3 PARAM Vgmax3-Vgs2
.meas TRAN Cd3 PARAM Vpr3/Vppr2
;;;;;;;;;;;;;;;;;;;;;;;;;;;
.meas TRAN Pdis1 AVG (V(vd1)*Id(M1) + V(vg1)*Ig(M1))
.meas TRAN Pdis2 AVG (V(vd2)*Id(M2) + V(vg2)*Ig(M2))
.meas TRAN Pdis3 AVG (V(vd3)*Id(M3) + V(vg3)*Ig(M3))
;;;;;;;;;;;;;;;;;;;;;;;;;;;
.meas TRAN Isr2 RMS I(Rsense2)
.meas TRAN Vsr2 RMS V(Vs2)
.meas TRAN Isr3 RMS I(Rsense3)
.meas TRAN Vsr3 RMS V(Vs3)
.meas TRAN Zin PARAM Vinr/Iinr
.meas TRAN Zout PARAM Vdr3/Idr3
.meas TRAN ZinM2 PARAM Vsr2/Isr2
.meas TRAN ZinM3 PARAM Vsr3/Isr3
.meas TRAN ZoutM1 PARAM Vdr1/Idr1
.meas TRAN ZoutM2 PARAM Vdr2/Idr2
.meas TRAN ZoutM3 PARAM Vdr3/Idr3
.meas TRAN CdAngle1 PARAM Cd1*360
.meas TRAN CdAngle2 PARAM Cd2*360
.meas TRAN CdAngle3 PARAM Cd3*360
.meas TRAN Pin RMS (V(Vin)*I(Rin))
.meas TRAN Pout AVG (V(Vout)*I(Rout))
.meas TRAN Pdis PARAM Pdis2+Pdis1
.meas TRAN Pmar PARAM Pout-Pdis
 ;;;;;;;;;;;;;;;;;;;;;;;;;;;
.meas TRAN GM1 PARAM (Vsr2/Vinr)
.meas TRAN GM2 PARAM (Vsr3/Vsr2)
.meas TRAN GM3 PARAM (Voutr/Vsr3)
.meas TRAN Gpr PARAM (Pout/Pin)
.meas TRAN Gvr PARAM (Voutr/Vinr)
.meas TRAN Gp PARAM 10*log10(Gpr)
.meas TRAN Gv PARAM 20*log10(Gvr)
.meas TRAN Gi PARAM 20*log10(Ioutr/Iinr)
.meas TRAN Beta2 PARAM Idr2/Igr2
 
.four {F} 4 -1 V(Vout)
;.step param F list 1.5Meg 3.7Meg 5.37Meg 7.1Meg 10.1Meg 14.1Meg 21.1Meg 28.7Meg
;.step param F list  3.7Meg 14.1Meg 28.7Meg
.param F 28.7Meg
.param S .01
.param BM2 2.8
;.step param BM2 2.2 4 .2
;.step param R 50 500 50
.param Z 1
.param Vgs1 3.6
.param Vgs2 2.1
Need 4.5Vp Output at 100R
50 Zin
.tran 0 20u 18u
