drajnauth/Phoenix612/Analysis/Simulations/Transistor Biasing/2sc5706 5W Testing.asc

C1: cap; 1µ
C2: cap; .1µ
C3: cap; .1µ
C4: cap; 1µ
C5: cap; .1µ
C6: cap; 220µ
C7: cap; .1µ
C8: cap; 1µ
C9: cap; .1µ
C10: cap; 4n
C11: cap; .1µ
C12: cap; .1µ
C13: cap; .1µ
L1: ind2; 17µ
L2: ind2; 35µ
L3: ind; 1µ
L4: ind; 60µ
L5: ind; 35µ
Q1: npn; 2SC5706
Q2: npn; 2N2219A
R1: res; 450
R2: res; 160
R3: res; 2.8
R4: res; 500
R5: res; 5
R7: res; 800
Rcouple1: res; .001
Rout: res; 50
V1: voltage; SINE(0 {S} {F}); AC 1; Rser=50
V2: voltage; 12
Named nets: 0, Vout, Vb, Ve, Vin, Vc, Vb2, Vc2, Ve2
.tran 0 10u 9.5u
.options plotwinsize=0
.options numdgt = 8
 
 
 
.meas TRAN Vinr RMS V(Vin)
.meas TRAN Voutr RMS V(Vout)
.meas TRAN Iinr RMS I(V1)
;;;;;;;;;;;;;;;;;;;;;;;;;;;;
.meas TRAN Vbr RMS V(Vb)
.meas TRAN Vcr RMS V(Vc)
.meas TRAN Icr RMS Ic(Q1)
.meas TRAN Ibr RMS Ib(Q1)
.meas TRAN Vbavg AVG V(Vb)
.meas TRAN Vbmax MAX V(Vb)
.meas TRAN Vbmin MIN V(Vb)
.meas TRAN Vppr PARAM Vbmax-Vbmin
.meas TRAN Vpr PARAM Vbmax-Vbe
.meas TRAN Cd PARAM Vpr/Vppr
;;;;;;;;;;;;;;;;;;;;;;;;;;;
.meas TRAN Vb2r RMS V(Vb2)
.meas TRAN Vc2r RMS V(Vc2)
.meas TRAN Ve2r RMS V(Ve2)
.meas TRAN Ic2r RMS Ic(Q2)
.meas TRAN Ib2r RMS Ib(Q2)
.meas TRAN Ie2r RMS Ie(Q2)
.meas TRAN Vb2avg AVG V(Vb2)
.meas TRAN Vb2max MAX V(Vb2)
.meas TRAN Vb2min MIN V(Vb2)
.meas TRAN Vpp2r PARAM Vb2max-Vb2min
.meas TRAN Vp2r PARAM Vb2max-Vbe
.meas TRAN Cd2 PARAM Vp2r/Vpp2r
;;;;;;;;;;;;;;;;;;;;;;;;;;;;
.meas TRAN Icouple1 RMS I(Rcouple1)
.meas TRAN Icouple2 RMS I(Rcouple2)
 
 ;;;;;;;;;;;;;;;;;;;;;;;;;;;
.meas TRAN PQ2dis AVG (V(Vc2,Ve2)*Ic(Q2) + V(Vb2,Ve2)*Ib(Q2))
.meas TRAN Pdis AVG (V(Vc,Ve)*Ic(Q1) + V(Vb,Ve)*Ib(Q1))
;;;;;;;;;;;;;;;;;;;;;;;;;;;
.meas TRAN Zin PARAM Vinr/Iinr
.meas TRAN Zout PARAM Vcr/Icr
;;;;;;;;;;;;;;;;;;;;;;;;;;;
.meas TRAN ZQ2in PARAM Vb2r/Ib2r 
.meas TRAN ZQ2out PARAM Ve2r/Icouple2
.meas TRAN ZQ2eout PARAM Ve2r/Ie2r
;;;;;;;;;;;;;;;;;;;;;;;;;;;
.meas TRAN Q2Angle PARAM Cd2*360
.meas TRAN CdAngle PARAM Cd*360
;;;;;;;;;;;;;;;;;;;;;;;;;;;
.meas TRAN Pin PARAM Zin*Iinr*Iinr
.meas TRAN Pout AVG (V(Vout)*I(Rout))
.meas TRAN Pmar PARAM Pout-Pdis
 ;;;;;;;;;;;;;;;;;;;;;;;;;;;
.meas TRAN Gp PARAM 10*log10(Pout/Pin)
.meas TRAN Gv PARAM 20*log10(Voutr/Vinr)
 
.four {F} 4 -1 V(Vout)
;.step param F list 1.5Meg 3.7Meg 5.37Meg 7.1Meg 10.1Meg 14.1Meg 21.1Meg 28.7Meg
;.step param F list 3.7Meg 14.1Meg 28.7Meg
.param F 30Meg
.param S 1
.param Z 2
.param Vbe 0.68
K1 L1 L2 1
.ac dec 1000 1Meg 30Meg
Opamps clips when output is between 75-85% of Vcc
