drajnauth/Phoenix612/(list of files, drawings)

Other design files:
Dueling 612 Diptrace/AD603 Amp.dip
Dueling 612 Diptrace/CAT Interface v1.dip
Dueling 612 Diptrace/CrystalFilter.dch
Dueling 612 Diptrace/Dueling 612s 2N2222 PreAmp.dip
Dueling 612 Diptrace/Dueling 612s - Bridge.dip
Dueling 612 Diptrace/Dueling 612s - Complete.dch
Dueling 612 Diptrace/Dueling 612s - Complete.dip
Dueling 612 Diptrace/Dueling 612s - Development Platform.dch
Dueling 612 Diptrace/Dueling 612s - J310 PreAmp.dip
Dueling 612 Diptrace/Dueling 612s - Rx Switching Test.dip
Dueling 612 Diptrace/Dueling 612s New PA Apr2019.dip
Dueling 612 Diptrace/Dueling 612s PreAmp Test.dip
Dueling 612 Diptrace/Dueling 612s Rx Test.dip
Dueling 612 Diptrace/Dueling 612s RxTx Test.dip
Dueling 612 Diptrace/Dueling 612s RxTx V2 Test.dip
Dueling 612 Diptrace/Dueling 612s RxTx V3 Test.dip
Dueling 612 Diptrace/Dueling 612s V4 Apr2019.dch
Dueling 612 Diptrace/Dueling 612s V4 Apr2019.dip
Dueling 612 Diptrace/Dueling 612s V4 Feb2019.dip
Dueling 612 Diptrace/Dueling 612s V4.1 Apr2019.dch
Dueling 612 Diptrace/Dueling 612s V4.1 Apr2019.dip
Dueling 612 Diptrace/Dueling 612s V4.1 May2019.dch
Dueling 612 Diptrace/Dueling 612s V4.1a Apr2019.dip
Dueling 612 Diptrace/Dueling 612s V4.1b Apr2019.dip
Dueling 612 Diptrace/Dueling 612s V4.1c Apr2019.dip
Dueling 612 Diptrace/Dueling 612s V4.1d Apr2019.dip
Dueling 612 Diptrace/Dueling 612s V4.2 May2019 - errata.dch
Dueling 612 Diptrace/Dueling 612s V4.2 May2019.dch
Dueling 612 Diptrace/Dueling 612s V4.2 May2019.dip
Dueling 612 Diptrace/HMC197 Relay.dip
Dueling 612 Diptrace/MASWSS0115 Relay.dip
Dueling 612 Diptrace/Sudden Transceiver.dch
Dueling 612 Diptrace/Sudden Transceiver.dip
Peter Audio Amp/Receiver_POC.dsn
Phoenix612 Complete/Version 1.1/Phoenix612 Complete v1.1.dsn
