drajnauth/Phoenix612/sMeter Daughter Board v1/sMeter Daughter Board v1.kicad_pcb

## KiCad design sMeter Daughter Board v1/sMeter Daughter Board v1.kicad_pcb (2023-05-08)

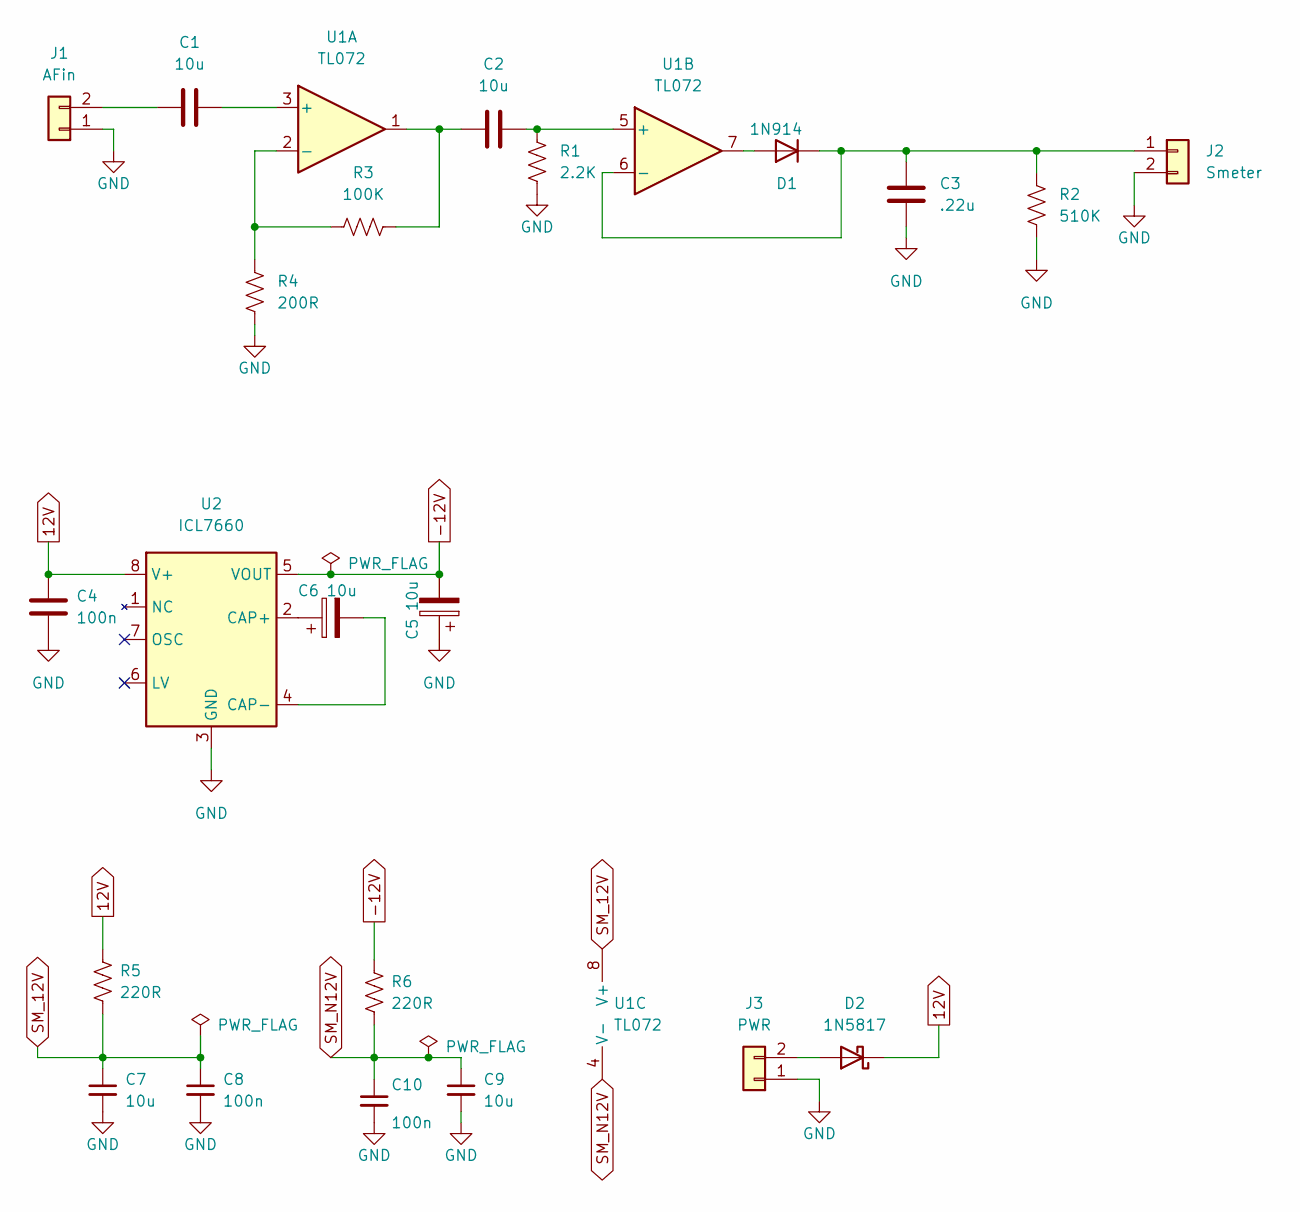
[picture p62: schematic sMeter Daughter Board v1.kicad_sch]

Parts:
C1, C2, C7, C9: 10u; C_1206_3216Metric
C3: .22u; C_1206_3216Metric
C4, C8, C10: 100n; C_1206_3216Metric
C5, C6: 10u; CP_Radial_D8.0mm_P2.50mm
D1: 1N914; D_DO-35_SOD27_P7.62mm_Horizontal
D2: 1N5817; D_DO-41_SOD81_P10.16mm_Horizontal
J1: AFin; PinHeader_1x02_P2.54mm_Vertical
J2: Smeter; PinHeader_1x02_P2.54mm_Vertical
J3: PWR; PinHeader_1x02_P2.54mm_Vertical
R1: 2.2K; R_1206_3216Metric
R2: 510K; R_1206_3216Metric
R3: 100K; R_1206_3216Metric
R4: 200R; R_1206_3216Metric
R5, R6: 220R; R_1206_3216Metric
U1: TL072; DIP-8_W7.62mm_Socket
U2: ICL7660; SOIC-8_3.9x4.9mm_P1.27mm

Connections:
12V: C4.2, D2.1 (K), R5.1, U2.8 (V+)
-12V: C5.2, R6.1, U2.5 (VOUT)
GND: C3.2, C4.1, C5.1, C7.2, C8.2, C9.2, C10.2, J1.1, J2.2, J3.1, R1.1, R2.1, R4.2, U2.3 (GND)
unnamed: C1.1, J1.2
unnamed: C1.2, U1.3 (+)
unnamed: C2.1, R3.2, U1.1
unnamed: C2.2, R1.2, U1.5 (+)
unnamed: C3.1, D1.1 (K), J2.1, R2.2, U1.6 (-)
unnamed: C6.1, U2.2 (CAP+)
unnamed: C6.2, U2.4 (CAP-)
unnamed: D1.2 (A), U1.7
unnamed: D2.2 (A), J3.2
unnamed: R3.1, R4.1, U1.2 (-)
SM_12V: C7.1, C8.1, R5.2, U1.8 (V+)
SM_N12V: C9.1, C10.1, R6.2, U1.4 (V-)

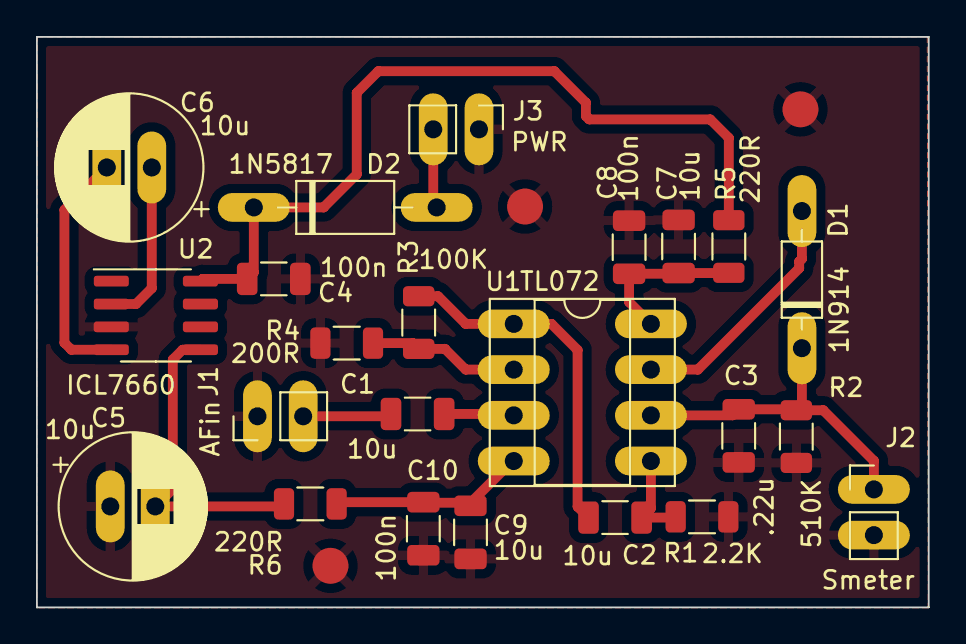
[picture p63: board sMeter Daughter Board v1.kicad_pcb from above]

Board: 2 copper layers, 49.5 x 31.7 mm, 23 parts (0 on the bottom side), 15 nets.
