drajnauth/Phoenix612/Power Daughter Board v1/Power Daughter Board v1.kicad_pcb

## KiCad design Power Daughter Board v1/Power Daughter Board v1.kicad_pcb (2023-05-08)

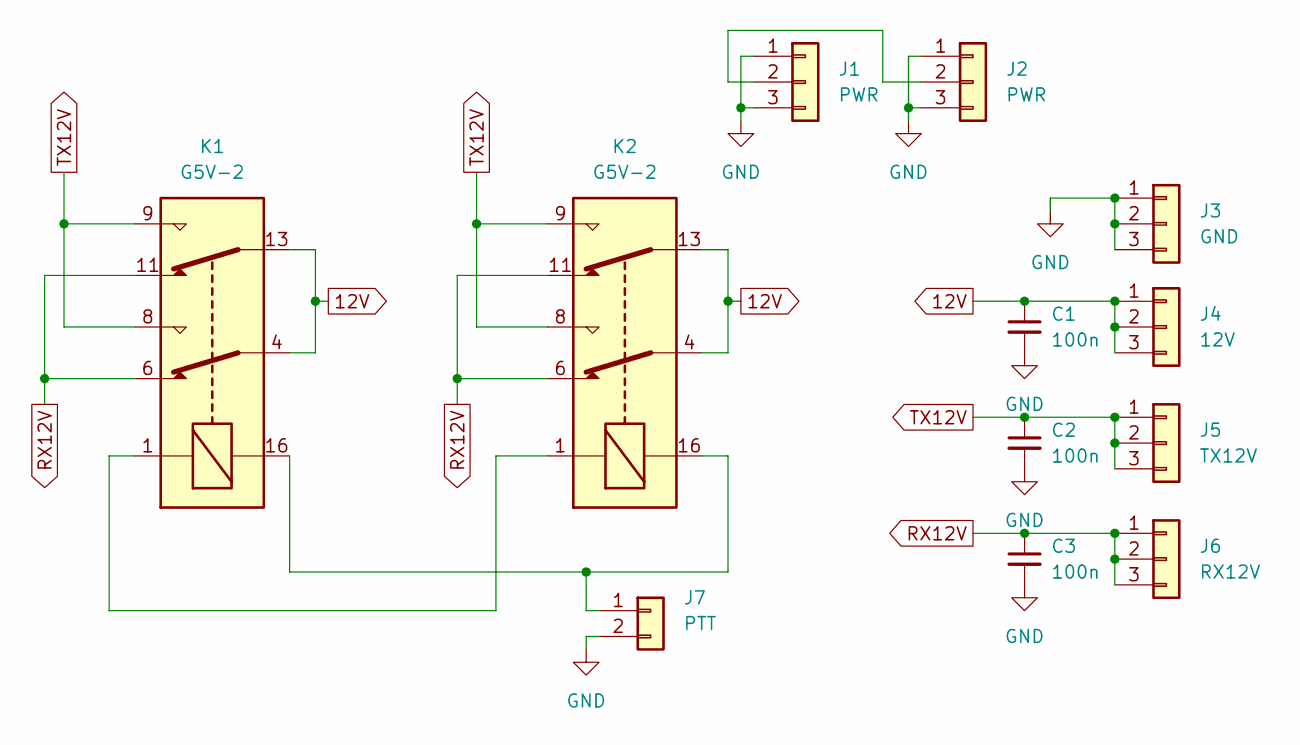
[picture p64: schematic Power Daughter Board v1.kicad_sch]

Parts:
C1, C2, C3: 100n; C_1206_3216Metric
J1, J2: PWR; PinHeader_1x03_P2.54mm_Vertical
J3: GND; PinHeader_1x03_P2.54mm_Vertical
J4: 12V; PinHeader_1x03_P2.54mm_Vertical
J5: TX12V; PinHeader_1x03_P2.54mm_Vertical
J6: RX12V; PinHeader_1x03_P2.54mm_Vertical
J7: PTT; PinHeader_1x02_P2.54mm_Vertical
K1, K2: G5V-2; Relay_DPDT_Omron_G5V-2

Connections:
12V: C1.1, J4.1, J4.2, J4.3, K1.4, K1.13, K2.4, K2.13
GND: C1.2, C2.2, C3.2, J1.1, J1.3, J2.1, J2.3, J3.1, J3.2, J3.3, J7.2
unnamed: J1.2, J2.2
unnamed: J7.1, K1.16, K2.16
unnamed: K1.1, K2.1
RX12V: C3.1, J6.1, J6.2, J6.3, K1.6, K1.11, K2.6, K2.11
TX12V: C2.1, J5.1, J5.2, J5.3, K1.8, K1.9, K2.8, K2.9

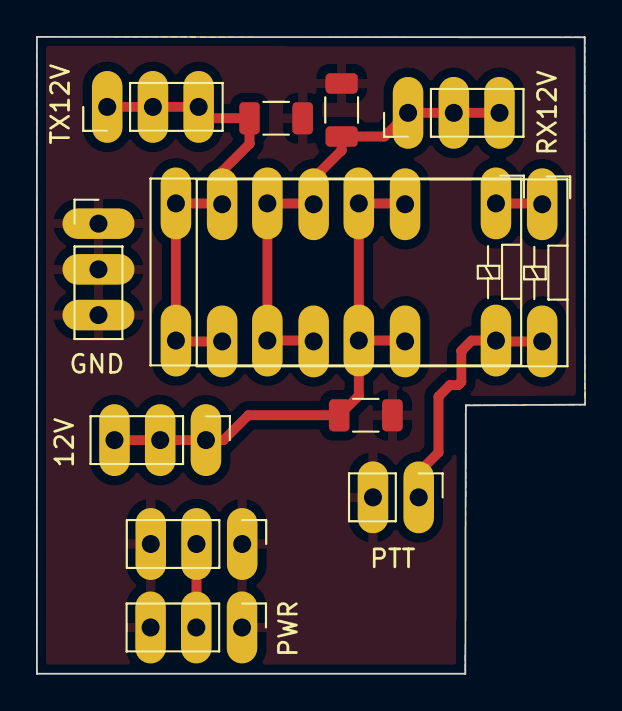
[picture p65: board Power Daughter Board v1.kicad_pcb from above]

Board: 2 copper layers, 30.5 x 35.4 mm, 12 parts (0 on the bottom side), 7 nets.
