drajnauth/Phoenix612/Peter Audio Amp/Receiver_POC.kicad_pcb

## KiCad design Peter Audio Amp/Receiver_POC.kicad_pcb (2023-02-21)

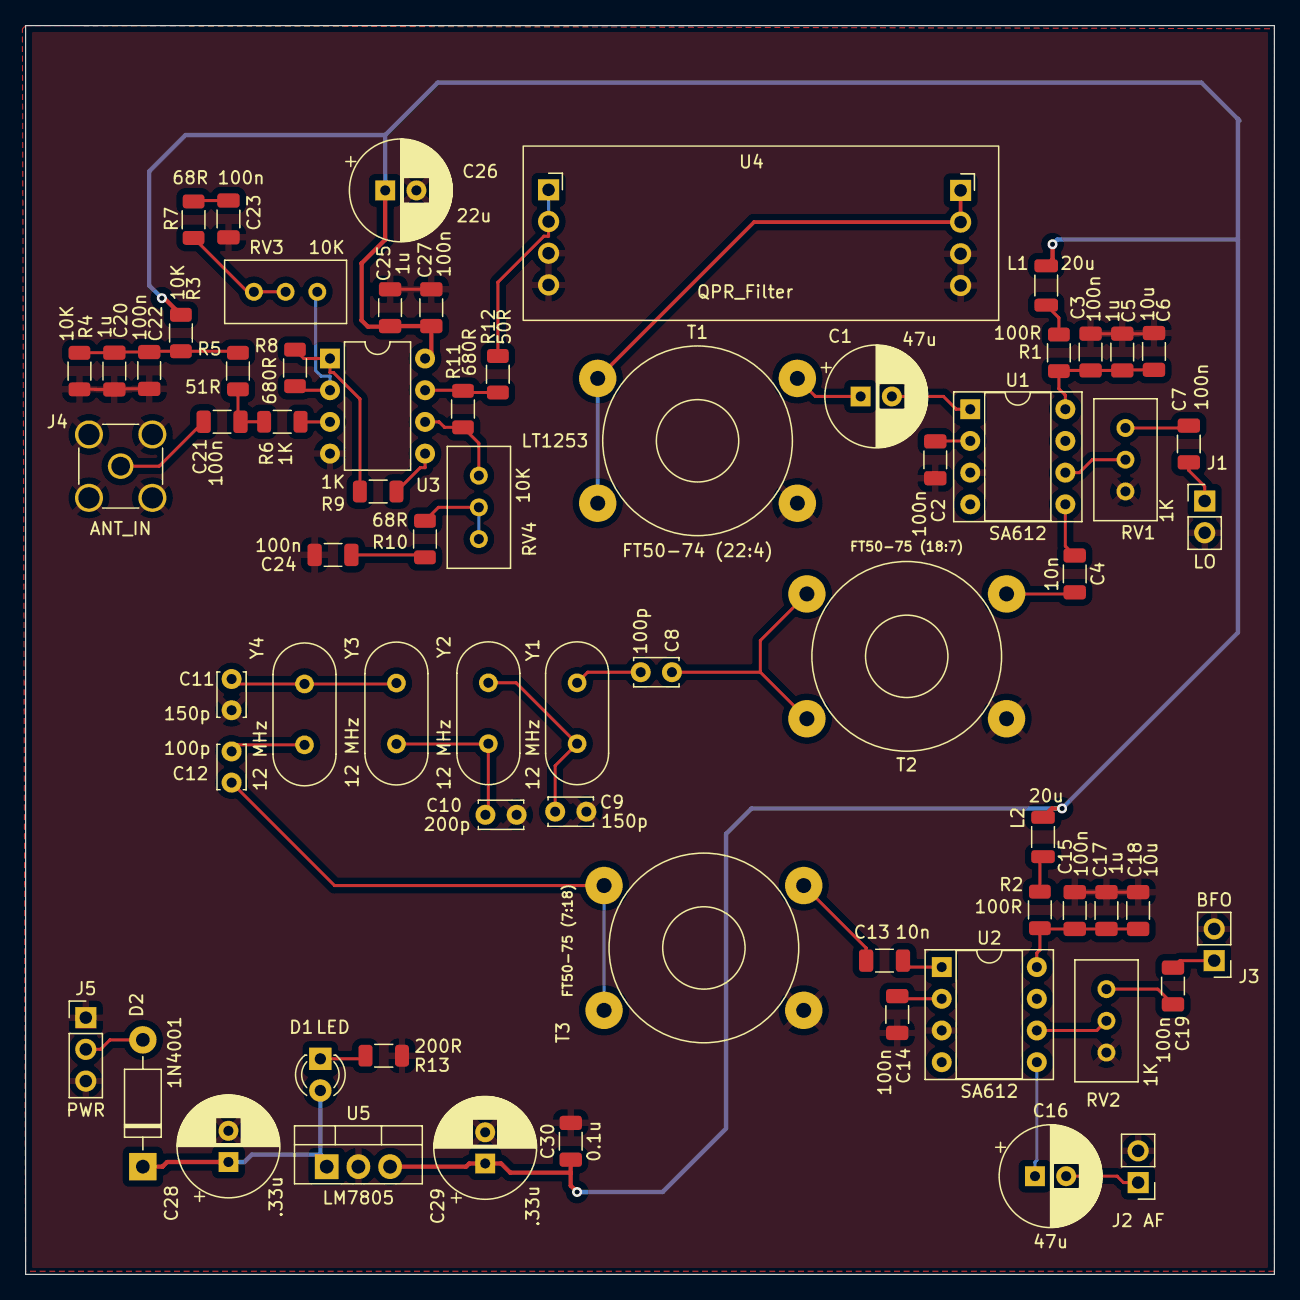
[picture p66: board Receiver_POC.kicad_pcb from above]

Board: 2 copper layers, 100.1 x 100.1 mm, 68 parts (0 on the bottom side), 47 nets.

Parts:
C1, C16: 47u; CP_Radial_D8.0mm_P2.50mm
C2, C3, C7, C14, C15, C19, C21, C22, C23, C24, C27: 100n; C_1206_3216Metric
C4, C13: 10n; C_1206_3216Metric
C5, C17, C20, C25: 1u; C_1206_3216Metric
C6, C18: 10u; C_1206_3216Metric
C8, C12: 100p; C_Disc_D3.4mm_W2.1mm_P2.50mm
C9, C11: 150p; C_Disc_D3.4mm_W2.1mm_P2.50mm
C10: 200p; C_Disc_D3.4mm_W2.1mm_P2.50mm
C26: 22u; CP_Radial_D8.0mm_P2.50mm
C28, C29: .33u; CP_Radial_D8.0mm_P2.50mm
C30: 0.1u; C_1206_3216Metric
D1: LED; LED_D3.0mm
D2: 1N4001; D_DO-41_SOD81_P10.16mm_Horizontal
J1: LO; PinHeader_1x02_P2.54mm_Vertical
J2: AF; PinHeader_1x02_P2.54mm_Vertical
J3: BFO; PinHeader_1x02_P2.54mm_Vertical
J4: ANT_IN; SMA_Amphenol_901-144_Vertical
J5: PWR; PinHeader_1x03_P2.54mm_Vertical
L1, L2: 20u; L_1206_3216Metric
R1, R2: 100R; R_1206_3216Metric
R3, R4: 10K; R_1206_3216Metric
R5: 51R; R_1206_3216Metric
R6, R9: 1K; R_1206_3216Metric
R7, R10: 68R; R_1206_3216Metric
R8, R11: 680R; R_1206_3216Metric
R12: 50R; R_1206_3216Metric
R13: 200R; R_1206_3216Metric
RV1, RV2: 1K; Potentiometer_Bourns_3296W_Vertical
RV3, RV4: 10K; Potentiometer_Bourns_3296W_Vertical
T1: FT50-74 (22:4); Transformer_Toroid_Horizontal_D14.0mm_Amidon-T50
T2: FT50-75 (18:7); Transformer_Toroid_Horizontal_D14.0mm_Amidon-T50
T3: FT50-75 (7:18); Transformer_Toroid_Horizontal_D14.0mm_Amidon-T50
U1, U2: SA612; DIP-8_W7.62mm_Socket
U3: LT1253; DIP-8_W7.62mm
U4: QPR_Filter; QRPLabs_Filter_TH
U5: LM7805; TO-220-3_Vertical
Y1, Y2, Y3, Y4: 12 MHz; Crystal_HC49-4H_Vertical

Connections:
12V: C28.1, D1.2 (A), D2.1 (K), U5.1 (VI)
GND: C2.2, C3.2, C5.2, C6.2, C9.2, C10.2, C11.2, C14.2, C15.2, C17.2, C18.2, C20.2, C22.2, C23.2, C24.2, C25.2, C26.2, C27.2, C28.2, C29.2, C30.2, J1.2, J2.2, J3.2, J4.2 (Ext), J5.1, J5.3, R4.2, R13.2, RV1.3, RV2.3, T1.2 (AB), T2.3 (SA), T3.2 (AB), U1.3 (GND), U2.3 (GND), U3.4 (V-), U4.3 (GND), U4.4 (GND), U4.5 (GND), U4.6 (GND), U5.2 (GND)
IFAFOUT: C16.2, J2.1
IFRFIN: T1.1 (AA), T1.3 (SA), U4.7 (OUT), U4.8 (OUT)
unnamed: C1.1, T1.4 (SB)
unnamed: C1.2, U1.1 (IN_A)
unnamed: C2.1, U1.2 (IN_B)
unnamed: C3.1, C5.1, C6.1, R1.2, U1.8 (Vcc)
unnamed: C4.1, U1.5 (OUT_B)
unnamed: C4.2, T2.1 (AA)
unnamed: C7.1, J1.1
unnamed: C7.2, RV1.1
unnamed: C8.1, T2.2 (AB), T2.4 (SB)
unnamed: C8.2, Y1.1
unnamed: C9.1, Y1.2, Y2.1
unnamed: C10.1, Y2.2, Y3.1
unnamed: C11.1, Y3.2, Y4.1
unnamed: C12.1, Y4.2
unnamed: C12.2, T3.1 (AA), T3.3 (SA)
unnamed: C13.1, T3.4 (SB)
unnamed: C13.2, U2.1 (IN_A)
unnamed: C14.1, U2.2 (IN_B)
unnamed: C15.1, C17.1, C18.1, R2.2, U2.8 (Vcc)
unnamed: C16.1, U2.5 (OUT_B)
unnamed: C19.1, J3.1
unnamed: C19.2, RV2.1
unnamed: C20.1, C22.1, R3.2, R4.1, R5.2
unnamed: C21.1, J4.1 (In)
unnamed: C21.2, R5.1, R6.1
unnamed: C23.1, R7.2
unnamed: C24.1, R10.2
unnamed: D1.1 (K), R13.1
unnamed: D2.2 (A), J5.2
unnamed: L1.2, R1.1
unnamed: L2.2, R2.1
unnamed: R6.2, U3.3 (InA+)
unnamed: R7.1, RV3.2, RV3.3
unnamed: R8.1, RV3.1, U3.2 (InA-)
unnamed: R8.2, R9.1, U3.1 (OutA)
unnamed: R9.2, U3.5 (InB+)
unnamed: R10.1, RV4.2, RV4.3
unnamed: R11.1, R12.1, U3.7 (OutB)
unnamed: R11.2, RV4.1, U3.6 (InB-)
unnamed: R12.2, U4.1 (IN), U4.2 (IN)
unnamed: RV1.2, U1.6 (OSC_B)
unnamed: RV2.2, U2.6 (OSC_B)
RX5V: C25.1, C26.1, C27.1, C29.1, C30.1, L1.1, L2.1, R3.1, U3.8 (V+), U5.3 (VO)
