drajnauth/Phoenix612/Phoenix612.kicad_pcb

## KiCad design Phoenix612.kicad_pcb (2022-09-07)

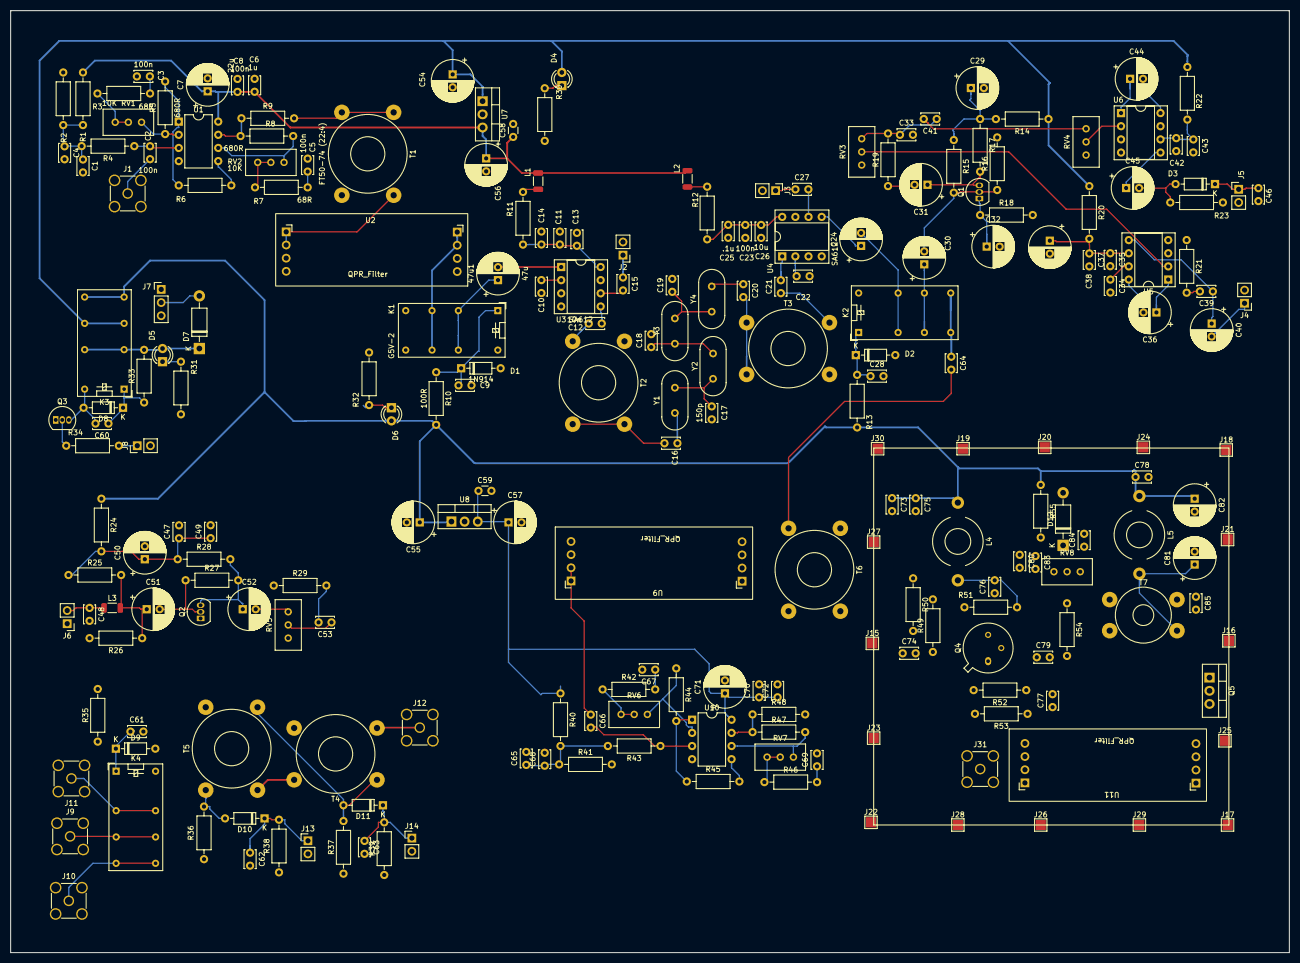
[picture p67: board Phoenix612.kicad_pcb from above]

Board: 2 copper layers, 246.9 x 181.9 mm, 228 parts (0 on the bottom side), 126 nets.

Parts:
47u1: 47u; CP_Radial_D8.0mm_P2.50mm
C1, C6, C34, C65, C70, C78: 1u; C_Disc_D3.4mm_W2.1mm_P2.50mm
C2, C3, C4, C5, C8, C9, C10, C11, C15, C22, C23, C27, C28, C35, C42, C47, C60, C61, C62, C63, C66, C67, C68, C69, C72, C73, C74, C76, C77, C79, C80, C85: 100n; C_Disc_D3.4mm_W2.1mm_P2.50mm
C7, C54, C55, C56, C57, C71: 22u; CP_Radial_D8.0mm_P2.50mm
C12, C21, C33, C39, C46, C48, C53, C64: 10n; C_Disc_D3.4mm_W2.1mm_P2.50mm
C13, C25: .1u; C_Disc_D3.4mm_W2.1mm_P2.50mm
C14, C26, C41, C75, C83, C84: 10u; C_Disc_D3.4mm_W2.1mm_P2.50mm
C16, C20: 100p; C_Disc_D3.4mm_W2.1mm_P2.50mm
C17, C19: 150p; C_Disc_D3.4mm_W2.1mm_P2.50mm
C18: 200p; C_Disc_D3.4mm_W2.1mm_P2.50mm
C24, C29, C30, C31, C50, C51, C52: 47u; CP_Radial_D8.0mm_P2.50mm
C32, C40, C82: 100u; CP_Radial_D8.0mm_P2.50mm
C36, C44, C45: 10u; CP_Radial_D8.0mm_P2.50mm
C37, C43, C49: 1n; C_Disc_D3.4mm_W2.1mm_P2.50mm
C38: 220u; CP_Radial_D8.0mm_P2.50mm
C58, C59: 0.1u; C_Disc_D3.0mm_W1.6mm_P2.50mm
C81: .22u; CP_Radial_D8.0mm_P2.50mm
D1, D2, D8, D9, D10, D11: 1N914; D_DO-35_SOD27_P7.62mm_Horizontal
D3: 1N4148; D_DO-35_SOD27_P7.62mm_Horizontal
D4, D5, D6: LED; LED_D3.0mm
D7: 1N4001; D_DO-41_SOD81_P10.16mm_Horizontal
D12: 1N4733A; D_DO-41_SOD81_P10.16mm_Horizontal
J1, J9: ANT_IN; SMA_Amphenol_901-144_Vertical
J2: LO/BFO; PinHeader_1x02_P2.54mm_Vertical
J3: BFO/LO; PinHeader_1x02_P2.54mm_Vertical
J4: SPK; PinHeader_1x02_P2.54mm_Vertical
J5: Smeter; PinHeader_1x02_P2.54mm_Vertical
J6: MICIN; PinHeader_1x02_P2.54mm_Vertical
J7: PWR; PinHeader_1x03_P2.54mm_Vertical
J8: uC PTT; PinHeader_1x02_P2.54mm_Vertical
J10, J31: ANT_OUT; SMA_Amphenol_901-144_Vertical
J11: ANT; SMA_Amphenol_901-144_Vertical
J12: PA_OUT; SMA_Amphenol_901-144_Vertical
J13: Fwd; PinHeader_1x02_P2.54mm_Vertical
J14: Rev; PinHeader_1x02_P2.54mm_Vertical
J15, J16, J17, J18, J19, J20, J21, J22, J23, J24, J25, J26, J27, J28, J29, J30: Conn_01x01; TestPoint_Pad_2.0x2.0mm
K1, K2, K3, K4: G5V-2; Relay_DPDT_Omron_G5V-2
L1, L2, L3: 20u; L_1206_3216Metric
L4, L5: FT-37-43 (8T); L_Toroid_Horizontal_D9.5mm_P15.00mm_Diameter10-5mm_Amidon-T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
Q1, Q2, Q3: 2N3904; TO-92_Inline
Q4: 2N2219; TO-39-3
Q5: IRF510; TO-220-3_Vertical
R1, R2, R16, R25, R26, R28, R40, R41: 10K; R_Axial_DIN0207_L6.3mm_D2.5mm_P10.16mm_Horizontal
R3, R7, R42, R46: 68R; R_Axial_DIN0207_L6.3mm_D2.5mm_P10.16mm_Horizontal
R4, R36, R37, R43, R54: 51R; R_Axial_DIN0207_L6.3mm_D2.5mm_P10.16mm_Horizontal
R5, R8, R44, R47, R49: 680R; R_Axial_DIN0207_L6.3mm_D2.5mm_P10.16mm_Horizontal
R6, R30, R31, R32, R45: 200R; R_Axial_DIN0207_L6.3mm_D2.5mm_P10.16mm_Horizontal
R9, R48: 50R; R_Axial_DIN0207_L6.3mm_D2.5mm_P10.16mm_Horizontal
R10, R11, R12, R13, R14, R20, R22, R24, R33, R35: 100R; R_Axial_DIN0207_L6.3mm_D2.5mm_P10.16mm_Horizontal
R15: 100K; R_Axial_DIN0207_L6.3mm_D2.5mm_P10.16mm_Horizontal
R17, R50, R55: 1K; R_Axial_DIN0207_L6.3mm_D2.5mm_P10.16mm_Horizontal
R18: 470R; R_Axial_DIN0207_L6.3mm_D2.5mm_P10.16mm_Horizontal
R19: 2.7K; R_Axial_DIN0207_L6.3mm_D2.5mm_P10.16mm_Horizontal
R21, R23, R29, R52: 10R; R_Axial_DIN0207_L6.3mm_D2.5mm_P10.16mm_Horizontal
R27, R38, R39: 220R; R_Axial_DIN0207_L6.3mm_D2.5mm_P10.16mm_Horizontal
R34: 5K; R_Axial_DIN0207_L6.3mm_D2.5mm_P10.16mm_Horizontal
R51: 2.2K; R_Axial_DIN0207_L6.3mm_D2.5mm_P10.16mm_Horizontal
R53: 202R; R_Axial_DIN0207_L6.3mm_D2.5mm_P10.16mm_Horizontal
RV1, RV2, RV3, RV4, RV5, RV6, RV7, RV8: 10K; Potentiometer_Bourns_3296W_Vertical
T1, T6: FT50-74 (22:4); Transformer_Toroid_Horizontal_D14.0mm_Amidon-T50
T2: FT50-75 (18:7); Transformer_Toroid_Horizontal_D14.0mm_Amidon-T50
T3: FT50-75 (7:18); Transformer_Toroid_Horizontal_D14.0mm_Amidon-T50
T4, T5: FT37-43 (1:10); Transformer_Toroid_Horizontal_D14.0mm_Amidon-T50
T7: FT3743(10BFT); Transformer_Toroid_Horizontal_D10.5mm_Amidon-T37
U1, U10: LT1253; DIP-8_W7.62mm
U2, U9, U11: QPR_Filter; QRPLabs_Filter_TH
U3, U4: SA612; DIP-8_W7.62mm_Socket
U5, U6: LM386; DIP-8_W7.62mm_Socket
U7, U8: LM7805; TO-220-3_Vertical
Y1, Y2, Y3, Y4: 12 MHz; Crystal_HC49-4H_Vertical

Connections:
12V: D5.2 (A), D7.1 (K), K3.4, K3.13, R33.2
ANT_OUT: T4.4 (SB), T5.1 (AA)
GND: C1.2, C3.2, C4.2, C5.2, C6.2, C7.2, C8.2, C9.2, C10.2, C11.2, C13.2, C14.2, C17.2, C18.2, C19.2, C22.2, C23.2, C25.2, C26.2, C28.2, C29.2, C32.2, C33.2, C34.2, C35.2, C37.2, C38.2, C42.2, C43.2, C46.2, C47.2, C48.2, C49.2, C50.2, C54.2, C55.2, C56.2, C57.2, C58.2, C59.2, C61.2, C62.2, C63.2, C65.2, C67.2, C68.2, C69.2, C70.2, C71.2, C72.2, C73.2, C75.2, C77.2, C78.2, C80.2, C81.2, C82.2, C83.2, C84.2, D1.2 (A), D2.2 (A), D9.2 (A), D12.2 (A), J1.2 (Ext), J2.2, J3.2, J4.2, J5.2, J6.1, J7.1, J7.3, J8.2, J9.2 (Ext), J10.2 (Ext), J11.2 (Ext), J12.2 (Ext), J13.2, J14.2, J15.1, J16.1, J17.1, J18.1, J19.1, J20.1, J21.1, J22.1, J23.1, J24.1, J25.1, J26.1, J27.1, J28.1, J29.1, J30.1, J31.2 (Ext), K1.16, K2.16, K4.16, Q2.1 (E), Q3.1 (E), Q5.1, R2.2, R16.2, R18.2, R21.1, R23.1, R26.2, R29.1, R30.2, R31.2, R32.2, R36.1, R37.1, R38.1, R39.1, R41.2, R50.1, R52.1, RV3.3, RV4.3, RV5.3, RV8.3, T1.2 (AB), T2.3 (SA), T3.2 (AB), T4.2 (AB), T5.4 (SB), T6.3 (SA), U1.4 (V-), U2.3 (GND), U2.4 (GND), U2.5 (GND), U2.6 (GND), U3.3 (GND), U4.3 (GND), U5.3 (+), U5.4 (GND), U6.3 (+), U6.4 (GND), U7.2 (GND), U8.2 (GND), U9.3 (GND), U9.4 (GND), U9.5 (GND), U9.6 (GND), U10.4 (V-), U11.3 (GND), U11.4 (GND), U11.5 (GND), U11.6 (GND)
IFAFOUT: C30.1, K2.6, K2.11
IFMICIN: C53.1, K1.8, K1.9, RV5.2
IFPAOUT: C64.1, K2.8, K2.9
IFRFIN: K1.6, K1.11, U2.7 (OUT), U2.8 (OUT)
unnamed: 47u1.1, K1.4, K1.13
unnamed: 47u1.2, U3.1 (IN_A)
unnamed: C1.1, C4.1, R1.2, R2.1, R4.2
unnamed: C2.1, J1.1 (In)
unnamed: C2.2, R4.1, U1.3 (InA+)
unnamed: C3.1, R3.2
unnamed: C5.1, R7.2
unnamed: C9.1, D1.1 (K), K1.1, R10.1
unnamed: C10.1, U3.2 (IN_B)
unnamed: C11.1, C13.1, C14.1, R11.2, U3.8 (Vcc)
unnamed: C12.1, U3.5 (OUT_B)
unnamed: C12.2, T2.1 (AA)
unnamed: C15.1, J2.1
unnamed: C15.2, U3.6 (OSC_B)
unnamed: C16.1, T2.2 (AB), T2.4 (SB)
unnamed: C16.2, Y1.1
unnamed: C17.1, Y1.2, Y2.1
unnamed: C18.1, Y2.2, Y3.1
unnamed: C19.1, Y3.2, Y4.1
unnamed: C20.1, Y4.2
unnamed: C20.2, T3.1 (AA), T3.3 (SA)
unnamed: C21.1, T3.4 (SB)
unnamed: C21.2, U4.1 (IN_A)
unnamed: C22.1, U4.2 (IN_B)
unnamed: C23.1, C25.1, C26.1, R12.2, U4.8 (Vcc)
unnamed: C24.1, U4.5 (OUT_B)
unnamed: C24.2, K2.4, K2.13
unnamed: C27.1, J3.1
unnamed: C27.2, U4.6 (OSC_B)
unnamed: C28.1, D2.1 (K), K2.1, R13.1
unnamed: C29.1, R14.2, R15.1, R17.1
unnamed: C30.2, Q1.2 (B), R15.2, R16.1
unnamed: C31.1, Q1.3 (C), R17.2
unnamed: C31.2, R19.1
unnamed: C32.1, Q1.1 (E), R18.1
unnamed: C34.1, U5.7 (BYPASS)
unnamed: C35.1, C37.1, C38.1, R20.2, U5.6 (V+)
unnamed: C36.1, U5.1 (GAIN)
unnamed: C36.2, U5.8 (GAIN)
unnamed: C39.1, C40.1, U5.5
unnamed: C39.2, R21.2
unnamed: C40.2, J4.1
unnamed: C41.2, RV4.1
unnamed: C42.1, C43.1, R22.2, U6.6 (V+)
unnamed: C44.1, U6.1 (GAIN)
unnamed: C44.2, U6.8 (GAIN)
unnamed: C45.1, U6.5
unnamed: C45.2, D3.2 (A), R23.2
unnamed: C46.1, D3.1 (K), J5.1
unnamed: C47.1, C49.1, C50.1, R24.2, R25.1, R28.1
unnamed: C48.1, J6.2, L3.1
unnamed: C51.1, L3.2, R25.2, R26.1
unnamed: C51.2, Q2.2 (B), R27.1
unnamed: C52.1, Q2.3 (C), R27.2, R28.2
unnamed: C52.2, RV5.1
unnamed: C53.2, R29.2
unnamed: C60.1, D8.1 (K), K3.1, R33.1
unnamed: C60.2, D8.2 (A), K3.16, Q3.3 (C)
unnamed: C61.1, D9.1 (K), K4.1, R35.1
unnamed: C62.1, D10.1 (K), J13.1, R38.2
unnamed: C63.1, D11.1 (K), J14.1, R39.2
unnamed: C64.2, T6.1 (AA)
unnamed: C65.1, C68.1, R40.2, R41.1, R43.2
unnamed: C66.1, U9.7 (OUT), U9.8 (OUT)
unnamed: C66.2, R43.1, U10.3 (InA+)
unnamed: C67.1, R42.2
unnamed: C69.1, R46.2
unnamed: C74.2, Q4.2 (B), R49.1, R50.2
unnamed: C76.1, R49.2, R51.1
unnamed: C76.2, C79.1, L4.2, Q4.3 (C), R51.2
unnamed: C77.1, R53.1
unnamed: C79.2, Q5.3, R54.2
unnamed: C80.1, C83.1, R54.1, RV8.2
unnamed: C81.1, L5.2, T7.2 (AB)
unnamed: C84.1, D12.1 (K), R55.2, RV8.1
unnamed: C85.1, T7.4 (SB)
unnamed: C85.2, U11.1 (IN), U11.2 (IN)
unnamed: D4.1 (K), R30.1
unnamed: D5.1 (K), R31.1
unnamed: D6.1 (K), R32.1
unnamed: D7.2 (A), J7.2
unnamed: D10.2 (A), R36.2, T5.3 (SA)
unnamed: D11.2 (A), R37.2, T4.3 (SA), T5.2 (AB)
unnamed: J8.1, R34.2
unnamed: J9.1 (In), K4.6, K4.11
unnamed: J10.1 (In), K4.8, K4.9
unnamed: J11.1 (In), K4.4, K4.13
unnamed: J31.1 (In), U11.7 (OUT), U11.8 (OUT)
unnamed: L1.2, R11.1
unnamed: L2.2, R12.1
unnamed: Q3.2 (B), R34.1
unnamed: Q4.1 (E), R52.2, R53.2
unnamed: Q5.2, T7.1 (AA), T7.3 (SA)
unnamed: R3.1, RV1.2, RV1.3
unnamed: R5.1, RV1.1, U1.2 (InA-)
unnamed: R5.2, R6.1, U1.1 (OutA)
unnamed: R6.2, U1.5 (InB+)
unnamed: R7.1, RV2.2, RV2.3
unnamed: R8.1, R9.1, U1.7 (OutB)
unnamed: R8.2, RV2.1, U1.6 (InB-)
unnamed: R9.2, T1.1 (AA), T1.3 (SA)
unnamed: R42.1, RV6.2, RV6.3
unnamed: R44.1, RV6.1, U10.2 (InA-)
unnamed: R44.2, R45.1, U10.1 (OutA)
unnamed: R45.2, U10.5 (InB+)
unnamed: R46.1, RV7.2, RV7.3
unnamed: R47.1, R48.1, U10.7 (OutB)
unnamed: R47.2, RV7.1, U10.6 (InB-)
unnamed: RV3.2, U5.2 (-)
unnamed: RV4.2, U6.2 (-)
unnamed: T1.4 (SB), U2.1 (IN), U2.2 (IN)
unnamed: T6.2 (AB), T6.4 (SB), U9.1 (IN), U9.2 (IN)
PA_IN: C74.1, R48.2
PA_OUT: J12.1 (In), T4.1 (AA)
RX5V: C6.1, C7.1, C8.1, C56.1, C58.1, L1.1, L2.1, R1.1, U1.8 (V+), U7.3 (VO)
RX12V: C54.1, D4.2 (A), K3.6, K3.11, R14.1, R20.1, R22.1, U7.1 (VI)
SMeterIN: C33.1, C41.1, R19.2, RV3.1
TX5V: C57.1, C59.1, C70.1, C71.1, C72.1, R40.1, U8.3 (VO), U10.8 (V+)
TX12V: C55.1, C73.1, C75.1, C78.1, C82.1, D6.2 (A), K3.8, K3.9, L4.1, L5.1, R10.2, R13.2, R24.1, R35.2, R55.1, U8.1 (VI)
