drajnauth/Phoenix612/(commit log)

2022-09-01 Add Legacy Diptrace
    [AD603 Amp.dip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]
2022-09-01 Add legacy design docs
    [12 Mhz Crystal Data.ods, 12 Mhz Crystal Data.xls, AD603AR OPAMP Slew Rate Calculator.xlsx, Crystal Data 4.91 Nov 2018.xlsx, Crystal Data For New Nov2018 4.91 Crystals.xlsx, Crystal Filter Measurements.ods, Crystal Filter Measurements.xls, Crystal Matching.xlsx]
2022-09-01 Add custom KiCad Lib
2022-09-02 Add AF Stage
    [AF_amp.kicad_sch, IF_stage.kicad_sch, Phoenix612.dsn, Phoenix612.kicad_pcb, Phoenix612.kicad_sch, RF_amp.kicad_sch]
2022-09-03 Continue Migration from D612
    [AF_amp.kicad_sch, AntSwitch.kicad_sch, IF_stage.kicad_sch, MicPreamp.kicad_sch, Phoenix612.dsn, Phoenix612.kicad_pcb, Phoenix612.kicad_sch, PowerSupply.kicad_sch]
2022-09-12 Draft complete
    [Phoenix612.dsn]
2022-10-07 Proto Boards Complete
    [AntSwitch.kicad_sch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]
2023-02-21 Upload 21Mar23
    [AF_Amp.kicad_sch, AF_amp.kicad_sch, AntSwitch.kicad_sch, Audio_Amp.kicad_sch, Final Amp.kicad_sch, Genesis PA Height Map Comparison.xlsx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]
2023-02-22 Update 22Feb23
    [Pre Amp.kicad_sch]
2023-03-09 Update 9Mar23
    [AF_amp.kicad_sch, AntSwitch.kicad_sch, IF_Stage.kicad_sch, MicPreamp.kicad_sch, PA_Driver.kicad_sch, PA_Preamp.kicad_sch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]
2023-03-18 Update 17Mar23
    [AF_amp.kicad_sch, AntSwitch.kicad_sch, IF_Stage.kicad_sch, MicPreamp.kicad_sch, PA_Driver.kicad_sch, PA_Preamp.kicad_sch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]
2023-03-19 Update LT1253 Tx
    [PA_Preamp.kicad_sch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]
2023-03-24 Update 24Mar23
    [AF_amp.kicad_sch, IF_Stage.kicad_sch, MicPreamp.kicad_sch, PA_Preamp.kicad_sch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]
2023-05-08 Cleanup 8May23
    [AF_Amp.kicad_sch, AF_amp.kicad_sch, AntSwitch.kicad_sch, IF_Stage.kicad_sch, MicPreamp.kicad_sch, PA_Driver.kicad_sch, PA_Preamp.kicad_sch, Phoenix612 Complete (PCB) v1.dsn]
2023-05-08 Add Analysis 8May23
    [2SC5706 RD16HHF 10W Comparisons.xlsx, Inductor Analysis.xlsx, PoC PA Measurements v2.xlsx, PoC PA Measurements.xlsx, SMeter Levels.xlsx, Transistor Conduction & Bias v2.xlsx, Transistor Conduction & Bias.xlsx, Transistor Currents and Voltages.xlsx]
